Minghu00/fpga-voice-synth/docs/figures/fig10_photo.png

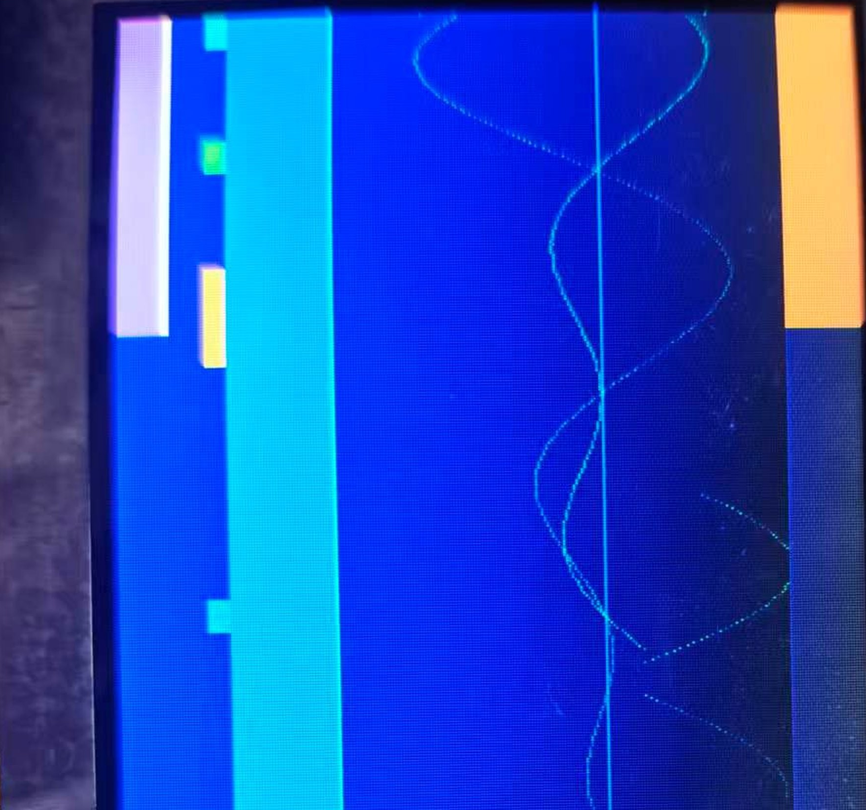
docs/figures/fig10_photo.png
