Minghu00/fpga-voice-synth/docs/figures/fig7_screen.png

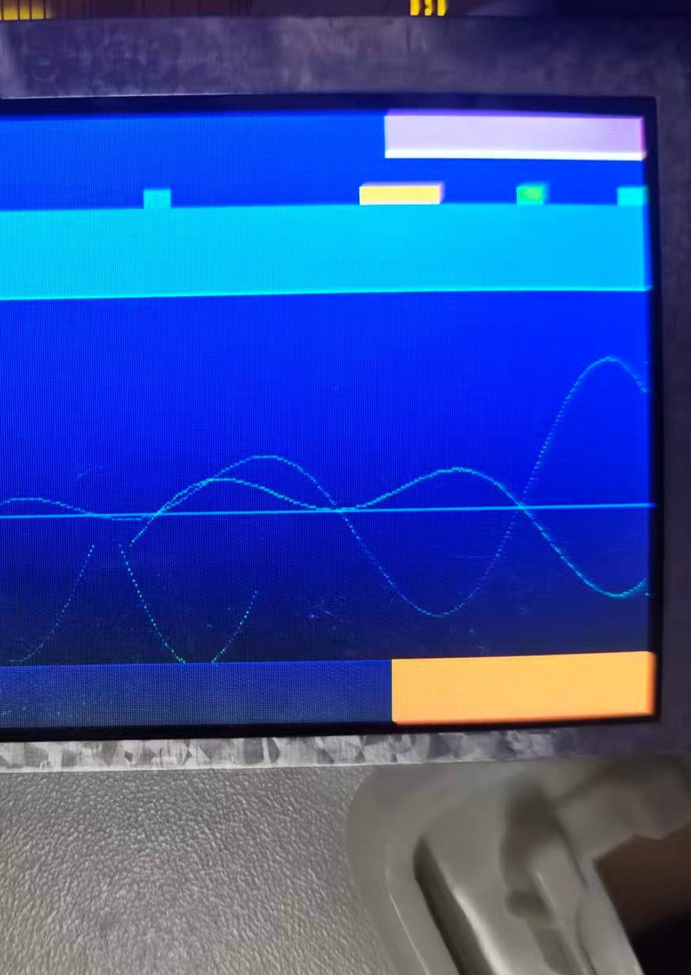
docs/figures/fig7_screen.png
