Minghu00/fpga-voice-synth/docs/datasheet_ttp229/TTP229_SPEC_V1.1(Simplified_Chinese).txt

Preliminary TTP229 
TonTouchTM               

0 9 ’ / 1 2 / 2 1                                    P a g e  1  o f  1 9                                   V e r  :  1 . 1  
16 键/8键触摸检测 IC 
                                             
概述 
 
TTP229 TonTouchTM IC是一款使用电容感应式原理设计的触摸芯片。此芯片内建稳压电路供
触摸传感器使用， 稳定的触摸效果可以应用在各种不同应用上,人体触摸面板可以通过非导电性绝
缘材料连接，主要应用是以取代机械开关或按钮,此芯片可以独立支持8个触摸键或16个触摸键. 
 
特点 
 
 工作电压：2.4V~5.5V（启用内建稳压电路） 
2.0V~5.5V（禁用内建稳压电路） 
 可外部选择启用/禁用内建稳压电路功能 
  待机电流 
3V电压，低速采样率8Hz的睡眠模式下： 
启用内部稳压器，待机电流 
=> 16键模式下典型值2.5uA 
=> 8键模式下典型值2.0uA 
禁用内部稳压器，待机电流 
=> 16键模式下典型值2.5uA 
=> 8键模式下典型值2.0uA 
 提供Option选择8键或16键模式. 
 提供8个直接输出独立端口,仅限于8键直接输出模式下 
 具有两种串行输出方式，可以应用在8个和16个键模式 
   包括2-线串行模式和I2C通讯模式,由option所选择. 
 8个直接输出端口可以选择不同输出类型（CMOS/OD/OC具有高/低电平有效） 
 2-线串行模式可option选择高电平有效或低电平有效 
 提供option选择多键或单键有效功能 
  提供两种采样率，睡眠模式下采样率 8Hz，快速采样率 64Hz 
 具有Option选择有效键最大输出时间大约为80秒. 
 灵敏度可由外部电容（1~50pF）调节 
 上电后需要0.5秒稳定时间 
在此期间内请勿触摸按键面板，所有的功能触摸也无效. 
 自动校准 
当所有按键在一段时间内没有被触摸到时,芯片系统重新校准时间约为4.0秒 

应用 
 
 广泛的消费电子产品 
 按钮取代 
 
Preliminary TTP229 
TonTouchTM               

0 9 ’ / 1 2 / 2 1                                    P a g e  2  o f  1 9                                   V e r  :  1 . 1  
方块图 
 
封装配置 
REGEN
VSS
ENSLP
VREG
VDD
TP4
TP5
SENADJ1
TP6
TP7
SLSERT
A0
A1
A2
TEST
TP8
TP9
SENADJ2
TP10TP11
SLPSENB
SCL
SDO
SDA
TP12
TP13
SENADJ3
TP14
TP15
TP0
TP1
SENADJ0
TP2
TP3
SLPSENA
(SSOP-48)
TTP229
48
47
46
45
44
43
42
41
40
39
38
37
36
35
34
33
32
31
30
29
28
27
26
2524
23
22
21
20
19
18
17
16
15
14
13
12
11
10
9
8
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
 
I2C总线接口 
控制电路 SDA
SDO
SCL
A2 
A1 
A0 
TEST 
SLSERT 
ENSLP 
REGE
唤醒检测
控制电路
SLPSENB 
SLPSENA 
SENADJ3
SENADJ2
TP15
TP14
TP13
TP12
TP11
TP10
TP9
TP8
串行输出缓冲 
和 
控制电路 
系统上电电路
输出缓冲 
和 
感应输入电路 
系统晶振电路
计时计数 
按键扫描 
和 
功能控制电路
稳压器电路 VREG 
功能选项
控制电路
感应端口
和 
检测电路
TP7 
TP6 
TP5 
TP4 
SENADJ1 
TP3 
TP2 
TP1 
TP0 
SENADJ0 
Preliminary TTP229 
TonTouchTM               

0 9 ’ / 1 2 / 2 1                                    P a g e  3  o f  1 9                                   V e r  :  1 . 1  
管脚定义 
管脚号 管脚名 共用端口 I/O 类型 管脚描述 
1 TP15 TPQ7 I/O/OD 16 键模式下触摸输入端口(KEY-15) 
8 键模式下直接输出端口(TPQ7) 
2 TP14 TPQ6 I/O/OD 16 键模式触摸输入端口(KEY-14) 
8 键模式直接输出端口(TPQ6) 
3 SENADJ3  I/O 触摸键 TP12~15灵敏度调节共用端口 
4 TP13 TPQ5 I/O/OD 16 键模式触摸输入端口(KEY-13) 
8 键模式直接输出端口(TPQ5) 
5 TP12 TPQ4 I/O/OD 16 键模式触摸输入端口(KEY-12) 
8 键模式直接输出端口(TPQ4) 
6 SDA  I/OD 在 I2C串行通讯方式下为数据端口 
7 SDO  O 在 2-线串行通讯方式下为数据输出端口，由 TP1 可选
高/低电平有效 
8 SCL  I 串行时钟输入端口 
2-线串行模式下可由 TP1选择低/高电平有效 
9 SLPSENB  I/O 睡眠模式 B组(TP8~15)灵敏度调节端口 
10 TP11 TPQ3 I/O/OD 16 键模式触摸输入端口(KEY-11) 
8 键模式直接输出端口(TPQ3) 
11 TP10 TPQ2 I/O/OD 16 键模式触摸输入端口(KEY-10)  
8 键模式直接输出端口(TPQ2) 
12 SENADJ2  I/O 触摸键 TP8~11灵敏度调节共用端口 
13 TP9 TPQ1 I/O/OD 16 键模式触摸输入端口(KEY-9) 
8 键模式直接输出端口(TPQ1) 
14 TP8 TPQ0 I/O/OD 触摸键输入端口(KEY-8) 
8 键模式直接输出端口(TPQ0) 
15 TEST  I-PL 仅供测试使用 
16 A2  I-PH A2~0 是选择 I2C总线设备地址的输入端口 
17 A1  I-PH A2~0 是选择 I2C总线设备地址的输入端口 
18 A0  I-PH A2~0 是选择 I2C总线设备地址的输入端口 
19 SLSERT  I-PH 串行输出类型的选择端口 
默认 2-线串行传输 
20 TP7 SKSRT I/O 触摸键输入端口(KEY-7) 
有效按键最长输出时间选择(无穷大/80 秒) 
默认为无穷大 
21 TP6 SLWPTM I/O 触摸键输入端口(KEY-6) 
睡眠模式采样时间功能选项(4.0/2.0毫秒) 
默认 4.0 毫秒 
22 SENADJ1  I/O 触摸键 TP4~7灵敏度调节共用端口 
 
Preliminary TTP229 
TonTouchTM               

0 9 ’ / 1 2 / 2 1                                    P a g e  4  o f  1 9                                   V e r  :  1 . 1  
 
管脚号 管脚名 共用端口 I/O 类型 管脚描述 
23 TP5 WPSCT I/O 触摸键输入端口(KEY-5) 
睡眠模式采样率功能选项(8Hz/64Hz) 
默认为 8Hz 
24 TP4 SKMS0 I/O 触摸键输入端口(KEY-4) 
按键有效功能选项 0(单键/多键) 
默认全部单键有效 
25 VDD  P 供电电源正极 
26 VREG  P 内部稳压电路输出端口 
27 ENSLP  I-PH 睡眠模式启用/禁用功能选项 
默认为启用 
28 VSS  P 供电电源负极，接地端 
29 REGEN  I-PH 内部稳压电路启用/禁用功能选项 
默认为启用 
30 SLPSENA  I/O 睡眠模式 A组(TP0~7)灵敏度调节端口 
31 TP3 SKMS1 I/O 触摸键输入端口(KEY-3) 
按键有效功能选项 1(单键/多键) 
默认为全部单键 
32 TP2 KYSEL I/O 触摸键输入端口(KEY-2) 
按键数目功能选项(8 键/16 键) 
默认为 8 键 
33 SENADJ0  I/O 触摸键 TP0~3灵敏度调节共用端口 
34 TP1 SAHL I/O 触摸键输入端口(KEY-1) 
输出类型功能选项(高/低电平有效) 
默认 TPQ0~7 高电平有效，2-线串行低电平有效(SCL
和 SDO) 
35 TP0 OPDEN I/O 触摸键输入端口(KEY-0) 
输出类型功能选项 (CMOS/OD/OC 在 8 键模式)  
默认为 CMOS 
 
  备注：端口类型 
I     ＝＞仅CMOS输入 
I-PH  ＝＞CMOS输入带上拉电阻 
I-PL  ＝＞CMOS输入带下拉电阻 
O    ＝＞CMOS输出 
I/O   ＝＞CMOS输入/输出 
P     ＝＞电源/地 
OD   ＝＞CMOS漏极开路(Open Drain)输出 
(OD输出下，TPQ0~TPQ7 端口具有二极管保护电路，SDA 端口无二极管保护电路) 
Preliminary TTP229 
TonTouchTM               

0 9 ’ / 1 2 / 2 1                                    P a g e  5  o f  1 9                                   V e r  :  1 . 1  
PAD 图 

芯片尺寸：1700um x 1820um 
衬底悬空(建议)或连接至VSS 
 
PAD 坐标 
Pad NO. Pad Name X Y Pad NO. Pad Name X Y 
1 TP15 -750.00 95.15 19 SLSERT   750.00  -335.35 
2 TP14 -750.00 -28.85 20 TP7   750.00  -218.35 
3 SENADJ3 -750.00 -369.50 21 TP6   750.00  -101.35 
4 TP13 -750.00 -493.50 22 SENADJ1   750.00    15.65 
5 TP12 -750.00 -617.50 23 TP5   750.00   438.60 
6 SDA -539.90 -810.00 24 TP4   750.00   555.60 
7 SDO -424.90 -810.00 25 VDD   675.85   810.00 
8 SCL -309.90 -810.00 26 VREG   558.85   810.00 
9 SLPSENB -194.90 -810.00 27 ENSLP   421.15   810.00 
10 TP11 -79.90 -810.00 28 VSS   304.15   810.00 
11 TP10 35.10 -810.00 29 REGEN   187.15   810.00 
12 SENADJ2 150.10 -810.00 30 SLPSENA  -460.85   810.00 
13 TP9 265.10 -810.00 31 TP3  -577.85   810.00 
14 TP8 380.10 -810.00 32 TP2  -750.00   591.15 
15 TEST 495.10 -810.00 33 SENADJ0  -750.00   467.15 
16 A2 750.00 -686.35 34 TP1  -750.00   343.15 
17 A1 750.00 -569.35 35 TP0  -750.00   219.15 
18 A0 750.00 -452.35     
Preliminary TTP229 
TonTouchTM               

0 9 ’ / 1 2 / 2 1                                    P a g e  6  o f  1 9                                   V e r  :  1 . 1  
电气特性 
‧最大绝对额定值 
 
‧AC/DC特性：(测试条件为室内温度=25℃) 
 
参数 符号 条件 数值 单位 
工作温度 TOP ─ -40 ~ +85 ℃ 
储存温度 TSTG ─ -50 ~ +125 ℃ 
电源电压 VDD Ta=25°C VSS-0.3 ~ VSS+6.0 V 
输入电压 VIN Ta=25°C VSS-0.3 to VDD+0.3 V 
抗静电能力HBM ESD ─ 6 KV 
备注：VSS表示系统接地 
参数 符号 测试条件 最小 典型 最大 单位
工作电压 VDD 内部稳压电路禁用 2.0 - 5.5 V 
工作电压 VDD 内部稳压电路启用 2.4 - 5.5 V 
内部稳压电路输出 VREG  2.2 2.3 2.4 V 
稳压电路启用  20  工作电流 
(无负载) 
IOP VDD 
=3.0V 稳压电路禁用  25  
uA 
稳压电路启用  2.0  8 键
稳压电路禁用  2.0  
稳压电路启用  2.5  
采样率
8Hz 
16键
稳压电路禁用  2.5  
稳压电路启用  5.5  8 键
稳压电路禁用  5.5  
稳压电路启用  9.0  
待机电流 
(VDD=3.0V) 
(采样时间 4.0 毫秒) 

ISD 采样率
64Hz 
16 键
稳压电路禁用  9.5  

uA 
 
输入端口 VIL 输入低电压范围 0 - 0.2 VDD
输入端口 VIH 输入高电压范围 0.8 - 1.0 VDD
输出端口灌电流（Sink Current） IOL VDD=3V , V OL=0.6V - 8 - mA
输出端口拉电流（Source Current） IOH VDD=3V , V OH=2.4V - -4 - mA
VDD=3V , 采样率 8Hz  125  mS 唤醒响应时间 
(睡眠模式下) 
TWU 
VDD=3V , 采样率 64Hz  15.6  mS 
VDD=3V , 设为 16 键模式  32  mS 输出响应时间 
(工作状态下) 
TR 
VDD=3V , 设为 8 键模式  16  mS 
有效键最大输出时间 TMOT  50 80 110 Sec 
输入端口上拉电阻 
(REGEN, SLSERT, ENSLP, 
A0~A2) 
RPH VDD=3V ,  30K  ohm
输入端口下拉电阻 
(TEST) 
RPL VDD=3V ,  30K  ohm
Preliminary TTP229 
TonTouchTM               

0 9 ’ / 1 2 / 2 1                                    P a g e  7  o f  1 9                                   V e r  :  1 . 1  
功能描述 
1. 灵敏度调节 
  P C B板上之感应焊盘尺寸大小及走线会直接影响灵敏度,因此灵敏度调节需要根据实际应用的
PCB应进行调节,TTP229提供一些外部调节灵敏度的方法。 
1-1 改变感应焊盘尺寸大小 
若其他条件固定不变,使用一个较大的感应焊盘将会增大其灵敏度,反之灵敏度将下降,但是
感应焊盘的尺寸大小也必须是在其有效范围值内.。 
1-2 改变面板厚度. 
若其他条件固定不变,使用一个较薄的面板也会将灵敏度提高,反之灵敏度则下降.但是面板
的厚度必须低于其最大值。 
1-3 通过调节外接电容(参见下图1-3-1) 
当其他条件固定时，在可用范围(1pF≦CJ0~CJ3≦50pF, 1pF≦CJWA~CJWB≦50pF)内增大
CJ0~CJ3，CJWA和CJWB的值将降低灵敏度。当不连接任何电容，即在电容连接处处于悬
空其灵敏度为最大。电容CJ0~CJ3用于调节工作模式下按键的灵敏度。电容CJWA和CJWB
用于调节睡眠模式下唤醒灵敏度。  
至于各电容与各键其关系如下表 
电容 可控制和调节的按键组合 
CJ0 K0~K3 组 
CJ1 K4~K7 组 
CJ2 K8~K11组 
CJ3 K12~K15组 
CJWA K0~K7组 
CJWB K8~K15组 
备注：当使用电容调节灵敏度时，建议先调节CJ0~CJ3的容值去调节K0~K15的灵敏度，然
后再调节CJWA和CJWB的容值去调节唤醒灵敏度。 
 
                                   图 1-3-1 
触摸焊盘 
SDO
A0
A1
A2
SCL
SDA
CJWB
SLPSENB
VREG
SLSERT
ENSLP
TEST
REGEN
CJWA 
K12 
K11 
K10 
K9 
K8 
K15 
K14 
K13 
CJ3
SLPSENA
K7 
K6 
K5 
K4 
CJ1 
VSS
TP9
TP8
SENADJ0
TP0
TP7
TP6
TP5
TP4
TP3
TP2
TP1
VDD
SENADJ1
TP15
TP14
TP13
TP12
SENADJ3
TP11
TP10
SENADJ2
CJ2CJ0
K3 
K2 
K1 
K0 
Preliminary TTP229 
TonTouchTM               

0 9 ’ / 1 2 / 2 1                                    P a g e  8  o f  1 9                                   V e r  :  1 . 1  
2. 输入按键数目选择 
     T T P 2 2 9 具有 8 键输入模式和 16 键输入模式。两者是通过 TP2(KYSEL)是否连接高阻值电阻到
VSS所决定。默认为 TP2(KYSEL)不连接电阻到 VSS选定为 8 键输入模式,16 键输入模式是连接
高阻值电阻到 VSS。 
 
3. 输出模式 
     T T P 2 2 9 具有 8 端口直接输出模式和两种串行输出模式。16 键输入模式下只能使用串行输出方
式。8 键输入模式下可使用两种输出方式，为 8 端口直接输出和串行输出方式。8 端口直接输
出方式只能应用在 8 键直接输出模式下。两种串行输出方式包括 I2C和 2-线串行通讯方式。此
两种方式共用 SCL作为时钟输入端口。这两种模式通过SLSERT选择，同一时间只能选择一种
通讯方式。SLSERT悬空(默认)或连接到 VDD将设置为 2-线串行通讯方式，当SLSERT链接到
VSS时，设置为 I2C 通讯方式。 
 
     3 - 1  在 8 端口直接输出模式下，TTP229具有两种输出类型，CMOS类型输出和 OD(漏极开路)
类型输出。这两者通过 TP0(OPDEN)选择。默认为 CMOS类型，即 TP0(OPDEN)不连接高阻值
电阻到 VSS。当 TP0(OPDEN) 连接高阻值电阻到 VSS 时，选择为 OD类型输出。 
 
     3-2 当选用 8 端口直接 COMS输出模式，输出有效电平可以通过 TP1(SAHL) 端口设置为高电
平有效或低电平有效。默认 TP1(SAHL) 端口不连接高阻值电阻到 VSS，输出设置为高电平有效。
当 TP1(SAHL) 端口连接高阻值电阻到 VSS 时，输出设置为低电平有效。 
 
     3-3 在 8 端口直接 OD输出模式下，可通过 TP1(SAHL) 端口选择为 OD(漏极开路)或 OC(集极
开路) 输出方式。若 TP1(SAHL) 端口连接高阻值电阻到 VSS，即选为 OC输出模式。若不连接
高阻值电阻则选用默认的 OD输出模式。OD 模式下其平常为悬浮状态, 输出为低电平有效，
OC模式下其平常为悬浮状态, 输出为高电平有效。OD 和 OC输出模式的结构如下图。 
P
N
Control
Control
TPQ0~7
OC ModeOD Mode
TPQ0~7
 
备注：芯片输出端口内部具有二极管保护电路,因此当选用 OD或 OC 输出模式时,为避免系统内
部漏电流, 请不要与不同电压的系统直接连接. 
 
     3-4 2-线串行输出通讯方式可由 SLSERT 端口是否悬空或连接到 VDD选定。在此模式下，SDO 
端口为数据输出端口，SCL是时钟输入端口，两者皆可由 TP1(SAHL) 端口选择为高电平有效还
是低电平有效。 默认为TP1(SAHL) 端口不连接高阻值电阻到 VSS设置为低电平有效。 若连接高
阻值电阻到 VSS，则设置为高电平有效。 
      
2-线串行输出方式它支持连续接受其它系统送给的数据，也可以让其他设备等待 TTP229 通过
SDO 端口送出的数据信号(DV)，然后再送出时钟信号到 TTP229 的 SCL 端口并从 SDO 端口
取得按键数据。 
 
     T T P 2 2 9 的 2-线串行通讯方式对 SCL 端口设有时间的限制。如果 SCL 端口超过 2ms信号没有
变化，系统将会自行回到待机模式。 

Preliminary TTP229 
TonTouchTM               

0 9 ’ / 1 2 / 2 1                                    P a g e  9  o f  1 9                                   V e r  :  1 . 1  
2-线串行通讯方式时序如下图所示： 
D0~D15对应于 TP0~TP15 上数据。 
  3-4-1. 当TP1=0，TP2=0：设置为16键模式，高电平有效 
Tw TwTout
T_resp
DVDV
SDO
SCL
F_SCL
D0 D1
C_1C_0
D0 D1
C_1C_0
D12D11D10D9D8D7D6D5D4D3D2 D13 D14 D15
C_15C_14C_13C_12C_11C_10C_9C_8C_7C_6C_5C_4C_3C_2
 
                     图3-4-1：16键输入，高电平有效时序 
 
  3-4-2. 当TP1=1，TP2=0：设置为16键模式，低电平有效 
TwToutTw
T_resp
DVDV
SDO
SCL
F_SCL
D0 D1
C_1C_0
D0 D1
C_1C_0
D12D11D10D9D8D7D6D5D4D3D2 D13 D14 D15
C_15C_14C_13C_12C_11C_10C_9C_8C_7C_6C_5C_4C_3C_2
 
                     图3-4-2：16键输入，低电平有效时序 
 
3-4-3. 当TP1=0，TP2=1：设置为8键模式，为高电平有效  
 
                     图3-4-3：8键输入，高电平有效时序 
 
  3-4-4. 当TP1=1，TP2=1：设置为8键模式，低电平有效
Tw TwTout
T_resp
DV
D0 D1
C_1C_0
DV
SDO
SCL
F_SCL
D0 D1
C_1C_0
D7D6D5D4D3D2
C_7C_6C_5C_4C_3C_2
 
                     图3-4-4：8输入键，低电平有效时序 
 
  图3-4-1~4中参数 
参数 最小值 典型值 最大值 单位 
DV - 93 - us 
Tw 10 - - us 
Tout - 2 - ms 
T_resp(16键) - 32 - ms 
T_resp(8键) - 16 - ms 
F_SCL 1K - 512K Hz 
Tw TwTout
T_resp
DV
D0 D1
C_1C_0
DV
SDO
SCL
F_SCL
D0 D1
C_1C_0
D7D6D5D4D3D2
C_7C_6C_5C_4C_3C_2
Preliminary TTP229 
TonTouchTM               

0 9 ’ / 1 2 / 2 1                                    P a g e  1 0  o f  1 9                                   V e r  :  1 . 1  
3-5 至于选择为 I2C通讯方式，需要将 SLSERT 端口连接到 VSS。 
此模式下 SDA 端口作为串行数据端口，SCL 作为串行时钟输入端口。SDA和 SCL 端口必须
通过外部电阻拉至高电平。 
 
TTP229的 4 位鉴别码是“1010”, 设备地址由 A0，A1 和 A2 端口的状态确定。这三个端口具
有内部上拉电阻，可由外部设定为 0。TTP229 的 8 位设备地址包含 4 位鉴别码，3 位地址选定
和 R/W位组成(参见表 3-5-1)。 
 
由于 TTP229 IC 使用 I2C通讯协议方式输出触摸键(TP0~TP15 端口)的数据，因此TTP229 只接
受读操作 R/W位是”1” 的数据”。如果为“0”，TTP229 将不响应写操作。除此之外，TTP229
的 I2C通讯协议符合标准的 I2C通讯协议。它支持最大 SCL时钟频率为 400KHz的快速模式。 
I2C通讯方式协议如下： 
 
总线空闲状态：当总线空闲时 SDA 和 SCL 保持在高电平。 
起始条件：开始条件是当 SCL=1 时，SDA 由 1 跳转到 0。(参见图 3-5-2) 
终止条件：停止条件是当 SCL=1 时，SDA 由 0 跳转到 1。(参见图 3-5-2) 
数据有效条件：开始条件成立后，SDA pin上的电平在 SCL为高电平期间内必须稳定。SDA pin
上的高低电平只有在 SCL线上时钟信号为低电平时可以改变。(参见图 3-5-2) 
 
回应(确认)：一个 ACK信号表示成功完成数据传输。传输方（主设备或从设备）在传输八个二
进制位后释放总线。 在主设备发出的第九个时钟周期接收方将SDA 线拉至低电平， 以确认成功
接收数据的八个二进制位。从设备没有成功接收到数据的八个二进制位时，将不会发送 ACK
信号。 
 
在数据读取操作，从设备在传输完 8 位数据后释放 SDA 线，然后在第九个时钟周期监察 ACK
信号。若检测到 ACK信号，从设备将继续传送下一个数据。若没有检测到 ACK信号，从设备
中止数据传送，并在回到待机模式前等待主设备发起停止条件。 

从设备地址： TTP229 的鉴别码是“(1010)”。设备地址可由 A2，A1和 A0 端口的状态设定。 
读/写：从设备地址的最后一位（第八位）定义将进行的操作类型。如果 R/W 位是“1”，将执
行读操作，如果是“0”，则执行写操作。但 TTP229只接受读操作。 
读数据操作的顺序参照图 3-5-1。 
  
表 3-5-1. 从设备寻址 
设备鉴别码 设备地址 R/W 位 设备 
B7 B6 B5 B4 B3 B2 B1 B0 
TTP229 1 0 1 0 A2 A1 A0 R 
 
Preliminary TTP229 
TonTouchTM               

0 9 ’ / 1 2 / 2 1                                    P a g e  1 1  o f  1 9                                   V e r  :  1 . 1  
 
   备注：Data_0：B7~B0对应TP0~TP7 闭合/断开状态，0为按键断开，1为按键闭合。 
        D a t a _ 1 ：B7~B0对应TP8~TP15 闭合/断开状态，0为按键断开，1为按键闭合。 
图3-5-1. 读操作顺序 

                         图3-5-2. 数据传输顺序 

                         图3-5-3. 一次完整的数据传送 
BUFt
SU;STO
rtrt
t
HD;STAt
SU;STAt
ftft SU;DATt
HIGHtHD;STAt HD;DATt
LOWt
SPSrS
SCL
SDA
 
               图3-5-4. I2C总线上F/S模式设备的时序定义 
 
起始 
条件 
终止
条件
ACK 数据ACK数据ACK R/W 地址 
S P
9 9 8 8 1 - 71 - 79 8 1 - 7 SCL 
SDA 
起始条件 
P
终止条件数据变化数据或 
合法 ACK
SCL 
S 
SDA 
8键输入模式
终止Data_0起始 从设备地址 
B0B1B2B3B4B5B6B7 R A0 A1A2 
16键输入模式
主设备 
发送的 
NOT ACK 
主设备
发送的
ACK
从设备 
发送的 
ACK 
起始 从设备地址 Data_0 Data_1 终止
B0 B1 B2 B3B4B5B6B7B0B1B2B3B4B5B6B7 R A0 A1A2 
从设备 
发送的 
ACK 
主设备 
发送的 
NOT ACK
Preliminary TTP229 
TonTouchTM               

0 9 ’ / 1 2 / 2 1                                    P a g e  1 2  o f  1 9                                   V e r  :  1 . 1  
 表3-5-2. I2C总线F/S模式设备的SDA和SCL总线连线特性 
标准模式 快速模式 参数 符号 
最小值 最大值 最小值 最大值 
单位
SCL时钟频率 f SCL  100  400 KHz 
SCL时钟的低电平时间 t LOW 4.7  1.3  us 
SCL时钟的高电平时间 t HIGH 4.0  0.6  us 
起始条件保持时间（重复） t HD;STA 4.0  0.6  us 
起始条件建立时间 t SU;STA 4.7  0.6  us 
数据保持时间 t HD;DAT 0  0  us 
数据建立时间 t SU;DAT 250  100  ns 
SDA和SCL信号的上升时间 t r  1000  300 ns 
SDA和SCL信号的下降时间 t f  300  300 ns 
终止条件建立时间 t SU;STO 4.0  0.6  us 
一次终止条件和起始条件之间总
线空闲时间 
tBUF 4.7  1.3  us 
单条总线连线上容性负载 C b  400  400 pF 
 
4. 按键工作模式 
     T T P 2 2 9 具备单键有效和多键有效功能。这些功能由TP3(SKMS1)和 TP4(SKMS0) 端口设定。全部
16 个按键可分为一组或两组进行设置。第一组包括 TP0，TP1，TP2，TP3，TP8，TP9，TP10，
TP11按键。组-2 包括 TP4，TP5，TP6，TP7，TP12，TP13，TP14，TP15 按键。设置方式参见
表 4-1： 
     表 4-1. TP3(SKMS1)和 TP4(SKMS0)选项功能如下: 
TP3 
(SKMS1) 
TP4 
(SKMS0) 
功能说明 
0 0 全部多键有效：设定为一组（16键） 
0 1 设置为2组：第一组=>单键；第二组=>多键 
1 0 设置为2组：第一组=>单键；第二组=>单键 
1 1 全部单键有效：一组（16键） 
     备注：1. 设定为一组: 
其包括：TP0~TP15。 
             设定为二组： 
第一组其包括=>TP0，TP1，TP2，TP3，TP8，TP9，TP10，TP11。 
             第二组其包括=>TP4，TP5，TP6，TP7，TP12，TP13，TP14，TP15。 
           2 .  当使用 8 模式时 TP0~TP7 为输入键。 
           3 .  T P 3 和 TP4的选择状态，“0”状态是指连接高阻值电阻到 VSS，“1”状态是不连接高
阻值电阻到 VSS。 
           4 .  在单键有效功能下， 键的检测承认优先权是依键的扫描顺序(从 TP0 到 TP15)， 当同时
多键被有效触摸。不是依照键被触摸的强度。 
Preliminary TTP229 
TonTouchTM               

0 9 ’ / 1 2 / 2 1                                    P a g e  1 3  o f  1 9                                   V e r  :  1 . 1  
5. 睡眠模式的唤醒采样率和采样长度 
TTP229在睡眠模式具有两种采样率， 分别是8Hz和 64Hz。 这两种功能由TP5(SLWPTM) 端口选
择。TP5(SLWPTM) 端口连接高阻值电阻到 VSS时，选择为 64Hz采样率。当不连接高阻值电阻
到 VSS时，将默认选为 8Hz采样率。 
 
     T T P 2 2 9 在睡眠模式下有两种采样长度，分别是 4ms和 2ms，由 TP6(WPSCT) 端口选定。默认情
形下 TP6(WPSCT) 端口不连接高阻值电阻到 VSS，将选择为 4ms。若 TP6连接高阻值电阻到 VSS
时将设定为 2ms。 
 
睡眠模式的唤醒采样率和采样长度： 

6. 有效键最长输出时间 
如果因其它非正常因素造成有物体触摸到键并且电容量改变足够以被承认为有效触摸,会使其
一直动作,为了防止此类现象的发生，所以 TTP229设计了有效键最长输出时间设定电路,此计
时即为有效按键最长输出时间，若 VDD为 3V时大约为 80 秒。当物体触摸时间超过所设定时
间时，系统将会返回到上电初始化状态并停止输出直到下一次被触摸时,此功能由 TP7(SKSRT) 
端口连接高阻值电阻到 VSS所设定。默认为 TP7(SKSRT) 端口不连接高阻值电阻到 VSS，将设
置为禁用最长输出时间设定，此时按键时间为无穷大。若连接高阻值电阻到VSS 时，则启用有
效键最长输出时间设定功能。 
 
若系统同时使用有效键最长输出时间设定和 2-线串行通讯方式功能时， 它只能使用接受其它
系统连续送数据的通讯方式。 
 
7. 外部选择启用/禁用内建稳压电路 
电容式触摸 IC 要求需要稳定的电源，因此TTP229在芯片内设置了稳压电路。此稳压电路可以
使内部电源稳定,维持芯片检测灵敏度一致。稳定的电源能避免其灵敏度异常导致错误的触发。 
内建稳压电路可通过 REGEN 端口设置为启用或禁用。当 REGEN 端口连接到 VDD或悬空时，
将启用内部稳压电路。当 REGEN 连接到 VSS 时，则禁用内部稳压电路。当内部稳压电路被禁
用时，必须将 VREG 端口连接到外部 VDD。 
   
8. 自动校准功能 
  TTP229具备自校准功能, 系统上电时将首先对起始环境做自动校准。在此期间，所有的功能都
被禁用，因此请不要对PAD做触摸或其他操作。此后系统进入到待机模式。若所有的按键在4
秒内没有检测到触摸，系统将会自动重新校准。此过程将持续重复进行。此自动重新校准的特
性实现了使系统随环境变化，系统可以正常工作的目的。 
 
或 
8Hz=>125ms 
4.0ms或 2.0ms64Hz=>15.6ms 
唤醒 
检测 
时钟 
Preliminary TTP229 
TonTouchTM               

0 9 ’ / 1 2 / 2 1                                    P a g e  1 4  o f  1 9                                   V e r  :  1 . 1  
9. 由睡眠模式转到工作模式的时序图  

 图9-1. 错误触发的时序 

 图9-2. 正确触发的时序 
 
有效触发 
当检测到按键释放且约 8 秒没有触发 
约 4 秒约 4 秒
睡眠模式
重校准 重校准
检测按键 
输出 
唤醒检测 
周期 
睡眠模式 
工作模式
手指触发 
按键扫描 
周期 
重校准 
唤醒检测 
周期 
睡眠模式
约 4 秒时间约 4 秒时间 
重校准
按键扫描 
错误触发 
睡眠模式 
检测按键 
输出 
手指触发 
按键扫描 
周期 
Preliminary TTP229 
TonTouchTM               

0 9 ’ / 1 2 / 2 1                                    P a g e  1 5  o f  1 9                                   V e r  :  1 . 1  
10. 选项表格 
选项表格： 
选项端口 选项状态 特性 注释 
TP0 
(OPDEN) 
TP1 
(SAHL)
1 1 

8 pin 直接输出模式=> CMOS高电平有效输出 
2-线串行输出 => CMOS 低电平有效输出 
 
默认 
1 0 8 pin 直接输出模式=> CMOS低电平有效输出 
2-线串行输出=> CMOS高电平有效输出 
 
0 1 8 pin 直接输出模式=> OD低电平有效输出 
2-线串行输出=> CMOS低电平有效输出 

TP0 
(OPDEN) 

TP1 
(SAHL) 
0 0 8 pin 直接输出模式=> OC高电平有效输出 
2-线串行输出=> CMOS高电平有效输出 
 
1 8 键输入模式 默认 TP2 
(KYSEL) 0 16 键输入模式  
TP3 
(SKMS1) 
TP4 
(SKMS0) 
1 1 
 
全部单键有效：设定为一组（16 键） 
 
默认 
1 0 设定为二组： 
第一组=>单键；第二组=>单键 
 
0 1 两组操作： 
组-1=>单键；组-2=>多键 

TP3 
(SKMS1) 

TP4 
(SKMS0) 
0 0 全部多键有效：设定为一组（16 键）  
1 睡眠模式下 8Hz唤醒采样率 默认 TP5 
(WPSCT) 0 睡眠模式下 64Hz唤醒采样率  
1 唤醒采样长度=>约 4.0ms 默认 TP6 
(SLWPTM) 0 唤醒采样长度=>约 2.0ms  
1 禁用有效按键最大输出时间设定=>无穷大 默认 TP7 
(SKSRT) 0 启用有效按键最大输出时间设定=>80 秒  
1 启用内部稳压电路 默认  
REGEN 0 禁用内部稳压电路  
1 串行输出通讯类型选择=>2-线串行通讯方式 默认  
SLSERT 0 串行输出通讯类型选择=>I2C通讯方式  
1 启用睡眠模式 默认  
ENSLP 0 禁用睡眠模式  
备注：1. 关于第一组和第二组的组成，请参照上面第4点。 
2. 选项中状态“1”表示内部上拉（默认） 
      3 .  选项中状态“0”表示TP0~TP7 端口连接高阻值电阻到VSS，另外REGEN，SLSERT和
ENSLP 端口是可以直接连接到VSS。 
Preliminary TTP229 
TonTouchTM               

0 9 ’ / 1 2 / 2 1                                    P a g e  1 6  o f  1 9                                   V e r  :  1 . 1  
应用电路 
                                1 6 键模式参考应用电路图 
 
SKSRT
SLWPTM
WPSCT
SKMS0
SKMS1
KYSEL
SAHL
K12
CJWB
CJWA
TCP229
ELECTRODE
SLSERT
SENADJ1
SLPSENA
SENADJ0
SENADJ3
SLPSENB
SENADJ2
K9
K8
K10
RP7
K7
RP6
K6
RP5
RP4
K5
K13
K14
CJ1
VDD
CJ2
CJ0
K0
RP1
K1
K2
RP2
RP3
104
C1
CJ3
K11
K4
K3
K15
35
34
33
32
31 30 29 28 27 26 25
24
23
22
21
20
19
18
17
16
1514131211109876
5
4
3
2
1
TEST
TP8
TP9
TP10
TP11
SDA
SCL
SDO
TP12
TP13
A2
A1
A0
TP7
TP6
TP5
TP4
VDD
VREG
ENSLP
VSS
REGEN
TP3
TP2
TP1
TP0
TP14
TP15

Preliminary TTP229 
TonTouchTM               

0 9 ’ / 1 2 / 2 1                                    P a g e  1 7  o f  1 9                                   V e r  :  1 . 1  
                            8 键模式参考应用电路图 
 
SKSRT
SLWPTM
WPSCT
SKMS0
SKMS1
SAHL
OPDEN
CJWA
TPQ7
TPQ6
TPQ5
TPQ4
TPQ0
TPQ1
TPQ2
TPQ3
TCP229
ELECTRODE
SLSERT
SENADJ1
SLPSENA
SENADJ0
SENADJ3
SLPSENB
SENADJ2
RP1
RP0
RP7
K7
RP6
K6
RP5
RP4
K5
CJ1
VDD
CJ0
K0
K1
K2
RP3
104
C1
K4
K3
35
34
33
32
31 30 29 28 27 26 25
24
23
22
21
20
19
18
17
16
1514131211109876
5
4
3
2
1
TEST
TP8
TP9
TP10
TP11
SDA
SCL
SDO
TP12
TP13
A2
A1
A0
TP7
TP6
TP5
TP4
VDD
VREG
ENSLP
VSS
REGEN
TP3
TP2
TP1
TP0
TP14
TP15

 附注：1. 在 PCB上，感应焊盘距离 IC 端口的连线长度越短越好。 
          并且每根感应线不能平行交叉。 
       2 .  电源必须稳定,如果电压不稳定,可能会造成灵敏度异常或错误的触发。 
       3 .  覆盖在 PCB上的面板不能是带有金属成份或其它导电的材料,包括最表面的涂料。 
       4 .  VDD及 VSS必需使用电容器 C1做滤波，同时在布线时 C1电容器必需是最近距离靠
近 IC(TTP229)的 VDD及 VSS管脚之间。 
       5 .  C J 0 ~ C J 3和 CJWA~CJWB的电容值可用于调节对应键的灵敏度。电容值越小，灵敏度
越高。灵敏度的调节必须是根据实际应用的 PCB来做决定。电容值的取值范围是
1pF CJ0~CJ3 50pF≦≦ ，1pF CJW≦ A~CJWB≦50pF。建议先通过调节 CJ0~CJ3 的容值
来调节 K0~K15的灵敏度，再调节 CJWA和 CJWB的容值来调节唤醒灵敏度。 
       6 .  灵敏度调节电容(CJ0~CJ3, CJWA~CJWB) 必须是使用温度变化其稳定性佳的电容,比
如 X7R，NPO。对于触摸应用，推荐使用 NPO 材质电容，以减少因温度变化对灵敏度造
成的影响。 
       7 .  推荐 RP0~RP7使用 1M ohm电阻。 
       8 .  当系统没有使用 TTP229 的串行输出方式，则 TTP229 的 SCL 端口必须被连接到 VDD 或
VSS。 
 
Preliminary TTP229 
TonTouchTM               

0 9 ’ / 1 2 / 2 1                                    P a g e  1 8  o f  1 9                                   V e r  :  1 . 1  
PACKAGE OUTLINE (48 PIN SSOP) 

Preliminary TTP229 
TonTouchTM               

0 9 ’ / 1 2 / 2 1                                    P a g e  1 9  o f  1 9                                   V e r  :  1 . 1  
订购信息 
TTP229 
a. 封装型号：TTP229-XXX 
b. 裸片型号：TCP229 
c. 晶圆：TDP229 
 
修订记录 
1. 2009/10/30 
 - 原始版本：V_1.0 
2. 2009/12/21 =>V_1.1 
 - 增加一些功能上的说明。 
 A. 增加待机电流的说明，在第6页。 
 B. 增加OD和OC输出方式的图示和说明，在第8页的第3-3点···。 
 C. 增加单键功能的说明，在第12页的第4点-备注4 ···。 
 D. 增加SCL端口使用的说明，在第17页附注8 ···。 
 E. 修改封装配置在第2页。 
 F. 修改和增加有效按键最大输出时间，在第1，3，6，13，15页。
