Minghu00/fpga-voice-synth/LCD接口映射.md

# LCD 纯显示位流 —— 硬件接口映射

> 本工程 **只做显示**：无音频、无触摸、无按键。除时钟/复位外，只有屏的 20 根信号线被约束。
> 位流：`impl_lcd_only/pnr/lcd_only.fs`（`GW2A-18C`）

---

## 1. 顶层端口（共 22 个）

```
input  clk27                  27 MHz 晶振
input  rst_n                  复位，低有效
output lcd_dclk               像素时钟 9 MHz
output lcd_hs                 行同步，低有效
output lcd_vs                 场同步，低有效
output lcd_de                 数据使能，高有效
output [4:0] lcd_r            红 5 位，[4]=MSB
output [5:0] lcd_g            绿 6 位，[5]=MSB
output [4:0] lcd_b            蓝 5 位，[4]=MSB
```

## 2. FPGA 球号 ↔ 网络名 ↔ 屏信号 ↔ J7 排线脚号

屏接 Dock 上的 **J7（40P 0.5mm FPC）**，下表左边是约束文件里的球号，右边是屏排线第几脚。

| FPGA 球号 | Bank | 电压 | 网络名（Dock 原理图） | 屏信号 | J7 脚号 |
|---|---|---|---|---|---|
| **H11** | 0 | 3.3 V | `clk27` | 27 MHz 输入 | — |
| **T3** | 4 | **1.5 V** | `Silicon Key_1` | 复位按键（低有效） | — |
| **R9** | 3 | 3.3 V | `RGB_LCD_CLK` | CLK（像素时钟） | 30 |
| **A15** | 7 | 3.3 V | `RGB_LCD_HSYNC` | HSYNC | 32 |
| **D14** | 1 | 3.3 V | `RGB_LCD_VSYNC` | VSYNC | 33 |
| **E15** | 1 | 3.3 V | `RGB_LCD_DE` | DEN / DE | 34 |
| **L9** | 3 | 3.3 V | `RGB_LCD_R0` | R3 | 8 |
| **N8** | 3 | 3.3 V | `RGB_LCD_R1` | R4 | 9 |
| **N9** | 3 | 3.3 V | `RGB_LCD_R2` | R5 | 10 |
| **N7** | 3 | 3.3 V | `RGB_LCD_R3` | R6 | 11 |
| **N6** | 3 | 3.3 V | `RGB_LCD_R4` | R7 | 12 |
| **D11** | 7 | 3.3 V | `RGB_LCD_G0` | G2 | 15 |
| **A11** | 7 | 3.3 V | `RGB_LCD_G1` | G3 | 16 |
| **B11** | 7 | 3.3 V | `RGB_LCD_G2` | G4 | 17 |
| **P7** | 3 | 3.3 V | `RGB_LCD_G3` | G5 | 18 |
| **R7** | 3 | 3.3 V | `RGB_LCD_G4` | G6 | 19 |
| **D10** | 7 | 3.3 V | `RGB_LCD_G5` | G7 | 20 |
| **B12** | 7 | 3.3 V | `RGB_LCD_B0` | B3 | 24 |
| **C12** | 7 | 3.3 V | `RGB_LCD_B1` | B4 | 25 |
| **B13** | 7 | 3.3 V | `RGB_LCD_B2` | B5 | 26 |
| **A14** | 7 | 3.3 V | `RGB_LCD_B3` | B6 | 27 |
| **B14** | 7 | 3.3 V | `RGB_LCD_B4` | B7 | 28 |

### 屏排线 J7 完整定义（Dock 侧）

| 脚 | 信号 | 说明 |
|---|---|---|
| 1 / 2 | LEDK / LEDA | 背光负极 / 正极，接板上 LP3320 升压 |
| 3 / 4 | GND / VCC | 板载供电 |
| 5 / 6 / 7 | R0 / R1 / R2 | **接地**（低 3 位不用） |
| 8–12 | R3–R7 | ← `lcd_r[0..4]` |
| 13 / 14 | G0 / G1 | **接地**（低 2 位不用） |
| 15–20 | G2–G7 | ← `lcd_g[0..5]` |
| 21 / 22 / 23 | B0 / B1 / B2 | **接地**（低 3 位不用） |
| 24–28 | B3–B7 | ← `lcd_b[0..4]` |
| 29 | GND | |
| 30 | CLK | ← `lcd_dclk`（串 100Ω） |
| 31 | DISP | **板上接 +3V3，常使能** |
| 32 | HSYNC | ← `lcd_hs` |
| 33 | VSYNC | ← `lcd_vs` |
| 34 | DEN | ← `lcd_de` |
| 35 / 36 | NC / GND | |
| 37–40 | XR / YD / XL / YU | 电阻触摸屏，**未使用** |

> 所以这块屏在这个板子上实际是 **RGB555 红 / RGB666 绿 / RGB555 蓝**，
> 并不是完整的 888；每通道低位在板上直接接地。这也是为什么 `lcd_r`/`lcd_b` 只有 5 位。

## 3. 需要特别注意的两个脚

| 球号 | 复用功能 | 处理方式 |
|---|---|---|
| **N9** | `SSPI_CS_N/D0` 配置脚 | `set_option -use_sspi_as_gpio 1` 放开 |
| **R9** | `FASTRD_N/D3` 配置脚 | 同上 |

Sipeed 官方这块屏的例程也是这么做的，**不影响 JTAG 烧录**。若不开这个选项，综合会直接报
`ERROR (PR2017) : 'lcd_r[2]' cannot be placed according to constraint`。

## 4. 时序参数

| 参数 | 值 |
|---|---|
| 像素时钟 | **9.000 MHz** = 108 MHz / 12 |
| 有效区 | 480 × 272 |
| H：有效 / 前沿 / 同步脉宽 / 后沿 | 480 / 2 / 41 / 2 → **H_TOTAL 525** |
| V：有效 / 前沿 / 同步脉宽 / 后沿 | 272 / 2 / 10 / 2 → **V_TOTAL 286** |
| HS / VS 极性 | **低有效** |
| DE 极性 | **高有效** |
| 帧率 | 9 000 000 / (525 × 286) = **59.94 Hz** |
| 行周期 | 525 / 9 MHz = **58.33 µs** |

## 5. 屏上应当看到的内容

整屏按 **16 列 × 30 px** 的网格布局，从上到下：

| 行 | 内容 | 判读方式 |
|---|---|---|
| 0–15 | 16 个顶部格子，**其中一个亮白**，每 16 帧右移一格 | 亮块在移动 = 帧在刷新 |
| 16–47 | 灰阶 32 级（每 15 px 一级） | 由黑平滑到白，**无断层、无偏色** |
| 48–95 | 红阶 32 级 | 最右应是很正的红，若偏暗/偏橙 = R 位序错 |
| 96–143 | 绿阶 32 级 | 绿通道 6 位，最右最亮 |
| 144–191 | 蓝阶 32 级 | 若红蓝互换，这里会出现红色 |
| 192–223 | 16 个参考色块 | 黑 红 绿 蓝 黄 品 青 白 / 暗红 暗绿 暗蓝 灰 钢 棕 琥珀 水色 |
| 224–271 | 16 根动态柱（三角波，各列相位差 1/8 周期） | 柱高在来回摆动 = 动画在跑 |

另外有一根**亮白色竖线，每帧右移一列**，480 帧走完一遍（约 8 秒）。
**这根线在动，就说明时钟、行场时序、DE、颜色全部正常。**

## 6. 构建结果（实测）

```
设备        GW2A-18C  (GW2A-LV18PG256C8/I7)
Logic       199 / 20736   ( <1%)     168 LUT + 31 ALU
Register    116 / 16173   ( <1%)
I/O Port     22 / 207     ( 11%)     22 个全部按约束落位成功
BSRAM         0 / 46
rPLL          1 / 4
综合/布线告警  0 条

Constraint   108.000 MHz
Actual Fmax  166.443 MHz   ← 余量 54%
Setup / Hold TNS = 0.000 / 0.000，0 个违例端点
```

自检 `sim/tb_lcd_only.v` **12 项全过**：

```
PASS  DCLK half period : 6 clk        → 9.000 MHz
PASS  HS 525 pixels / VS 286 lines
PASS  每行恰好 480 个有效像素
PASS  红/绿/蓝阶带上半区各 10800 像素   → 恰好 225 列 × 48 行
PASS  红色块 960 像素 / 绿色块 960 像素 → 恰好 30 × 32
PASS  顶部亮块 496 像素                → 30 × 16 加扫线 16
PASS  动态柱已绘制（约 14145 像素）
PASS  相邻两帧柱高不同（动画在跑）
```

## 7. 烧录

1. 打开 Gowin Programmer
2. Device 选 **GW2A-18C**，选 **SRAM Program**（掉电丢失，先验证）或 **External Flash**（固化）
3. 载入 `impl_lcd_only/pnr/lcd_only.fs`
4. Start
5. 若用 Flash 模式，文件选 `impl_lcd_only/pnr/lcd_only.fs`（或 `.bin`，地址 0x000000）

## 8. 排错

| 现象 | 原因 | 处理 |
|---|---|---|
| 全黑，扫线也没有 | 位流没跑 / 27 MHz 没起 | 量 H11 有 27 MHz；确认 DONE 灯亮 |
| 有扫线但整屏白或雪片 | HS/VS 极性反了 | 本屏是**低有效**；若换成高有效屏，去掉 `hsync_n` / `vsync_n` 里的 `~` |
| 图像整体左/右偏、上下偏 | 前后沿参数不符 | 本屏已按 480×272 官方参数配好；换屏只改 `top_lcd.v` 的 `H_FP/H_SYNC/H_BP/V_FP/V_SYNC/V_BP` |
| 红蓝互换 | RGB 位序 | 本工程 `[4]`=MSB 接面板高位；若屏是 `[0]`=MSB，把 cst 里该组顺序倒过来 |
| 灰度带出现条带/断层 | 位宽被截断 | 本屏每通道只有 5/6/5 位，32 级灰阶就是极限，正常 |
| 亮度暗 | 背光 | 板上 BL 由 LP3320 EN 控制，本版**未驱动**，默认最亮；要调光需再加一个 PWM 脚 |
| 画面只显示左半/上半 | H_TOTAL 或 V_TOTAL 不符 | 量 HS 周期应为 58.33 µs，VS 应为 16.683 ms |

## 9. 文件清单

| 文件 | 作用 |
|---|---|
| `rtl/pll_sys.v` | 27 MHz → 108 MHz（rPLL，`IDIV=0 FBDIV=3 ODIV=8`） |
| `rtl/lcd_timing.v` | 480×272 行场时序发生器，`DIV=12` 出 9 MHz |
| `rtl/top_lcd.v` | 纯显示顶层 + 测试图案 |
| `constraints/lcd_only.cst` | 22 个管脚约束 |
| `constraints/lcd_only.sdc` | 27 MHz 时钟约束 |
| `lcd_only.gprj` | 工程（顶层 `top_lcd`） |
| `tcl/build_lcd_only.tcl` | 构建脚本（含 `use_sspi_as_gpio`） |
| `scripts/build_lcd_only.ps1` | 一键构建 → `impl_lcd_only/` |
| `sim/tb_lcd_only.v` | 自检测试台 |
