Minghu00/fpga-voice-synth/交互方案_TTP229.md

# 交互方案 V2 —— TTP229 16 键触摸 + 16 声部合成引擎

> **V2 依据你提供的四份数据手册重写**，修正了 V1 的三处错误（位序、延迟、接口位置）。
> 配套：`赛题方案.md`（总体方案）、`项目清单.md`（现状体检）、`constraints/pinmap_v2.cst`（管脚表）。

---

## 0. 结论先行

| 项目 | 结论 |
|---|---|
| TTP229 占用 | **2 根 IO**：`tp_scl`(出) + `tp_sdo`(入) |
| 接哪个座子 | **J14（MIC Array Conn，2x6 2.54mm）**，不是 J4/J5/J6 |
| 位序 | **D0 先出（LSB-first）**，第一个 bit = TP0 |
| 有效电平 | **低电平有效**（TP0=1, TP1=1 默认组合） |
| 数据刷新周期 | **32 ms**（16 键模式），这是传感器侧延迟 |
| 目标 | 16 键钢琴布局 → 16 声部 × 4 分量 = **64 个独立振荡器** |

> ⚠️ **J4/J5/J6 不是 PMOD**。原理图 P006_LCD 页上它们是 `Conn_02x06_Odd_Even`
> LCD 信号转接排针（J4=R0/R2/R4/G1、J5=R1/R3/G0/G2、J6=B0/B2/B4/VSYNC），
> 引脚与 FPC J7 并联。你的屏走 J7，这三个座子上跑的全是屏幕信号，**不可复用**。

---

## 1. TTP229 协议（按数据手册 V1.1 第 9~10、15 页）

### 1.1 2 线串行时序

```
SDO ──┐                      ┌─ D0 ─ D1 ─ D2 ─ … ─ D14 ─ D15 ──┐
      └── DV脉冲(~93us) ──────┘                                └── 等下一轮
              │
              └─≥10us(Tw)─► 开始打 SCL

SCL  ___________________________┌┐ ┌┐ ┌┐        ┌┐ ┌┐__________
                               └┘ └┘ └┘  … 16 个 └┘ └┘
                                  ↑
                              SCL 低电平期间采样 SDO
```

| 参数 | 值 | 说明 |
|---|---|---|
| **DV** | 93 µs 典型 | SDO 上的同步脉冲，低电平有效时是一个 **低脉冲** |
| **Tw** | ≥10 µs | DV 结束后到第一个 SCL 上升沿的等待 |
| **Tout** | 2 ms 典型 | **SCL 超过 2ms 没变化，芯片自动回待机** → 读必须一气呵成 |
| **T_resp（16键）** | **32 ms** | 数据刷新周期（8 键模式是 16ms） |
| **F_SCL** | 1 kHz ~ **512 kHz** | 可以跑到 512k，不必用很慢的 100k |
| 上电稳定 | **0.5 秒** | 此期间所有触摸无效，必须忽略 |
| 自动校准 | 约 4.0 秒 | 长时间无触摸后重新校准 |

### 1.2 数据位序：**D0 先出**

数据手册图 3-4-1 ~ 3-4-4 全部标 `D0 D1 … D13 D14 D15`，
且注明「The D0~D15 correspond to data of the TP0~TP15」。

所以 **第一个读到的 bit 是 TP0(KEY-0)，最后一个是 TP15(KEY-15)**。移位寄存器写法：

```verilog
// LSB-first：先读到的放低位
key_shift <= {sdo_bit, key_shift[15:1]};   // 读满 16 次后，bit0 = TP0
```

> 这个结论和我 V1 里猜的 MSB-first 相反。仍然保留一个 `BIT_ORDER` 参数，
> 上板 5 分钟就能确认（点 TP0，如果亮的是第 16 个声部就翻转）。

### 1.3 有效电平：默认**低电平有效**

数据手册第 15 页选项表：

| TP0(OPDEN) | TP1(SAHL) | 2-线串行输出类型 |
|---|---|---|
| **1** | **1** | **CMOS 低电平有效** ← **默认** |
| 1 | 0 | CMOS 高电平有效 |
| 0 | 1 | CMOS 低电平有效 |
| 0 | 0 | CMOS 高电平有效 |

出厂的内部上拉默认是 `1`，所以**低电平有效**：

- SDO 空闲 = 高
- DV = 一个低脉冲
- 每个数据 bit：**触摸 = SDO 读低**，未触摸 = 高

RTL 里 `key_bit = ~sdo` 即可转成"1=按下"。

### 1.4 模块焊盘配置（**必须逐个核对**）

数据手册第 15 页明确：「状态 1 = 内部上拉（默认）；状态 0 = 该端口接高阻值电阻到 VSS」。
我们要 **16 键 + 多键 + 64Hz**，所以下面四个焊盘都**必须下拉 1MΩ 到 GND**：

| 焊盘 | 功能 | 默认 | 我们要 | 备注 |
|---|---|---|---|---|
| **TP2** (KYSEL) | 8 键 / 16 键 | 1 = 8键 | **0 = 16键** | ✅ 必须改 |
| **TP3** (SKMS1) | 单键/多键 | 1 = 全单键 | **0 = 多键** | ✅ 必须改 |
| **TP4** (SKMS0) | 单键/多键 | 1 = 全单键 | **0 = 多键** | ✅ 必须改 |
| **TP5** (WPSCT) | 睡眠唤醒采样率 | 1 = 8Hz | **0 = 64Hz** | ✅ 必须改 |
| TP0 (OPDEN) | 输出类型 | 1 | 1 | 保持 |
| TP1 (SAHL) | 高/低有效 | 1 | 1 | 保持（低有效） |
| TP6 (SLWPTM) | 唤醒采样长度 | 1 = 4.0ms | 1 | 保持 |
| TP7 (SKSRT) | 最长输出时间 | 1 = 无穷大 | 1 | 保持（否则 80 秒断音） |
| REGEN | 内部稳压 | 1 | 1 | 保持 |
| SLSERT | 串行类型 | 1 = 2线 | 1 | 保持（**0 会变 I2C**） |
| ENSLP | 睡眠 | 1 | 1 | 保持 |

> **实测方法**：万用表量 TP2/TP3/TP4/TP5 焊盘对 GND 电阻。≈1MΩ 就是已配好；
> 开路就是没有，需要自己焊 1MΩ 到 GND，**改完必须重新上电才生效**。
> 部分模块已在板上贴了电阻，先量再焊，别重复堆。

---

## 2. 接口位置：用 J14，不是 J4/J5/J6

### 2.1 Dock 上所有 `Conn_02x06` 排针的真实用途

| 座子 | 页面 | 实际功能 | 能不能给 TTP229 |
|---|---|---|---|
| J4 | P006_LCD | LCD 信号转接（R0/R2/R4/G1） | ❌ 与屏冲突 |
| J5 | P006_LCD | LCD 信号转接（R1/R3/G0/G2） | ❌ 与屏冲突 |
| J6 | P006_LCD | LCD 信号转接（B0/B2/B4/VSYNC） | ❌ 与屏冲突 |
| J12 | P008_Camera | DVP 图像传感器辅助信号 | 🟡 摄像头不用则空，但在相机页 |
| **J14** | **P009_Things** | **MIC Array Conn，带 +3V3 / GND** | ✅ **最佳选择** |

### 2.2 J14 引脚

J14 是 `Conn_02x06_Odd_Even` 2.54mm 排针，带 **+3V3** 和 **GND**，其余 8 根网络是：

| J14 网络 | FPGA Ball | Bank | 说明 |
|---|---|---|---|
| MIC_DAT0 | **P8** | 3 (3.3V) | → 用作 **tp_scl** |
| MIC_DAT1 | **T8** | 3 (3.3V) | → 用作 **tp_sdo** |
| MIC_DAT2 | R8 | 3 (3.3V) | 备用 |
| MIC_DAT3 | T7 | 3 (3.3V) | 备用 |
| MIC_WS | P6 | 3 (3.3V) | 备用 |
| MIC_BCK | T6 | 3 (3.3V) | 备用 |
| MIC_LED_CLK | P9 | 3 (3.3V) | 备用 |
| WS2812-DAT | T9 | 3 (3.3V) | 备用 |

**接线**：

```
TTP229 模块        J14
  VCC   ──────────  +3V3
  GND   ──────────  GND
  SCL   ──────────  MIC_DAT0  (FPGA P8)
  SDO   ──────────  MIC_DAT1  (FPGA T8)
```

> ⚠️ J15 是同一组信号的 0.5mm FPC 座，和 J14 并联。**别往 J15 插东西**，会短路。

### 2.3 电平安全（重申）

TTP229 模块 3.3V 供电，输出 3.3V。**必须接 Bank3（3.3V）**。
`T2/T3/T4/E8/E9/C7/T5` 是 Bank4 **1.5V**（原理图 `*_1V5` 后缀），
把 3.3V 接上去会灌进 1.5V Bank，**有打坏器件的风险**。
J14 的 MIC_* 全部是 Bank3，安全。

---

## 3. 时钟方案（108MHz 一统）

### 3.1 求解

I2S 的 BCLK = fs × 64（32bit × 2 声道）。要让 fs、BCLK、9MHz 像素时钟**同源整数分频**，
设 `sys = fs × 64 × M`（M 为整数），且 `sys / 9MHz` 也要整数：

| sys | M | fs | BCLK | sys/9MHz |
|---|---|---|---|---|
| 108 MHz | 36 | 46.875 kHz | 3.000 MHz | 12 ✅ |
| **108 MHz** | **35** | **48.2143 kHz** | **3.0857 MHz** | **12 ✅** |
| 108 MHz | 34 | 49.632 kHz | 3.176 MHz | 12 ✅ |

**选定 `sys_clk = 108 MHz`（27MHz × 4），M=35**：

| 派生 | 分频 | 实际值 |
|---|---|---|
| 音频帧使能 fs | ÷ **2240** | **48 214.29 Hz** |
| I2S BCLK | ÷ **35** | **3.0857 MHz** |
| LCD 像素时钟 | ÷ **12** | **9.000 MHz** |

### 3.2 PLL 参数：**用 IP Core Generator 生成，不要手改**

现有 `rtl/pll_audio.v` 是 `IDIV_SEL=1 / FBDIV_SEL=4 / ODIV_SEL=8`，实测输出 67.5MHz
——说明这个工具链里 `ODIV_SEL` 是**查表索引**，不是自由分频比，手算容易错。

**做法**：Gowin IP Core Generator 新建 `pll_sys`，输入 27MHz、输出目标 108MHz、
`DEVICE = GW2A-18C`，工具自动生成 defparam。
**生成后必查** `impl/pnr/*.timing_paths` 里 `sys_clk` 周期应为 **9.259 ns**。

> 退路分析：81MHz（27×3）→ `81/64` 不是整数，BCLK 无法整数分频 ❌；
> 90MHz → 27×10/3 需要分数分频 ❌。**108MHz（27×4）几乎是唯一解。**

---

## 4. `ttp229_rx` 模块设计

### 4.1 状态机

```
        ┌──────────────────────────────────────────────────────┐
        │                                                      │
   ┌────▼─────┐  SDO 下降沿    ┌───────────┐  SDO 回高   ┌──────┴─────┐
──►│ S_IDLE   │───────────────►│ S_DV_WAIT │────────────►│ S_CLK      │
   │ SDO=1    │                │ 等 93us   │             │ 16 拍读数   │
   │ 忽略前   │                │ 脉冲结束  │             │ 每拍 2+2us  │
   │ 0.5s     │                └───────────┘             └──────┬─────┘
   └────▲─────┘                                                │ 16 bit
        │                                                      ▼
        │       超时 2ms（SDO 一直不动）              ┌─────────────────┐
        └─────────────────────────────────────────────│ S_DONE          │
                                                      │ key_raw 更新    │
                                                      │ 等下一轮 DV     │
                                                      └─────────────────┘
```

### 4.2 108MHz 下的参数

| 参数 | 依据 | 周期数 | 取值 |
|---|---|---|---|
| SCL 低电平 | F_SCL 最高 512k → 半周期 0.98µs | 216 | **取 200 clk ≈1.85µs**（≈270kHz） |
| SCL 高电平 | 同上 | 216 | **取 200 clk** |
| 单 bit | —— | 432 | 400 clk |
| 16 bit | —— | ~6.9k | 6400 clk ≈ 59µs（远小于 2ms 超时） |
| Tw 等待 | ≥10µs | 1080 | 取 1200 clk ≈ 11µs |
| DV 超时 | 93µs 典型，容忍到 300µs | 32.4k | 取 **40000 clk** |
| 整帧超时 | Tout=2ms | 216k | 取 **250000 clk** |
| 上电屏蔽 | 手册 0.5s | 54M | 取 **0.6s** |

### 4.3 关键实现片段

```verilog
// 低电平有效 → 触摸=1
wire sdo_bit = ~tp_sdo;

// LSB-first：先到的是 TP0
if (bit_cnt == 5'd15) key_raw <= {sdo_bit, key_shift[15:1]};
else                  key_shift <= {sdo_bit, key_shift[15:1]};

// 上电 / 复位后 0.6s 内忽略一切（手册要求 0.5s 稳定期）
wire warmup_done = (warmup_cnt == 24'd65_000_000);
```

### 4.4 调试可观测性

`key_raw[15:0]` 直接映射到 6 个板载 LED + LCD 上的 16 个方框：
触摸哪个亮哪个。**这一步能同时验证位序、有效电平、多键模式三件事。**

---

## 5. 键位映射：钢琴布局

### 5.1 16 键 → 钢琴（4×4 模块布局）

16 键模块是 4×4 排列。钢琴布局按「上排黑键、下两排白键、底排功能」安排：

```
        列1      列2      列3      列4
      ┌────────┬────────┬────────┬────────┐
上排   │ C#4    │ D#4    │ F#4    │ G#4    │   TP0  TP1  TP2  TP3
      ├────────┼────────┼────────┼────────┤
第二排 │ C4     │ D4     │ E4     │ F4     │   TP4  TP5  TP6  TP7
      ├────────┼────────┼────────┼────────┤
第三排 │ G4     │ A4     │ B4     │ C5     │   TP8  TP9  TP10 TP11
      ├────────┼────────┼────────┼────────┤
底排   │ A#4    │ 八度-  │ 音色   │ 八度+  │   TP12 TP13 TP14 TP15
      └────────┴────────┴────────┴────────┘
```

- **白键 8 个**：C4 D4 E4 F4 G4 A4 B4 C5（完整一个八度）
- **黑键 5 个**：C#4 D#4 F#4 G#4 A#4（缺 D#5，属正常）
- **功能键 3 个**：八度−、音色切换、八度+

> 如果你的模块是 2×8 长条排列，把上两排当白键、下两排当黑键+功能即可，
> **映射表就是一维数组，改 16 个数字的事**。

### 5.2 相位增量表（fs = 48 214.29 Hz）

```verilog
// inc = f/fs * 2^32，C4..C5 十二平均律
case (note_idx)
  4'd0 : inc = 32'h01639E57;  // C4   261.626 Hz
  4'd1 : inc = 32'h0178C3C3;  // C#4  277.183 Hz
  4'd2 : inc = 32'h018F2B15;  // D4   293.665 Hz
  4'd3 : inc = 32'h01A6E772;  // D#4  311.127 Hz
  4'd4 : inc = 32'h01C00D20;  // E4   329.628 Hz
  4'd5 : inc = 32'h01DAB19B;  // F4   349.228 Hz
  4'd6 : inc = 32'h01F6EBA8;  // F#4  369.994 Hz
  4'd7 : inc = 32'h0214D364;  // G4   391.995 Hz
  4'd8 : inc = 32'h0234825C;  // G#4  415.305 Hz
  4'd9 : inc = 32'h025613A1;  // A4   440.000 Hz
  4'd10: inc = 32'h0279A3E2;  // A#4  466.164 Hz
  4'd11: inc = 32'h029F5181;  // B4   493.883 Hz
  4'd12: inc = 32'h02C73CAF;  // C5   523.251 Hz
  default: inc = 32'h01639E57;
endcase
```

- **八度切换**：`inc << 1`（升八度）/ `inc >> 1`（降八度）
- **4 分量倍频**：`inc×1 / ×2 / ×3 / ×4`（用 `inc`、`inc<<1`、`inc+(inc<<1)`、`inc<<2`，零乘法器）
- **溢出校验**：最大 `C5 inc = 0x02C73CAF`，×4 = `0x0B1CF2BC` < 2³² ✅ 安全

---

## 6. 声部结构

### 6.1 16 键 ↔ 16 声部固定绑定

不做动态分配。第 i 个触摸键永远驱动第 i 个声部：

- 无仲裁、无 steal，硬件最简单
- 复音数直接是 **16**，`16 × 4 = 64 个独立振荡器`
- 和弦识别 = `key_raw` 中 ≥3 个 bit 同时为 1

### 6.2 单声部 = 4 个独立振荡器

```
        ┌──────────┐   ┌──────────┐
 inc ──►│phase_acc0│──►│ sine_rom │──► w0 ──► ×a0 ─┐
 inc×2─►│phase_acc1│──►│ sine_rom │──► w1 ──► ×a1 ─┤
 inc×3─►│phase_acc2│──►│ sine_rom │──► w2 ──► ×a2 ─┼──► Σ ──► ×ADSR ──► ×vel ──► out
 inc×4─►│phase_acc3│──►│ sine_rom │──► w3 ──► ×a3 ─┘
        └──────────┘   └──────────┘
        4 个独立相位累加器     共享同一份 1024×16 ROM
```

**这是赛题「加法合成按运算分量计独立振荡器」的正面答法**：
4 个不同频率的相位累加器，不是同一个波表查 4 次。

| 音色 | a0 | a1 | a2 | a3 | 听感 |
|---|---|---|---|---|---|
| 管风琴 Organ | 1.00 | 0 | 0 | 0 | 纯净 |
| 方波 Square | 1.00 | 0.33 | 0.20 | 0.14 | 复古 |
| 锯齿 Saw | 1.00 | 0.50 | 0.33 | 0.25 | 明亮 |
| 三角 Tri | 1.00 | 0 | 0.11 | 0 | 圆润 |

> 4 个相位累加器**永远在跑**（不管 a1..a3 是否为 0），
> 这样测试模式下"64 个活跃振荡器"的口径稳定，可复现。

### 6.3 时分复用：16 声部能过的关键

现有 `i2s_tx` 的 `sample_en` 只有 1 个 clk 宽。扩到 16 声部后
要在 1 拍内更新 64 个相位累加器 + 16 个 ADSR → **时序必炸**。

改成**把一帧 2240 clk 摊开**：

```verilog
// frame_cnt: 0..2239
// voice_idx = frame_cnt[10:6]        → 0..15（每声部独占 64 clk）
// 声部内 4 个分量各占 16 clk 完成相位累加 + 查表 + 累加
// 剩余时间给 ADSR 和 mixer
```

从「1 拍算 64 个振荡器」变成「64 拍算 4 个」，
**资源不变，时序预算放大 16 倍**。

---

## 7. 延迟：必须做双通道（这是本节最重要的结论）

### 7.1 TTP229 的 32ms 是个问题

数据手册第 6/10 页：

- `T_resp（16键）= 32 ms` —— 数据刷新周期
- `TWU（64Hz 唤醒）= 15.6 ms`
- 16 键模式哪怕唤醒是 64Hz，完整扫描一轮仍要 32ms

也就是说：**手指放上 → 数据更新，最坏 32ms，平均 16ms。**

如果评委把「手指触摸」当控制信号起点，**32ms 直接超出 10ms 要求**。
V1 方案里我说 15.6ms 不算，那是错的——真实数字是 **32ms**。

### 7.2 解法：双通道并行，各证各的

| 通道 | 输入 | 端到端延迟 | 用途 |
|---|---|---|---|
| **演奏通道** | TTP229 16 键 | ≈32 ms | 演示 64 振荡器、和弦、音色 |
| **延迟测试通道** | 板载机械键（T3/T2/D7） | **<1.5 ms** | **基础② 与 拓展③ 的延迟指标实测** |

两条通道共用同一套合成器，只是 `gate` 的来源不同，**切换只要 1 个寄存器**。

### 7.3 延迟明细（FPGA 侧）

| 环节 | 延迟 |
|---|---|
| 按键 2 级同步 | 2 clk @108MHz = 18.5 ns |
| 消抖 | 2 ms（可降到 1 ms） |
| 键扫描 → 声部分配 | ≤1 帧 = 20.7 µs |
| 振荡器 + ADSR + mixer | 0（流水线满速） |
| I2S 一帧（32bit） | 0.66 ms |
| **FPGA 侧合计** | **≈2.7 ms**（消抖 2ms）/ **≈0.9 ms**（消抖降到 1ms） |

- 对 **基础② ≤10ms**：余量 3~11 倍 ✅
- 对 **拓展③ ≤5ms**：消抖取 2ms 时 2.7ms ✅；若把消抖压到 1ms 则 0.9~1.7ms，余量充足
- **确定性**：全同步、固定周期计数，逐帧恒定无抖动 ✅

### 7.4 现场话术

> 「合成引擎本身从控制信号进 FPGA 到音频输出是 **0.9~2.7ms**，屏幕上同时显示
> 按键上升沿计数和 I2S 帧计数，差值恒定，可以实时看到不抖动。
> 触摸板这条链路多出来的 32ms 是 TTP229 芯片内部扫描周期，在控制信号进入 FPGA 之前。」

---

## 8. 管脚汇总

见 `constraints/pinmap_v2.cst`。TTP229 只需两行：

```verilog
IO_LOC  "tp_scl" P8;   // J14 MIC_DAT0
IO_LOC  "tp_sdo" T8;   // J14 MIC_DAT1
```

**顺带修正 V1 管脚表的错误**：Dock 的 5 个硅胶按键里

| 键 | Ball | 真实用途 | 可用？ |
|---|---|---|---|
| Key_0 | T10 | `T10_IOR35B_FPGA_RST` = **FPGA 复位键** | ❌ |
| Key_1 | T3 | 普通键（Bank4 1.5V） | ✅ |
| Key_2 | T2 | 普通键（Bank4 1.5V） | ✅ |
| Key_3 | D7 | 普通键（Bank4 1.5V） | ✅ |
| Key_4 | B10 | `B10_IOR31B_RECFG` = **RECONFIG 配置键** | ❌ |

只有 3 个能当普通键用。另外 5 位拨码 SW3 = C7/E9/E8/T4/T5（全 1.5V Bank），
可用于音色/八度/测试模式切换。

---

## 9. 落地顺序

| 步 | 内容 | 验证 | 预估 |
|---|---|---|---|
| **S0** | 修基线：`top.v` 加 `rst_n`、修 `sine_1024.mem` 符号位、修 i2s 位序、删 B10 | 板子响干净正弦 | 0.5 天 |
| **S1** | 换 108MHz PLL + fs=48.214kHz + BCLK=3.086MHz | 示波器量 BCLK / WS | 0.5 天 |
| **S2** | 写 `ttp229_rx`，`key_raw[15:0]` → LED | **触摸哪个亮哪个**（同时验位序/电平/多键） | 1 天 |
| **S3** | 单声部：任一键 → 对应音高 | 摸不同键听音高 | 0.5 天 |
| **S4** | 16 声部 + mixer + 限幅 | 多键和弦不破音 | 1 天 |
| **S5** | 4 分量加法合成 + 4 音色 | 换音色听差异 | 1.5 天 |
| **S6** | ADSR 参数化 + 力度 + 双通道延迟演示 | 屏上显示延迟计数 | 1 天 |
| **S7** | 测试模式：16 音同时输出 | 频谱仪数 16 个谱峰 | 0.5 天 |
| **S8** | LCD 频谱/李萨如（拓展③） | 屏上出图 | 3 天 |

**S2 是分水岭**：通信通了，后面全是合成器内部工作。

---

## 10. 风险清单

| 风险 | 影响 | 对策 |
|---|---|---|
| TP2/TP3/TP4/TP5 没下拉 | 只有 8 键 / 单键 / 8Hz | **先量焊盘对地电阻**，缺了焊 1MΩ，改完重新上电 |
| 位序/电平猜错 | 按 A 响 B | `BIT_ORDER`/`ACTIVE_LOW` 参数，S2 步 5 分钟验完 |
| 误接 1.5V Bank | 可能损坏器件 | 只走 J14 的 MIC_*（Bank3 3.3V） |
| 往 J15 插东西 | 与 J14 并联短路 | J15 空着 |
| 上电 0.5s 内触摸 | 无效，可能误校准 | RTL 屏蔽 0.6s |
| SCL 停 >2ms | 芯片回待机，读失败 | 16 bit 一气读完（59µs），远小于 2ms |
| T_resp 32ms | 触摸延迟超标 | **双通道**：机械键走延迟测试 |
| 16 声部资源超预算 | 综合不过 | 先跑 8 声部（32 振荡器），再扩 16 |

---

## 11. 待确认

1. **模块焊盘**：量一下 TP2/TP3/TP4/TP5 对地电阻，是否已贴 1MΩ？
2. **模块物理排列**：4×4 还是 2×8？（决定钢琴布局怎么摆）
3. **八度范围**：默认 C4~C5 够不够？需要跨 2 个八度的话功能键要多占几个。

---
*本方案依据 `TTP229_SPEC_V1.1(Simplified%20Chinese).pdf`、`触摸IC_TTP229.pdf`（英文版）、
`TTP229.pdf`、`TTP229B.pdf` 四份数据手册，以及 Dock 3714 原理图逐脚核对。*
