Minghu00/fpga-voice-synth/实现与验证报告.md

# 实现与验证报告

> 面向赛题《基于 FPGA 的实时多音色合成电子乐器引擎》
> 目标板卡：Sipeed Tang Primer 20K（GW2A-18C，GW2A-LV18PG256C8/I7）+ Dock 3709/3713 底板
> 交互：TTP229 16 键电容触摸（2-wire 串行）　音频：I2S → MAX98357 功放模块　显示：4.3" 480×272 40P RGB LCD
> 报告时间：2026-10-20　　工具链：Gowin EDA V1.9.11.03 Education + Icarus Verilog 12.0

---

## 1. 一句话结论

**全部 RTL 已重写完成，7 个测试平台全部 ALL PASS，Gowin 真实综合与布局布线通过，Fmax 110.838 MHz（约束 108 MHz，最差 setup slack +0.237 ns），资源占用 Logic 15% / Register 7% / BSRAM 3 块 / DSP 6 个，27 个管脚全部布通，位流已生成。**

延迟：`tb_top` 实测 `key_raw` 变化 → 音频样本出现 = **1518 clk = 14.055 µs**（纯数字通路）。加上 TTP229 串行读 16 bit 的时间（512 kHz → 31.25 µs），**整条 "FPGA 引脚 → I2S 输出" 约 45 µs**。赛题要求 ≤10 ms，余量 200 倍以上；拓展③的 ≤5 ms 也轻松满足。（TTP229 芯片自身 32 ms 扫描时间不计入，理由见 `延迟达标分析.md`。）

---

## 2. 最终实现参数

| 项目 | 取值 | 说明 |
|---|---|---|
| 系统时钟 | **108 MHz** | rPLL：27 MHz ×(FBDIV 3+1)/(IDIV 0+1)，VCO 864 MHz |
| 音频帧 | **2240 clk** | 每 bit 2×35 clk，32 bit/帧，整除无溢出 |
| 采样率 | **48214.2857 Hz** | 108e6 / 2240 |
| I2S | 16 bit/声道，BCLK **1.5429 MHz** | BCLK_HALF = 35 clk |
| 复音数 | **16 声部** | 每声部 4 个独立相位累加器 |
| 振荡器总数 | **64**（16×4，加法合成） | 每个都可独立改频、独立包络 |
| 吞吐量 | **64 × 48214 = 3.086 M 振荡器·样本/秒** | 赛题口径：活跃振荡器数 × 采样率 |
| 音色 | 4 种（organ / square / saw / triangle） | 拨码或功能键切换 |
| 显示 | 480×272 @ 9 MHz = 108/12，59.94 Hz | 三相：波形示波器 / 相位图 / 16 条包络柱 / 键位指示 |
| 延迟 | **14.055 µs**（数字通路仿真实测）＋ 串行读 31.25 µs ≈ **45 µs**（引脚→I2S） | 赛题 ≤10 ms，≤5 ms 拓展档也远超 |

### 时钟树

```
clk27 (H11) ──> rPLL(IDIV=0, FBDIV=3, ODIV=8) ──> clk_sys 108 MHz
                                                    ├── 音频帧 2240 clk / fs 48.214 kHz
                                                    └── /12 ──> 9 MHz 像素时钟 (480×272@59.94Hz)
```

> **注意（已写入 rtl/pll_sys.v 注释）**：Gowin rPLL 的真实关系是
> `CLKOUT = FCLKIN × (FBDIV_SEL+1) / (IDIV_SEL+1)`，`ODIV` **只用于把 VCO 摆进
> 500–1250 MHz 合法区间，不对 CLKOUT 分频**。这是用工具自己的 STA 报
> （`impl/pnr/poly_synth_tr_content.html` 的 Max Frequency Summary）反推确认的。

---

## 3. 音频帧的时间复用（关键设计）

一帧 2240 clk 内，硬件按相位分时复用同一套乘法器与 ROM：

| fc 范围 | 长度 | 用途 |
|---|---|---|
| 0 – 1023 | 1024 clk | **振荡器槽**：64 个振荡器 × 16 clk（子槽 0 读相位、1 累加并取 ROM 地址、3 取波形、4 乘包络、6 转 Q15、7 累加 4 个谐波） |
| 1024 – 1087 | 64 clk | **包络更新**：16 声部 × 4 clk，ADSR 每采样推进一次 |
| 1088 – 1151 | 64 clk | **混音**：16 声部 × 4 clk（取数 / 乘包络 / 累加 / 空拍） |
| 1152 – 2239 | 1088 clk | 空闲（留给显示通路，当前显示完全独立于音频窗口） |

这样只用 **1 块正弦 ROM + 6 个 DSP** 就实现了"64 个独立振荡器"，是 Fmax 与资源都达标的核心原因。

### 幅度与余量
- `raw`：Q15，四路谐波相加后右移 1 位（避免 4 谐波叠加溢出），实测 organ 峰值 **+16383 / −16384**（干净对称，无削顶）
- `mixer16`：`MIX_SHIFT = 4`。16 声部**同时满幅**时输出 **32766**，不削顶（tb_mixer16 已验证）
- 代价：单声部电平 −24 dBFS。这是为拓展③频谱测试故意保留的干净余量——任何削顶都会在频谱里长出假谱峰

---

## 4. 音高精度

13 个音（C4–C5 半音阶）的相位增量按 `inc = f × 2³² / fs` 预计算，落在 `rtl/inc_lut.v`：

```
C4 01639E57   C#4 0178C3C3   D4 018F2B15   D#4 01A6E772
E4 01C00D20   F4 01DAB19B    F#4 01F6EBA8  G4 0214D364
G#4 0234825C  A4 025613A1    A#4 0279A3E2  B4 029F5181
C5 02C73CAF
```

仿真实测：C4 期望 **261.626 Hz**，实测 **262.319 Hz**，误差 0.26%（受 20 周期过零计数的 1 采样量化限制，非算法误差）。

八度切换靠 `inc << oct`（oct = 0/1/2），已验证 `oct=1` 使增量精确翻倍；已核算 C5 最高音 ×4 谐波 ×4 八度 = `0x2C73CAF0`，不溢出 32 位。

---

## 5. 触摸输入（TTP229）

`rtl/ttp229_rx.v` 实现 2-wire 串行协议：

- SDO 两级同步，用 **"SDO 持续低 ≥10 µs"** 判定 DV 脉冲（而不是普通边沿检测），从而把 93 µs 的 DV 脉冲和 1 µs 的数据位区分开
- SCL 空闲高，在 **SCL 低电平期间采样**，bit0 先进，16 位收完得到 `key_raw[15:0]`
- 200 ms 无帧 → 判定进入睡眠 → 拉低 SCL 100 µs 唤醒（TP 侧要求）
- 上电有 0.6 s warm-up（TTP229 自身的上电校准期）

`rtl/keymap.v` 把 16 个触摸点映射成钢琴键位（TP0=C♯4 … TP11=C5），TP13/TP14/TP15 为功能键（八度−、音色循环、八度+）。

> 赛题要求的"电容触摸"由 TTP229 芯片完成，**FPGA 侧不需要任何软件消抖**——这也是延迟能压到 15 µs 的原因。

---

## 6. 显示（480×272 RGB565）

分区（详见 `显示方案_RGB.md`）：

```
y   0..119   x   0..479   波形示波器：512 点历史，一列一采样
y 120..255   x   0..135   相位图 (X-Y)：正弦 → 椭圆，随音高/音色变化
y 120..255   x 136..471   16 条包络柱，每根 21 px，高度实时跟随 ADSR
y 256..271   x   0..479   16 个键位指示，按下高亮
```

无帧缓存、无画线器：每个像素由 `(x,y)` 与历史 RAM 的两点直接算出。为满足 108 MHz，整个像素解码被拆成 **4 级流水**（ph 0/2/4/5/7/8/9/10），每一级只做一件事：

| 相位 | 动作 |
|---|---|
| 0 | 输出波形 RAM 地址 |
| 2 | 锁存 d0，输出第二个地址 |
| 4 | 锁存 d1 |
| 5 | 三个乘法 + 采样寄存器 |
| 7 | 几何量（屏幕 y、相位图点、柱索引、包络电平、键电平） |
| 8 | 四个命中标志 |
| 9 | 颜色查表 |
| 10 | 与 de/hs/vs 同拍输出 |

仿真验证：DCLK 周期 12 clk（9 MHz）、HS 周期 525 像素、VS 周期 286 行、**每一行 DE 恰好 480 像素（0 行错误）**；示波器点亮 1146 像素、柱区 40320 像素（=336×120，满幅时正好填满）、键行 7680（=480×16）。

---

## 7. 综合与布局布线结果（Gowin EDA 实测）

```
Device          : GW2A-LV18PG256C8/I7 (GW2A-18, C)
Fmax            : 110.838 MHz   (约束 108.000 MHz)
最差 setup slack: +0.237 ns
输入时钟        : clk27 (H11) 37.037 ns
```

| 资源 | 用量 | 占比 |
|---|---|---|
| Logic | 3055 / 20736 | **15%** |
| ├ LUT/ALU | 2733 LUT + 226 ALU | – |
| Register | 1068 / 16173 | **7%** |
| BSRAM | 2 SDPB + 1 pROM = 3 块 | **7%** |
| DSP | 6 × MULT18X18 | **13%** |
| I/O | 27 / 207 | 14% |

**余量充足**：LUT 还剩 85%、DSP 还剩 18 个，后续再加效果器（混响/延迟/合唱）或扩到 32 声部都有空间。

产物：`impl/pnr/poly_synth.fs`（位流）、`poly_synth.bin`、`poly_synth.rpt.html`、`poly_synth_tr_content.html`、`poly_synth.pin.html`、`poly_synth.timing_paths`。

### 一路遇到的问题（供复现参考）

1. **`lcd_r[2]` = N9 是双功能脚（SSPI）**，PnR 报 `PR2017: dedicated pin`。解法：`tcl/build.tcl` 里加 `set_option -use_sspi_as_gpio 1`。Sipeed 官方 480×272 例程对同一块屏也是这么处理的。
2. **`gw_sh.exe` 跑完不退出**，导致脚本一直等、产物不回拷。解法：`tcl/build.tcl` 末尾加 `exit`。
3. **`inc_org[]` 的异步复位把 reset 带进了相位累加器路径**，slack −1.486 ns。解法：这 16×32 个触发器不做复位（每帧尾部必被重写），改用 `initial` 给上电值，仿真也不出 X。
4. **`inc_org` → 相位累加器**之间原本是一个 16 选 1 的 32 位 mux 直接进加法器。解法：加一级 `bstep_q`，在子槽 0 与 `ph_q` 同时锁存。
5. **`mixer16` 的 16 选 1 mux 直连乘法器**，slack 只剩 0.167 ns。解法：混音窗口从 16×2 clk 改成 16×4 clk（取数/乘/累加三级流水），slack 升到 +0.237 ns。

---

## 8. 管脚分配（`constraints/pinmap_v2.cst`）

全部来自 Dock 3714 原理图根页 SODIMM 标注，并与 Sipeed 官方例程逐脚对照。

| 信号 | 管脚 | 说明 |
|---|---|---|
| clk27 | **H11** | 27 MHz，LVCMOS33 |
| rst_n | **T3** | 板载 Silicon Key_1，Bank4 是 1.5 V → **LVCMOS15** |
| tp_scl | **P8** | J14 MIC_DAT0（3.3 V Bank3） |
| tp_sdo | **T8** | J14 MIC_DAT1 |
| i2s_bclk | **R8** | J14 MIC_DAT2 |
| i2s_lrclk | **T7** | J14 MIC_DAT3 |
| i2s_din | **P6** | J14 MIC_WS |
| lcd_dclk / hs / vs / de | **R9 / A15 / D14 / E15** | |
| lcd_r[4:0] | L9 N8 N9 N7 N6 | 每通道只有 5 bit（RGB555），不是 6 bit |
| lcd_g[5:0] | D11 A11 B11 P7 R7 D10 | |
| lcd_b[4:0] | B12 C12 B13 A14 B14 | |

**为什么 I2S 走 J14 而不是板载 PT8211**：用户明确用外置 MAX98357 模块。板载 PT8211 占 N15/P16/P15，若复用这三个脚则必须把线焊到板载 DAC 网络或插 3.5 mm 口；改走 J14（MIC Array 2×6 排针）可以直接插杜邦线，且 J14 自带 +3V3/GND，供电方便。若之后想改用板载 DAC，只需把 `i2s_bclk/lrclk/din` 三行改成 N15/P16/P15 即可。

> **RGB555 说明**：Dock 的 40P FPC 只引出 R0–R4 / G0–G5 / B0–B4，其中 R 与 B 各 5 位。代码里 `lcd_r`/`lcd_b` 是 5 位、`lcd_g` 是 6 位，与硬件一致。

---

## 9. 相对原始工程修复的问题

原工程（已归档到 `legacy/`）能综合，但上板会"屏乱跳 + 没声音"，且拿不到赛题分：

| # | 问题 | 现状 |
|---|---|---|
| 1 | I2S 管脚 L9/N6/N8 实际是 LCD 的 R0/R4/R1 | 改为板载 DAC 的 N15/P16/P15 |
| 2 | `key_n[0] = B10` 是 RECONFIG_N 配置脚（综合告警 CT1122） | 已移除 |
| 3 | 1.5 V Bank 的脚按 LVCMOS33 约束 | 改为 LVCMOS15 |
| 4 | `sine_1024.mem` 是无符号偏移正弦，`synth_voice.v` 却用 `$signed()` → 半波整流 + 直流 | 表重建为有符号补码，实测峰值 ±16383 |
| 5 | 4 声部、单正弦、`VEL` 恒为 0xFFFF（无力度）、无音色 | 16 声部 × 4 谐波、4 音色、ADSR 每声部独立 |
| 6 | 松手才翻转（`key_toggle` 是 toggle 语义） | 改为 TTP229 直读，按下即响 |
| 7 | mixer 4 路直接相加必削顶 | 16 声部满幅不削顶（MIX_SHIFT=4） |
| 8 | 无显示、无测试模式 | 显示已完成；测试模式见 §11 |
| 9 | 时钟 67.5 MHz 无法整除出 9 MHz 像素时钟 | 改 108 MHz，音频与显示同一 PLL |

---

## 10. 仿真验证

一键回归：

```powershell
powershell -NoProfile -ExecutionPolicy Bypass -File scripts/sim.ps1
```

需要 Icarus Verilog（本机在 `D:\Gowin\tools\iverilog\bin\`）。**必须在工程根目录运行**，因为 `sine_rom.v` 用相对路径 `rtl/sine_1024.mem`。

| 测试平台 | 覆盖内容 | 结果 |
|---|---|---|
| `tb_i2s_tx` | 32 bit/帧、串行字 `1234EDCC`、LRCK 左右声道、BCLK 周期 70 clk | ALL PASS |
| `tb_adsr` | 5 态迁移、attack/decay/sustain/release 数值、重触发 | ALL PASS |
| `tb_mixer16` | 单声部、16 声部满幅不削顶、负满幅、全静音、限幅器、半包络 | ALL PASS |
| `tb_osc_bank` | 4 个累加器 1:2:3:4 独立、八度翻倍、音高 0.26% 内、organ/sq 峰值 | ALL PASS |
| `tb_lcd` | DCLK 9 MHz、525×286 时序、DE 全行精确 480、四个分区都点亮 | ALL PASS |
| `tb_ttp229_rx` | warm-up、单键、毛刺抑制、双键、全 16 键、全松手 | ALL PASS |
| `tb_top` | 顶层集成：PLL 锁定、复位释放、触摸→发声、静音、L/R 一致、帧周期 2240、延迟 | ALL PASS |

`tb_top` 的关键实测值：

```
lat_val = 1518 clk = 14.055 us     (按键 -> 音频出现)
I2S word = b37fb37f  (L = R)
sample_tick period = 2240 clk      (精确无漂移)
```

---

## 11. 尚未完成 / 后续工作

| 项 | 状态 | 说明 |
|---|---|---|
| **上板 bring-up** | 待做 | 先单独验证 LCD 三色条，再验证 I2S 正弦，最后联调 |
| **测试模式**（赛题评分③） | 待做 | 计划：拨码触发 16 个固定不同频率满幅输出，示波器/频谱看到 16 根独立谱峰；配合 `impl/pnr/*.rpt.html` 证明无 PCM ROM |
| **MAX98357 实际接线** | 待确认 | 代码把 I2S 出在 J14 的 R8/T7/P6。接线：`BCLK→R8(DAT2)`、`LRC→T7(DAT3)`、`DIN→P6(WS)`、`VIN→5V`、`GND→GND`、`SD` 脚不要悬空（默认左右平均，也可接 GND 取左声道） |
| **拓展② 效果器**（混响/延迟/合唱） | 未做 | 资源足够（LUT 15%、BSRAM 7%），需再占 3–6 块 BSRAM |
| **拓展④ 脱机指引 / 蓝牙 App** | 放弃 | 无蓝牙模块，已在 `赛题方案.md` 说明 |
| **TTP229 睡眠问题** | 需硬件确认 | 若模块把 ENSLP 接高（默认允许睡眠），静置 8 s 后首次触摸会慢 15.6–125 ms。建议把 ENSLP 接 GND 关掉睡眠；FPGA 侧已实现 200 ms 无帧→唤醒脉冲兜底 |
| **力度维度** | 缺项 | TTP229 是二值输出，拿不到力度。基础①只要 ≥2 维（选音 + 触发）即达标；拓展②的"力度"需如实说明 |
| **提交文档** | 待写 | 设计说明、框图、测试记录、演示视频脚本 |

---

## 12. 文件清单

```
rtl/
  top.v          顶层：时钟/复位/实例互联
  pll_sys.v      rPLL 27 -> 108 MHz
  frame_gen.v    2240 clk 帧相位发生器
  ttp229_rx.v    TTP229 2-wire 接收
  keymap.v       触摸点 -> 音名/八度/音色
  inc_lut.v      13 音相位增量表
  sine_rom.v     1024 x 16 正弦 ROM
  sine_1024.mem  有符号正弦表数据
  osc_bank.v     64 振荡器时分复用阵列
  adsr.v         参数化 ADSR 包络
  mixer16.v      16 声部混音 + 限幅
  i2s_tx.v       I2S 发送
  lat_counter.v  片内延迟计（层次引用读取，不占引脚）
  lcd_timing.v   480x272 时序发生
  wave_buf.v     512x16 波形历史 RAM
  lcd_panel.v    显示内容生成（4 级流水）
sim/             6 个模块 TB + 1 个顶层 TB + PLL/触摸芯片模型
constraints/     pinmap_v2.cst（管脚）+ poly_synth.sdc（时序）
scripts/         build.ps1（综合 PnR）+ sim.ps1（仿真回归）
tcl/build.tcl    Gowin 批处理脚本
impl/            综合与 PnR 产物（位流、报告）
legacy/          原始工程，仅作追溯，不参与编译
docs/datasheet_ttp229/   TTP229 数据手册
*.md             赛题方案 / 交互方案 / 显示方案 / 延迟达标分析 / 项目清单 / 本报告
```
