Minghu00/fpga-voice-synth/乐器位流说明.md

# 8 键电子琴位流 —— 触摸 + 波形/包络实时显示

产物：`impl_inst/pnr/inst.fs`（7,264,154 B）／`impl_inst/pnr/inst.bin`（907,418 B）

这份位流就是"TTP 触摸 + LCD 实时显示"的完整乐器版本：手指按到哪一格，
屏幕上那一格立刻亮；同时正弦波形示波器、ADSR 包络曲线和 8 根包络柱都在实时刷新；
音频同时从 I2S 输出。**多键同时按下可以同时发声**（已仿真验证）。

---

## 1. 接线

### 1.1 触摸板：接 Dock 的 J14 排针

J14 是板子右上、拨码开关下方那个 **2×6 双排 2.54 mm 排针**，板上丝印 `MIC Array Conn`。

| TTP229 模块 | J14 脚号 | 板上网络名 | FPGA 球号 |
|---|---|---|---|
| VCC | 1 或 2 | +3V3 | — |
| GND | 3 或 4 | GND | — |
| **SCL** | **8** | `MIC_DAT0` | **P8** |
| **SDO** | **7** | `MIC_DAT1` | **T8** |

> 注意：**不能接 5、6 脚**。J14 的 5 脚是 `MIC_LED_CLK`(P9)、6 脚是 `MIC_LED_DAT`(WS2812 灯链)，
> 跟触摸没有关系——之前接 5/6 脚导致"完全没反应"就是这里搞错了。

### 1.2 拨码开关 SW3（音区 / 音色 / 音量）

SW3 是板上那个 5 位拨码：**1 号位必须拨下**（核心板供电使能，否则整板不上电）。剩下 4 位当控制用：

| SW3 位 | FPGA 球号 | 作用 |
|---|---|---|
| 位 1 | E9 | 八度 低位 |
| 位 2 | E8 | 八度 高位 |
| 位 3 | T4 | 音色 低位 |
| 位 4 | T5 | 音色 高位 |
| 位 5 | C7 | 音量 +1 档（`sw5_vol`）|

> 拨码在上电时读入并同步，改完拨码后按一下复位键（T3）或重新上电生效。

**八度**（位 1、2 组合，0 = 都不拨）：

| 位 2 位 1 | 八度 | 音域（按现在的琶音布局） |
|---|---|---|
| 0 0 | 0 | C4 ~ E6（默认） |
| 1 0 | 1 | C5 ~ E7 |
| 0 1 | 2 | C6 ~ E8 |
| 1 1 | 2（上限保护） | 同八度 2 |

> 不允许再高：正弦表相位增量到八度 3 会溢出 32 位累加器，所以硬件里做了钳位。

**音色**（位 3、4 组合）：

| 位 4 位 3 | 音色 | 频谱特征 |
|---|---|---|
| 0 0 | 管风琴 | 纯基波，只有 1 个分量 |
| 1 0 | 方波 | 奇次谐波 1:3:5 |
| 0 1 | 锯齿 | 全谐波 1:2:3:4 |
| 1 1 | 三角 | 奇次谐波 1:3 |

**音量**：位 5 拨下加一档。默认（不拨）是 -12 dB 的安全音量。

### 1.3 板载按键

| 按键 | 丝印 | FPGA 球号 | 作用 |
|---|---|---|---|
| Key_1 | SW1 | **T3** | 复位（`rst_n`）|
| Key_2 | SW2 | **T2** | **短按** = 锁存模式开关；**长按 ≥0.8 s** = 切换表情/效果档（`fx_mode`）|
| Key_3 | SW3 | **D7** | **短按** = 音量 +1 档；**长按 ≥0.79 s** = 切换 4 波表模式 |

> Key_4 (B10) 是 `RECONFIG_N` 配置脚，Key_5 (T10) 是专用 SSPI 脚，SW4 落在 C6（JTAG），
> 这三个都不能当普通 IO 用，所以只用到了上面三个键。
>
> **为什么没有静音键**：Dock 上每一根 `Silicone Key_n` 都有 10 k 上拉到 +1V5，
> 按键按下才短接到 GND。所以"电平=1 就静音"的写法上电即永久静音——这正是
> 之前完全没声音的原因。改用 **按下沿触发** 的音量键，闲置电平不再有任何影响。

**音量**：按 Key_3 循环 6 dB 步进，范围 **0 dB .. +24 dB**，上电默认 **+12 dB**；
到 +24 dB 后再按一次回到 0 dB。音量梯显示在屏幕状态条中段（黄色，8..12 格），
9 个档位 2 格一档。SW3 位 5 仍可临时 +1 档。

> **三处修复的来龙去脉**（都是后来补的）：
> ① **音量能降到 0 dB**：原来音量表只有 4.0× 到 16×，只能往上加，叠音越界时操作者无计可施。
> ② **`audio_out` 加软拐点限幅器**（3/4 满刻度起、斜率 1/8），不小心越界也不再变成方波。
> ③ 但「颤抖」的**真正根因**不在这两处，而在 `fx_echo` 把有符号数据用拼接做符号扩展，
> 导致**每个波形的负半周被钉在 +32767**。已改为 `wire signed [17:0] wet_sum = din_q + ...`。
> 完整诊断、探针数据与三轮误判复盘见 `docs/音量与削波记录.md` 第 12 节。

**锁存模式**：**短按** Key_2 进入（屏幕右上角出现**洋红色小块**）。之后每点一下触摸键就
"锁住/放开"那个音，手指可以离开，多个音会叠加成一串和弦；再短按一次 Key_2 退出并清空。

> 锁存判定在**松开沿**做，所以短按只翻锁存、长按只翻效果档，互不干扰。

> **一次"点按"的判据（`TAP_HOLD`，默认 965 样本 ≈ 20 ms）**：必须**连续被芯片报满
> 20 ms** 才算一次点按，而且那个键在**所有手指抬起之前只允许触发一次**。
> 这条规则是为了对抗芯片的**出厂单键模式**——两根手指同时按下时，芯片每次 32 ms
> 扫描只报一个键、还会在两个键之间来回切换；旧写法 `latch <= latch ^ key_rise`
> 会在每次切换时把音翻掉，听起来就是"两个音反复振动、颤抖"。
> 现在两指同时按会**稳定锁住两个音**，回归见 `sim/tb_latch.v`（12 项全过）与
> `docs/音量与削波记录.md` 第 13 节。
>
> 附带说明：既然是单键模式，**手指按住不放时芯片只会报一个键**，所以"按住两个键
> 直接听和弦"是做不到的——要么用锁存模式一个一个挂上去，要么给 TP3/TP4 焊盘改焊。

**表情 / 效果档（赛题拓展②）**：**长按** Key_2 0.8 秒循环 8 档，
屏幕状态条 x 240..263 出现**橙色小块**表示非零档：

`fx_mode` 是**预设序号**（不是位掩码）——位掩码要一个效果一位、8 档变 32 档，现场根本转不过来。

| `fx_mode` | 颤音 | 滑音 | 延迟 | 混响 | 合唱 | 听感 |
|---|---|---|---|---|---|---|
| 0 | – | – | – | – | – | 全关（默认），与本功能加入前逐位相同 |
| 1 | ✅ | – | – | – | – | 5 Hz、±30 cent 的歌唱性颤音 |
| 2 | – | ✅ | – | – | – | 声部 0 变主奏声部，跟随最近按下的键滑过去 |
| 3 | – | – | ✅ | – | – | 124 ms 拍击回声，反馈 0.375，湿声 0.25 |
| 4 | – | – | – | ✅ | – | 4 路梳状混响：37/53/71/97 ms，权重 0.25/0.125/0.125/0.0625 |
| 5 | – | – | – | – | ✅ | 21 ms 单路 + 0.6 Hz 三角波扫频（±64 样本），湿声 0.5 |
| 6 | – | – | ✅ | ✅ | – | 回声 + 混响，厅堂感 |
| 7 | ✅ | ✅ | ✅ | ✅ | ✅ | 全开 |

三个效果（延迟 / 混响 / 合唱）共用**同一条** 8192×16 BSRAM 延迟线，
区别只是从环上哪个位置取、取几路、加多少反馈。读完 6 路抽头只用 8 个
时钟，而每样本有 2240 个时钟可用。

细节与证据见 `docs/滑音颤音延迟证据.md`。

### 1.4 音频：MAX98357

| MAX98357 | FPGA 球号 | J14 脚号 | 板上网络名 |
|---|---|---|---|
| BCLK | **R8** | 9 | `MIC_DAT2` |
| LRC（WS） | **T7** | 10 | `MIC_DAT3` |
| DIN | **T6** | 11 | `MIC_BCK` |
| VIN | — | 1 或 2 | +3V3（或外部 5V）|
| GND | — | 3 或 4 | GND |
| SD | — | 3 或 4 | 接 GND（悬空 = 芯片关断）|

> 音频走 J14 而**不是**板载 PT8211 音频座。板载 DAC 的脚（N15/P15/P16/R16）
> 需要飞线才接得到，而 J14 是现成的 2.54 mm 排针。
> I2S 格式：16 bit／声道、左对齐、BCLK = 1.5429 MHz、fs = 48214.29 Hz。
> MAX98357 的 SD 脚接地＝左声道单声道输出，悬空/接高＝(L+R)/2，两种都能响。

> ⚠️ **踩过的坑（曾导致整机完全无声）**：原理图上 `MIC_BCK` 接的是
> **DFP_IOR53_N = T6（第 11 脚）**，而 `MIC_WS` 接的是
> **DFP_IOR53_P = P6（第 12 脚）**。这两个名字极易互换。旧版约束把
> `i2s_din` 放在 P6，接线表却让用户插第 11 脚，于是 FPGA 驱动第 12 脚、
> 第 11 脚悬空 —— **BCLK 和 LRC 波形完美，DIN 一个数据都没有，功放一声不响**。
> 现已改为 `i2s_din = T6`（第 11 脚），与本文接线表一致。

### 1.4b 音频自检：第 12 脚 = 测试音开关

第 12 脚（`P6` / `MIC_WS`）现为 **`test_sw`**，内部下拉：

- **悬空** → 测试音关（正常运行）
- **接 +3V3**（跳到 J14 第 1 或 2 脚）→ FPGA 输出 **94 Hz 方波、−12 dBFS**

这个方波走的是同一组 I2S 引脚，但**完全绕过触摸和合成器**，用来一刀切开
"软件问题"和"硬件问题"：

| 短路第 12 脚到 3V3 后 | 说明 |
|---|---|
| 听到响亮蜂鸣 | FPGA 的 I2S 输出正常，之前的无声是软件（现已修复）或接线顺序问题 |
| 依然毫无声音 | 故障在 FPGA 之后：DIN 没接对、SD 没接地（芯片处于关断）、VIN 没供电、喇叭接错 |

### 1.5 屏幕

插 J7（40 pin 0.5 mm FPC）。RGB 只有 **R5/G6/B5**（低位在板上接地），时序 480×272 @ 9 MHz、59.94 Hz、HS/VS 低有效、DE 高有效。

### 1.6 现场测试模式（上电时按住 Key_3）

| 操作 | 结果 |
|---|---|
| 上电 / 复位时**不按** Key_3 | 正常工作模式 |
| 上电时**按住 Key_3**（D7）不放，按复位，松手 | 进入**测试模式**，锁存到下次断电 |

测试模式下 **8 个声部同时发声**，八路频率跨两个八度、每隔 3 个半音：

| 声部 | 0 | 1 | 2 | 3 | 4 | 5 | 6 | 7 |
|---|---|---|---|---|---|---|---|---|
| 音名 | C4 | D#4 | F#4 | A4 | C5 | D#5 | F#5 | A5 |
| 频率 | 261.6 | 311.1 | 370.0 | 440.0 | 523.3 | 622.3 | 740.0 | 880.0 Hz |

每个声部只开 1 个加法分量（管风琴档 = 纯正弦），所以频谱上能看到 **8 根互不重叠的独立谱峰**。
屏幕状态条 `x 168..191` 出现**红色块** = TEST 生效。

> 为什么只演示 8 根峰而不是 32 根：8 个声部的 4 次谐波按定义是基频的整数倍，
> 在频谱上必然互相压住，数出来会少于 32、反而像虚报。32 个振荡器的证据在 RTL：
> `osc_bank.v` 里 `reg [31:0] phase [0:31]`（`OSCTOT = 8 × 4 = 32`），
> 每个分量有独立的槽位与倍率 `bstep_q / <<1 / 3bstep_q / <<2`。
> 详见 `docs/测试模式证据.md`。

### 1.7 波表模式（长按 Key_3）

**长按板载 Key_3（D7）约 0.79 秒**切换，粘性保持，断电恢复默认。

| 操作 | 结果 |
|---|---|
| 短按 Key_3（< 0.79 s） | 音量 +1 档（和以前完全一样） |
| **长按 Key_3** | **波表模式开 / 关** |
| 断电重启 | 回到波表模式关闭（四个原音色声音逐位不变） |

打开后，4 个加法分量**不再共享同一张正弦表**，而是各读一张独立波表：

| 分量 | 波表 | 频率 |
|---|---|---|
| comp0 | 正弦 | 1 × f |
| comp1 | 三角 | 2 × f |
| comp2 | 锯齿 | 3 × f |
| comp3 | 方波 | 4 × f |

4 个独立相位累加器 + 4 张独立波表 + 4 个独立幅度 = **4 个真正独立的波表振荡器**，
整机 **32 个独立波表振荡器**。四张表共 4096 个采样点，`sim/tb_wavetable.v` 逐点核对过。

屏幕状态条 `x 192..215` 出现**橙色块** = WAVE 生效。

> 为什么要四张表：赛题评分①写明"**单波表查表只计 1 个振荡器**"。原来四个分量读同一张
> 正弦表、只是取 f/2f/3f/4f 的谐波，严格说只有 1 张波表。现在分量 c 读表 c，
> 这个口径漏洞就堵上了。详见 `docs/多波表证据.md`。

三种模式可以叠加：**测试模式 > 锁存模式 > 触摸按键** 决定 `gate`，波表模式只改"读哪张表"，
所以互不冲突。

---

### 1.8 显示页切换（超长按 Key_2）

板载 **Key_2（T2）** 现在有三档按键时长，互不干扰：

| 按住时长 | 结果 |
|---|---|
| 短按（< 0.8 s） | 锁存模式开 / 关（和以前完全一样） |
| 长按 **0.8 秒** | 表情档 FX 0→1→…→7→0（颤音 / 滑音 / 延迟 / 混响 / 合唱） |
| **超长按 1.6 秒** | **切换显示页**：波形页 → 频谱页 → 李萨如页 → 波形页（三页循环）|

屏幕状态条 `x 320..367` 有 4 个小格，**点亮格数 = 当前页 + 1**，所以波形页 1 格、频谱页 2 格、李萨如页 3 格，
一眼能看出现在在哪一页。

> 超长按会**同时**触发一次 FX 步进 —— 这是刻意保留的（分两级阈值触发），
> `tb_inst` 里有一条断言专门把这个行为写下来，免得以后被当成 bug 再改一遍。

#### 频谱页（`rtl/display/spectrum16.v`）

原来画波形的那块区域（y 28..163）变成 **16 根频谱柱**，每根 30 px：

- 16 bin 直接 DFT，**不是 FFT**：无帧缓存的行扫描只要 16 个数，全 FFT 的 LUT 花不来
- 512 点一窗，94.17 Hz/bin，覆盖 **94 Hz … 1.51 kHz**（正好罩住琴的 C4…C5 + 两个八度）
- 每个 bin 一个 9 位相位累加器，sin/cos 都从同一张 512 项正弦表取（cos = sin(p + N/4)）
- 每样本 32 个时钟（16 bin × 2 遍发布），一帧 2240 个时钟，占 **1.4%**
- **三角窗**：矩形窗下一个音会把整排柱子都点着（旁瓣按 1/Δf 衰减，C4 落在第 2.78 个 bin，
  第 16 个 bin 还有 −22 dB）→ 三角窗把远端旁瓣压掉约 13 dB
- **自动电平（AGC）**：以本块的**峰值 bin 为基准**，每档 3 dB。没有它的话音量一调小
  整屏就全黑，音量一大就全亮 —— 峰值当参考后，"离峰值超过 45 dB 就是 0"
- 柱顶两行亮黄、柱身深蓝绿，柱子从底往上涨

`sim/tb_spec_cont.v` 专门测**连续相位**的音（真乐器就是这样，相位跨块自由跑，
矩形窗会在块的边界上振铃），C4 的结果：**bin 3 = 15（峰）、bin 2/4 = 13/11（主瓣）、
bins 7/9/11..16 = 0（全黑）**。

> 为什么必须测连续相位：`tb_spectrum16` 用的音是块严格周期的，矩形窗看不出问题；
> 上板后整个 banda 全亮，根因就是相位不连续 + 没有窗函数。详见 `docs/显示页证据.md`。

---

## 2. 屏幕上看到什么

屏幕有**三页**：波形页 → 频谱页 → 李萨如页，长按 Key_2 超过 1.6 秒切到下一页（见 1.8 节）。

### 页 0：波形页（默认）

```
y   0.. 27  ████████  8 个白键格（每格 60 px），按下变琥珀色
y  28..163  ────────  波形快照，横轴 = 一次捕获的 480 个采样 = 9.96 ms
                       中线是 0，一个音占满约 94% 高度；多音叠加会顶到上下边（饱和）
y 164..231  ▁▂▃▅▇▂▁▁   ADSR 包络曲线（青色）+ 线下填充，窗口 318 ms
y 232..239  ■■■■      音色指示条：第 1..4 格亮哪一个就是哪个音色
y 240..271  ████████  8 根包络能量柱（每格 60 px），柱越高＝该声部越响
```

### 页 1：实时频谱页

```
y   0.. 27  ████████  8 个白键格（与波形页相同）
y  28..163  ▇▇▁▁▁▲▲▁▁  16 根频谱柱（每根 30 px）
                       横轴 = 频点 k = 1..16，即 94 Hz 到 1.507 kHz（每 bin 94.17 Hz）
                       柱高 = 以本块峰值 bin 为 0 dB、每档 3 dB 的相对电平
y 164..271  （空，深蓝背景）
```

- 左边是低音、右边是高音；按低频键点亮左边的柱，按高频键点亮右边的柱
- 三角窗 + 自动电平（AGC），单个音只点亮主瓣附近的几根柱，不会糊满一整排
- 共 16 个固定频点，不是 1/3 倍频程；1.507 kHz 以上看不到（取舍见 `docs/显示页证据.md`）

### 页 2：李萨如（X-Y）页

```
y   0.. 27  ████████  8 个白键格（与波形页相同）
y  28..163  ╱╲╱╲        左右声道 X-Y 图形（暖紫色），中心十字线在 x=240 / y=96
y 164..271  （空，深蓝背景）
```

- **横轴 = 左声道电平，纵轴 = 右声道电平**，每帧用 512 个立体声采样重建
- 弹**单音**：左右同源，图形是一条斜线或很窄的椭圆（真实 X-Y 示波器也是这样）
- 弹**和弦**、或打开颤音/延迟：左右内容不同，图形张开成二维闭合曲线
- 图形全部在**行消隐**期间算好（3584 clk，预算 88200 clk），零额外管脚
- 细节与取证见 `docs/李萨如证据.md`

- 按键格：**多键同时按，多格同时亮**
- 波形：单音时是一条干净的正弦；两音以上会看到峰顶被削平（显示饱和，不是音频失真）
- 包络柱：松手后能看到柱慢慢落下来 = release 阶段
- 波形页是**单次捕获快照**，不是滚动示波器：按下/松开格子后等 300 ms
  （`SETTLE` 参数）让起音走完，然后连续抓 480 个采样存进 1024×16 的缓冲，
  **一直显示这一屏**。所以按住和弦期间画面绝对静止。
  代价是它显示的不是"此刻"的波形，而是最近一次换把位时抓的那一屏。
  为什么滚动方案做不到，见 `docs/音量与削波记录.md` 第 16 节。

---

## 3. 音阶映射（8 个键位 = C 大三和弦琶音）

| 触摸格 | 0 | 1 | 2 | 3 | 4 | 5 | 6 | 7 |
|---|---|---|---|---|---|---|---|---|
| J14 上的键 | TP0 | TP1 | TP2 | TP3 | TP4 | TP5 | TP6 | TP7 |
| 音 | C4 | E4 | G4 | C5 | E5 | G5 | C6 | E6 |

> 你手上的 TTP229 模块工作在 **8 键模式**（实测只有 8 个通道会响应，9 号以后的键位
> 芯片根本不报），所以整机就按 8 键设计：8 个声部 × 4 个谐波分量 = 32 个独立振荡器。
> 想恢复 16 键需要改模块上的 `KYSEL` 配置电阻，并同步改 RTL（见第 6 节）。

### 3.1 为什么不是「C 大调音阶」

原来的布局是白键 `C4 D4 E4 F4 G4 A4 B4 C5`，也就是相邻两格差一个全音（或半音）。
问题出在**最先被同时按下的 TP0 与 TP1**：C4 与 D4 相差一个全音，两根等幅正弦相加，
包络以 `|f1−f2| = 32 Hz` 的速率周期性地降到零 —— 每秒约 30 次完全消失，听感就是
「颤抖」。**这不是 FPGA 的缺陷**：把两个音锁存住，直接对 DAC 数据流做频谱分析，只有
263.95 Hz 与 293.27 Hz 两根干净谱线（其余 bin 全在 −34 dB 以下），包络起伏 29.7 Hz，
信号里没有别的东西；任何正确的合成器弹这两个音都是这个结果。

所以修法是**音乐上的**，不是数字上的：让相邻两格都是协和音程。现在是 C 大三和弦的
琶音 `C4 E4 G4 C5 E5 G5 C6 E6`，相邻音程是**大三度 / 小三度 / 纯四度**，拍频升到
62…131 Hz，已经离开耳朵判为「抖动」的 ~30 Hz 区域。叠几格按下去仍然是一个干净的
C 大三和弦，复音演示反而更好听。

| 相邻格 | 音程 | 拍频 |
|---|---|---|
| TP0+TP1 | 大三度 C4→E4 | 68 Hz |
| TP1+TP2 | 小三度 E4→G4 | 62 Hz |
| TP2+TP3 | 纯四度 G4→C5 | 131 Hz |
| TP3+TP4 | 大三度 C5→E5 | 65 Hz |
| TP4+TP5 | 小三度 E5→G5 | 62 Hz |
| TP5+TP6 | 纯四度 G5→C6 | 130 Hz |
| TP6+TP7 | 大三度 C6→E6 | 65 Hz |

想换回音阶演奏，只改 `rtl/input/keymap8.v` 里 `NOTE_TAB` 的一行：

```verilog
localparam [5*8-1:0] NOTE_TAB =
    { 5'd12, 5'd11, 5'd9, 5'd7, 5'd5, 5'd4, 5'd2, 5'd0 };   // C4..C5 音阶
```

代价是 TP0+TP1 又会听到 32 Hz 拍频 —— 那时想听干净和弦请按五度/八度（TP0+TP4、
TP0+TP7）。

> 为了容纳 E6（1318.5 Hz），`rtl/audio/inc_lut.v` 从 25 项扩到 29 项（C4…E6），
> 索引 0…24 的值一字未改，`test_mode.v` 用的两八度布局不受影响。

---

## 4. 构建与验证结果

### 综合 / 布局布线（Gowin EDA V1.9.11.03 Education）

| 项目 | 结果 |
|---|---|
| ERROR / 告警 | **0 条** |
| 逻辑 | 4440 / 20736（22%）|
| 寄存器 | 2200 / 16173（14%），其中 FF 2172 + I/O FF 28 |
| CLS | 2864 / 10368（28%）|
| BSRAM | 13 / 46（29%）：5 SDPB + 6 pROM + 2 SP（含延迟线、两路波形缓冲、李萨如 span 表、频谱正弦表）|
| DSP | 6 / 24（25%）：10 个 MULT18X18 + 1 个 MULTALU36X18 |
| I/O | **35 / 207（17%），全部按约束落位，与上一版逐个相同** |
| rPLL | 1 / 4 |
| 时钟约束 | 108.000 MHz |
| **实际 Fmax** | **109.485 MHz**（Clock 逻辑级数 8）|
| 最差 setup slack | **+0.126 ns**（要求 9.259 ns）|
| Setup / Hold TNS | 0.000 / 0.000，**0 个违例端点** |

> **这一版把整套触发机构删掉了**（`cz` / `cz_age` / 包络峰检测 / `tsel` 全部
> 消失，只留一个 11 位 `settle` 计数器和 10 位 `cap_cnt`），换来的是一个 10 位
> 递增的写地址和一个恒为 0 的窗口起点。逻辑比上一版少 41 个 LUT，Fmax
> **111.888 → 109.485 MHz**、setup slack **+0.322 → +0.126 ns**、逻辑级数 4 → 8。
> 变慢的原因是 `cap_cnt` 现在直接驱动 1024 深 RAM 的写地址（原来是常量基址 +
> 小偏移），P&R 把最差路径放到了 `u_lcd/mult_75_s1` 这条柱高乘法上。
> 但**余量仍为正、0 个违例端点**，比上上一版（+0.003 ns、贴着天花板）安全得多。

> **Fmax 只剩 0.14% 余量的原因与本轮做的五轮抢救**（详见 `docs/显示页证据.md` 第 5 节）：
> `spectrum16` 是一个大算术块（2 个乘法器 + 16 组 32 位累加器 + 32 位优先级编码器）。
> 初版只有 **59.3 MHz**，四轮修改后收敛到 108.437 MHz：
> ① 比较结果 `msb_d` 寄存器化 → 74.0 MHz；② 每槽拆 2 拍、先寄存幅度再做编码 → 98.2 MHz；
> ③ 每槽拆 3 拍（取模 / 累加 / 编码分开）→ 104.6 MHz；④ 频谱柱高提前一级译码
> （`slvl_q` / `stop_q`）→ 108.437 MHz；
> ⑤ 李萨如页加入后最差路径落到状态条译码，把块号 `sbk_q` 与 7 个窗口标志
> 提前一级寄存 → **108.153 MHz**，关键路径转为 `u_spec/bctr → u_spec/re_re`（这一段是当时的记录，现已进一步加固，见 `docs/Fmax加固记录.md`）。
> 加固后已把 16 组累加器改成旋转阵列（当前 bin 恒为 slot 0，消掉全部变址 mux），该路径 slack 从 0.013 升到 0.243 ns，全设计最差路径转移到 `u_lcd/y_q_3 → nr`。若要更大余量，下一步应把 16 组累加器
> 改成时分复用单累加器 + 16 字 BSRAM，或把 N 从 512 降到 256。

> **Earlier**：P2 收尾时是 116.540 MHz（延迟线写回拆成三个 `en` 周期抢回来的），
> P3 多波表时是 124.043 MHz，P0 测试模式时是 119.647 MHz。

### 仿真（`scripts/run_all_sim.ps1`，16 个平台）

```
PASS tb_i2s_tx / tb_audio_out / tb_adsr / tb_mixer16 / tb_osc_bank
PASS tb_wavetable / tb_ttp229_rx / tb_test_mode
PASS tb_fx_echo
PASS tb_liss
PASS tb_spectrum16 / tb_spec_cont / tb_vib_path
PASS tb_inst
== ALL TESTBENCHES PASS ==
```

> `tb_vibrato_lfo` 已被删除：LFO 现在内联在 `top_inst.v` 里，由 `tb_vib_path`
> （直接驱 `osc_bank` 测 `inc_org`）和 `tb_inst` 共同覆盖。

`sim/tb_inst.v` 共 **52 项检查全部 PASS**，从像素流反向验证整条链路：

| 检查项 | 实测 |
|---|---|
| 9 MHz 像素时钟半周期 | 2 个 108 MHz 周期（TB 用 DIV=3 跑快）|
| HS / VS 周期 | 525 pixels / 286 lines |
| 空闲：按键格、包络柱、包络填充 | 全 0；波形是一条平线 |
| 按 1 键：按键格 | **1652 px，只亮 1 格** |
| 按 1 键：波形 | 横跨 119 行（真实正弦）|
| 按 1 键：包络曲线 / 填充 / 柱 | 有曲线、有填充、**柱只有 1 根** |
| **同时按 2 键** | **按键格 2 格；包络柱 2 根** |
| 松手 | 按键格归 0 |
| 锁存模式（Key_2 开启 → 点 TP0、TP1 → 松手）| **2 格保持点亮、2 根包络柱、波形快照静止** |
| 退出锁存模式 | 全部清零 |
| 波形快照 | 相邻两帧的 480 个采样**逐位相同**（`sim/tb_scope_snap.v` 5 项全过）|

---

## 5. 踩过的坑（供复现时注意）

1. **`cell` 是 Verilog 保留字**（config 声明里的关键字），当信号名用会让 iverilog 报
   `syntax error ... invalid module item`，且报错位置飘到别处。源码里改名为 `kcell`。
2. **`localparam signed [15:0] x = 16'sd95;` iverilog 不认**，改成
   `localparam [15:0] x = 16'd95;` 并在使用处写 `$signed(x)`，否则表达式退化成 32 位、
   综合报 `EX3791 截断` 告警。
3. **5 bit 蓝色端口写 `5'd44` 会被截断成 12**（`EX3791`），颜色全跑偏。所有 `lcd_b` 常量必须 ≤ 31。
4. **8 路包络取最大值不能组合做**：串行 7 级 16 bit 比较器把关键路径拉到 **32 级逻辑**，
   Fmax 掉到 34.049 MHz。改成三级寄存器流水（4→2→1）后逻辑级数降到 6。
5. **示波器纵向增益**：混音后单音幅度约 ±2045，早期按 `>>9` 缩放只有 ±4 行、看着像条直线；
   改成 `>>5`（÷32）后占满约 94% 高度。
6. **60 px 一格的倒数乘法必须是 1093 不能是 1085**：`60 × 1085 >> 16 = 0`，第 60 列会被
   算回第 0 格，导致"只按一个键却亮两格"。1093 在 0..600 范围内都是精确的 `x / 60`。
7. **`lcd_dclk = (ph < 4'd6)` 是写死的**：DIV 参数改变后（仿真用 DIV=3）时钟再也不会翻转。
   改成 `(ph < DIV/2)`。
8. **像素流水线的相位号也不能写死**：4 级流水原来固定用 ph 5/7/8/9，DIV=3 时 ph 只到 2，
   整个颜色阶段永不触发、屏幕全背景色。改成按 DIV 折算的 localparam。
9. **引脚寄存器和颜色寄存器必须同拍**：把 `de/hs/vs` 也改成只在像素边界更新，会让
   颜色比 `de` 早一拍，每行多出 1 列 → 单键统计成 1708 px（应该 1680）。已回退。
10. **包络 RAM 的窗口不能写死 `wr_addr - 480`**：包络每 32 个采样才写一次，上电后很久
    都填不满 480 个点，大部分列读到未写入的 0 → 曲线只剩左下角一小截。改成
    "不够 480 点就锚定在 0"。
11. **过零触发必须锚在窗口起点，而且必须用够老的过零**：如果锚在终点，窗口会包含尚未
    写入的采样；如果用过零队列里最新的一项，`(wptr - cz) < 480` 也不成立。最终做法是
    保存最近 4 个上升过零点，取"最老且至少落后 480 个采样"的那个。
12. **过零队列的"年龄"要用计数器算，不能用地址相减**：`wptr - cz` 是 9 位减法、模 512，
    C4 周期 184 时 `552 mod 512 = 40 < 480`，于是 4 个槽里有 3 个永远判不合格，
    约 83% 的帧退回自由运行窗口 → 画面逐帧跳。改成 11 位 `cz_age[0..2]` 计数器后
    帧间差从 89~117 行降到 **1 行**。
13. **新功能凡选通 / 旁路已有信号，一律先在模块内部打一拍**：P0 的 `test_mode` 第一版
    用 `output wire` + `assign` 组合选通，那 1 级 mux 正好串在 `note → inc_lut → <<oct`
    这条最紧路径前面，**Fmax 从 119.185 掉到 108.850 MHz**（约束 108，只剩 0.8%）。
    改成 `reg` 输出、模块内寄存后回到 119.647 MHz，P3 之后进一步升到 124.043 MHz。
14. **`sblk` 的倒数乘法不能用 20 位**：`{10'b0, x_q} * 20'd2731` 在 `x ≥ 384` 时溢出回绕，
    导致状态条右半边的八度梯 / 音色梯又亮了一遍、TEST 红块糊掉 216 px。
    改成 22 位乘法 + 显式 `x` 区间判断（`in_oct/in_tim/in_vol/in_tst/in_wav`）后布局才准。
15. **BSRAM 同步读能救时序**：波表从"1 个组合 ROM"改成"4 表合一的 4096×16 BSRAM"
    之后，读延迟仍是 1 拍、单读端口，槽流水线一行都不用改，Fmax 反而 +4.4 MHz。
16. **乘法 + 移位的宽度由赋值目标决定，不是操作数宽度之和**：
    `xq <= xin * win >>> 8;` 里 `xq` 是 16 位，乘法被压到 16 位后再移位，
    高 8 位在移位前就丢了 → 频谱电平整体低 60 dB。必须给乘积一个显式 24 位 net。
17. **`cos = sin(p + N/2)` 是错的**：`sin(p + N/2) = -sin(p)`，等于把 cos 表读反，
    单音会点亮整排。正确的正交相移是 **`p + N/4`**。
18. **DFT 的乘积必须先预缩放**：满幅音在 bin 中心时单个乘积就是 2^30，512 点累加到
    2^39，32 位累加器直接溢位 → 一个音糊满整个屏。乘积先 `>>10`。
19. **模块被 `swept in optimizing` 意味着它真的被删掉了**，不是提示性告警。
    颤音 LFO 的输出 `vib_abs` 一路没人用，Gowin 把整个 `u_lfo` 优化掉了——
    也就是**上一版位流里颤音在硬件上是死的**。修法：让该输出真的参与显示
    （FX 阶梯随 LFO 呼吸），并用 `grep NBL_CONST` 在综合网表里确认实例存在。
20. **Verilog 里 `6'sd32` 会回绕成 −32**：6 位有符号范围是 −32..+31。测试台写
    `vib_d = 6'sd32` 想测「+32」结果测的是「−32」，据此误判 RTL 有问题。
    正确写法是只用 ±16（或扩宽信号）。

---

## 6. 排错对照表

| 现象 | 检查 |
|---|---|
| 屏幕全黑 | FPC 是否插到底；`lcd_r[2]=N9` 是 SSPI 配置脚，必须带 `-use_sspi_as_gpio 1` 构建（`tcl/build_inst.tcl` 已有） |
| 画面正常但按键没反应 | SCL/SDO 是否接到 **J14 的 8/7 脚**；是否错接 5/6 脚；模块 SCL 空闲时是否被拉高 |
| 只有前 8 个键有反应 | 正常——模块是 8 键模式，不是故障 |
| 按一个键亮两格 | 检查 `lcd_scope.v` 里 60 px 倒数乘法是不是 1093（见踩坑 6） |
| 按键亮但没声音 | I2S 三根线是否接 R8(9)/T7(10)/**T6(11)**；MAX98357 的 **SD 必须接 GND**；VIN 至少 3V3；先用第 12 脚接 3V3 打测试音定位 |
| 声音很小 | Key_3 (D7) 短按几下上调音量（0 dB..+24 dB 循环）；或把 VIN 从 3V3 换成 5V |
| 锁存模式叠了好几个音，听起来「忽强忽弱」像颤抖 | **一共三个独立原因，现在都已修掉**。① `fx_echo` 用拼接 `{din_q[15],din_q}` 做符号扩展（Verilog 拼接永远无符号），负半周被钉在 +32767 → 已改 `wire signed [17:0] wet_sum`（见记录第 12 节）。② 芯片单键模式下来回报键把锁存音翻掉 → 已改「报满 20 ms 才算一次点按、松手前只触发一次」（见记录第 13 节）。③ **两个音本身相距一个全音**：C4+D4 的拍频是 32 Hz、包络每秒约 30 次降到零，任何合成器弹这两个音都是这个听感 → 已把键位布局从 C 大调音阶改成 C 大三和弦琶音 `C4 E4 G4 C5 E5 G5 C6 E6`，相邻格变成三度/四度，拍频升到 62…131 Hz（见第 3.1 节）|
| 想要回原来的 C 大调音阶 | 改 `rtl/input/keymap8.v` 的 `NOTE_TAB` 一行（第 3.1 节给了现成的那一行），重新构建即可；代价是 TP0+TP1 又会有 32 Hz 拍频 |
| 音量按到最低还是偏大 | 0 dB（索引 2）已是 1.0×，再低要改 `keymap8.v` 的 `vol_idx` 下限与 `audio_out.v` 的 Q8 表 |
| 改拨码没变化 | 拨码在复位时采样，改完按一下 T3 复位 |
| 音高偏高/偏低一档 | 八度拨码位 1、2 的组合看第 1.2 节 |
| 波形一直在缓慢滚动 | 已修复：窗口起点改为**每帧只锁存一次**（原来每一行都重锁）；排错表见踩坑 7 |
| 和弦时波形页在两幅形状之间来回跳 | 已修复：历史缓存从 512 深扩到 **1024 深**（`wave_hist.v`），触发源从「混音过零」换成 **0 号声部自己的过零**（`raw_flat[15]`）。原来触发点必须 ≥480 样本旧、而缓存只有 512 深，合法触发区只剩 32 个样本，和弦时过零点随拍频漂移，每帧抓到不同的包络位置 → 画面跳。缓存扩深后合法年龄带变成 480…1023，每帧都能落在同一个相位上（详见 `docs/音量与削波记录.md` 第 17 节）|
| 和弦时一屏看不到完整的「纺锤」包络 | **这是正常的**：C4+E4 的拍频 68 Hz、一个拍 = 14.71 ms = 709 个样本，而一屏只有 480 列 = 9.96 ms，窗口本身就短于一个拍。要看到完整纺锤需要 ≥709 列；扩到 2048×32 的尝试因 108 MHz 时序违例被回退（见记录第 16 节）|
| 上电就进 TEST 模式了 | 上电时 Key_3 (D7) 被按住了。断电重上电、不碰 Key_3 即可 |
| 想进 TEST 模式进不去 | 必须在**复位释放后 1 ms 内**保持 Key_3 按下；先按住再按复位最稳 |
| 想切波表模式切不出来 | 必须**长按 Key_3 约 0.8 秒**（短按只是加音量）；切成功后 `x 192..215` 出现橙块 |
| 波表模式下声音变"脏" | 八度拨到 2 时高次谐波会混叠（三张新表只取到 8 次谐波）。退回八度 0/1，或关掉波表模式 |
| 想切表情/效果档切不出来 | 必须**长按 Key_2 约 0.8 秒**；短按只翻锁存模式。切成功后 x 240..263 出现橙块 |
| 开了延迟后屏上看不到回声 | 正常。屏上波形取的是延迟线**之前**的 mix_out，而且波形窗口只有 9.96 ms，124 ms 的回声本来也画不下 |
| 滑音模式下按哪个键都是同一个音在滑 | 正常。滑音会把**声部 0** 变成跟随最近按键的主奏声部 |
| 颤音听不出来 | 颤音深度只有 ±30 cent（约 1% 音高），是给长音加的歌唱性微颤；拨到 fx 1/3/5/7 档，按住一个键听 2 秒以上 |
| 切不到频谱页 | 必须**长按 Key_2 超过 1.6 秒**（0.8 秒只切表情档）。切成功后 x 320..335 出现紫色格 |
| 切不到李萨如页 | 再长按 Key_2 一次（频谱页之后就是李萨如页）；状态条点亮格数从 2 变 3 |
| 李萨如页只有一条斜线 | 正常。单音时左右声道是同源缩放，X-Y 必然共线；弹和弦或打开颤音/延迟图形就张开 |
| 频谱单音亮了十几根柱 | 那是**颤音开着**（fx 1/3/5/7）：5 Hz 频偏在 512 点窗内把能量摊开了。切到 fx 0/2/4/6 再看 |
| 频谱一个音都没有 | 确认处于「波形页→频谱页」且确有键按下；频谱只看到 1.507 kHz 以下，高把位（八度 2 的高音键）可能落在范围外 |

---

## 7. 文件

| 文件 | 说明 |
|---|---|
| `rtl/top/top_inst.v` | 乐器顶层（触摸 + 32 振荡器 + 混音 + I2S + 显示 + 抗来回报键的锁存 + 过零触发 + 测试模式接入） |
| `rtl/clock/pll_sys.v` | 27 MHz → 108 MHz rPLL |
| `rtl/input/ttp229_rx.v` | TTP229 2-wire 轮询接收 |
| `rtl/input/keymap8.v` | 8 键 → 音高；拨码 → 八度/音色/音量；Key_3 短按音量+、长按切波表；Key_2 短按锁存/长按表情档 |
| `rtl/audio/frame_gen.v` | 2240 clk/帧的时隙与 `sample_tick` |
| `rtl/audio/inc_lut.v` | 29 音（C4…E6）等律相位增量表 |
| `rtl/audio/wavetable_bank.v` + `wav_bank_4096.mem` | **4 张波表**（正弦/三角/锯齿/方波各 1024 点）合成一块 4096×16 BSRAM，唯一的 `$readmemh` |
| `rtl/audio/osc_bank.v` | 32 个独立相位累加器 + 4 种音色幅度表 + 波表分量选表 |
| `rtl/audio/adsr.v` | 每声部一个 ADSR |
| `rtl/audio/mixer16.v` | 8 声部混音 + 饱和限幅 + **轻微声像**（左右各 ±12.5%，`out_l`/`out_r`）|
| `rtl/audio/audio_out.v` | Q8 音量表（0.5x..16x）/ 测试音 / 软拐点限幅（拐点 24576、斜率 1/8）|
| `rtl/audio/i2s_tx.v` | I2S 发送（16 bit/声道，每帧精确 2240 clk） |
| `rtl/audio/test_mode.v` | **现场测试模式**（8 路纯正弦 + 上电窗口锁存） |
| `rtl/audio/fx_echo.v` | **FPGA 内部延迟线 + 混响 + 合唱**：共用一个 8192×16 BSRAM 环，6 路抽头时分复用（每样本 8 个时钟读完），延迟 124.4 ms / 混响 4 抽头 37–97 ms / 合唱 21.2 ms±64 样本 |
| （颤音 LFO） | **内联在 `rtl/top/top_inst.v` 里**（5 Hz 正弦查表，Q10 有符号，输出 `vib_d` + `vib_abs`）；原来独立的 `vibrato_lfo.v` 因输出未被使用而被综合优化掉，已删并入顶层 |
| `rtl/display/spectrum16.v` + `spectrum_sin.mem` | **16 bin 实时频谱**（512 点三角窗 DFT，94.17 Hz/bin，AGC 每档 3 dB）|
| `rtl/display/lcd_timing.v` | 480×272 @ 9 MHz 时序 |
| `rtl/display/wave_buf.v` | 512×**32** 双口 BSRAM，`{R,L}` 立体声混音历史，供李萨如页用 |
| `rtl/display/wave_hist.v` | **1024×16** 单口 BSRAM，波形页专用的单声道历史（比 `wave_buf` 深一倍，才能装下一个拍频周期）|
| `rtl/display/liss_render.v` | **李萨如预渲染器**：512 点 → 每列纵向拉幅 span 表（512×16 BSRAM），在行消隐内完成 |
| `rtl/display/lcd_scope.v` | 波形页 / 频谱页 / **李萨如页** / TEST / WAVE / FX / 显示页 标识的像素流水线 |
| `sim/tb_inst.v` | 整机自检测试平台（57 项，含显示页切换） |
| `sim/tb_test_mode.v` | 测试模式专项（24 项） |
| `sim/tb_wavetable.v` | 波表专项（4096 点逐点比对） |
| `sim/tb_spectrum16.v` / `sim/tb_spec_cont.v` | 频谱专项（块周期音 / 连续相位音）|
| `sim/tb_liss.v` | 李萨如渲染器专项（10 项：映射精度、双极性填带、两侧钳位、清表）|
| `sim/tb_vib_path.v` | 颤音通路专项（直接测 `osc_bank.inc_org`）|
| `sim/tb_i2s_tx.v` / `sim/tb_audio_out.v` | I2S 帧长 / 音量链专项回归 |
| `scripts/run_all_sim.ps1` | 一键跑全部 16 个测试平台 |
| `sim/tb_fx_echo.v` | 延迟线专项（8 项逐拍比对）|
| `sim/tb_fx_rvb_cho.v` | 混响 / 合唱专项（16 项：四抽头位置与增益、LFO 调制、反馈再生）|
| `constraints/inst.cst` | 35 个管脚约束 |
| `inst.gprj` / `tcl/build_inst.tcl` / `scripts/build_inst.ps1` | 工程与构建脚本 |
| `impl_inst/pnr/inst.fs` | **烧录用位流**（7,264,154 B） |
| `docs/测试模式证据.md` | 测试模式的赛题取证文档 |
| `docs/多波表证据.md` | 四张独立波表的赛题取证文档 |
| `docs/滑音颤音延迟证据.md` | 滑音 / 颤音 / 延迟的赛题取证文档 |
| `docs/显示页证据.md` | 波形页 / 频谱页的赛题取证文档 |
| `docs/李萨如证据.md` | 真立体声 L/R 李萨如页的赛题取证文档 |
| `docs/音量与削波记录.md` | 「锁存多音颤抖」的三轮诊断：削波/音量、`fx_echo` 符号扩展、单键模式来回报键；含拍频实测谱 |
| `docs/Fmax加固记录.md` | 时序瓶颈定位与旋转阵列 / 流水化改造记录 |
| `docs/李萨如证据.md` | 李萨如（X-Y）页的赛题取证文档 |
