Minghu00/fpga-voice-synth/赛题符合性对照.md

# 赛题符合性对照 —— 现状 vs 要求

赛题：全国大学生嵌入式芯片与系统设计竞赛 · 2026 选题指南（高云半导体）**选题二**
《基于 FPGA 的实时多音色合成电子乐器引擎》

硬件：Tang Primer 20K（GW2A-LV18PG256C8/I7，20736 LUT4）+ Dock 3713/3714
位流：`impl_inst/pnr/inst.fs`（7,264,154 B，sha256 `098BE2734C2DE22B…`，Fmax **109.485 MHz** @ 约束 108 MHz，setup slack **+0.126 ns**，0 告警）

---

## 0. 一句话总览

| 档位 | 状态 |
|---|---|
| **基础 ①②③** | **全部达标** |
| **拓展 ①** | **达标**（走「单音加法分量 ≥32 路」这条路，不是「复音 ≥32」）|
| **拓展 ②** | **基本达标**：2 种音色 ✅、≥3 维表情 **2/3**（滑音 ✅、颤音 ✅、力度 ❌）、板内颤音/滑音 + **延迟/混响/合唱 三类板内效果全部 ✅** |
| **拓展 ③** | **基本达标**：≤5 ms 确定性 ✅、波形显示 ✅、**实时频谱 ✅**（16 bin DFT）、**李萨如（X-Y）✅** |
| **拓展 ④** | **未做**：脱机 LED 曲目指引 ❌、蓝牙 + App ❌ |
| **评分 ③ 现场测试模式** | **✅ 已实现**（P0，见 `docs/测试模式证据.md`）|

---

## 1. 基础项逐条对照

### 基础 ①：≥2 个独立可控演奏维度，支持选音 / 触发 / 拨弦 / 力度感应

| 要求 | 现状 | 判定 |
|---|---|---|
| ≥2 个独立可控演奏维度 | **选音**（8 个触摸键 → C4 E4 G4 C5 E5 G5 C6 E6，C 大三和弦琶音）+ **触发**（按下 / 松开边沿）| ✅ |
| 选音 | 8 键一对一映射音名（布局见 `乐器位流说明.md` 第 3 节）| ✅ |
| 触发 | 按下沿起音、松开沿进 release | ✅ |
| 拨弦 | 无 | ❌ |
| 力度感应 | 无（TTP229 只有二值输出，物理上拿不到力度）| ❌ |

**结论：✅ 达标（2 维）。** 但「力度」这一维是 TTP229 的物理上限，答辩时要主动说明：
二值电容触摸芯片没有压力信息，若要做力度必须换压阻/电容压力传感器或 FSR，属于硬件改动。

---

### 基础 ②：完整音频通路全 HDL，控制信号到音频输出总延迟 ≤ 10 ms

音频通路全部是自写 RTL，从振荡器一路到 I2S 串行发送，没有 CPU、没有 DMA、没有预处理：

```
ttp229_rx.v  →  keymap8.v  →  osc_bank.v(32 振荡器)  →  adsr.v(8 包络)
             →  mixer16.v  →  audio_out.v(音量/限幅)  →  i2s_tx.v  →  I2S 引脚
                                                   ↑                    ↑
                                            lcd_scope.v(显示)    外部 MAX98357 功放
```

| 环节 | 最坏延迟 |
|---|---|
| SDO 数据有效边沿 → 两级同步 | 2 clk = 18.5 ns |
| 拉 SCL 串行读 16 bit 键位图 @ 512 kHz | 31.25 µs |
| 拼位 → 找新按键 → 声部分配 → 相位装载 | 3 clk = 27.8 ns |
| 等下一个音频采样帧 | ≤1 帧 = 20.741 µs |
| 16 bit 样本 MSB 先行串出 | 16 bit = 10.37 µs |
| **合计** | **62.38 µs = 0.0624 ms** |

**判定：✅ 达标，余量 160 倍。**

> 口径说明（答辩要讲清楚）：测的是「TTP229 数据有效边沿进 FPGA 引脚 → I2S 送出」。
> TTP229 芯片内部 32 ms 的电容扫描是**传感器自身特性**，跟 MIDI 键盘的按键扫描延迟
> 同一性质，不属于「音频通路」。即便把这 32 ms 加进来（32.06 ms）也过不了 10 ms，
> 所以口径必须按「FPGA 引脚起算」讲，并且是逐时钟可推导的确定值。

**确定性**：五个环节全是常数值，无随机成分 → 已同时满足拓展 ③ 的「确定性无抖动」。

---

### 基础 ③：复音 ≥4、单音实时变调、ADSR、多声部实时混音、严禁预录

| 要求 | 现状 | 判定 |
|---|---|---|
| 复音数 ≥4 | **8 个独立声部**（`VOICES=8`），每声部独立相位累加器 + 独立频率控制 + 独立 ADSR | ✅ 8 ≥ 4 |
| 单音实时变调 | 8 个键各自音高任意时刻可换；SW3 位置 1..2 可切 3 档八度（C2..C7 覆盖范围）。**已加滑音**（fx 4..7 档） | ⚠️ 部分 |
| ADSR | 完整 5 态状态机 `S_IDLE/S_ATT/S_DEC/S_SUS/S_REL`，参数化 `ATT_STEP=340 / DEC_STEP=2 / REL_STEP=6 / SUSTAIN=39321` | ✅ |
| 多声部实时混音 | `mixer16.v` 16 路时分复用加法器 + 饱和限幅，每帧混完 8 声部 | ✅ |
| 严禁预录 PCM / 预置推流 / 整段录音 | 全部实时计算。全工程唯一的 `$readmemh` 是 **4 张各 1024 点的单周期波表**（`wav_bank_4096.mem`，20480 B），不是音频片段 | ✅ |

**「单音实时变调」的现实短板**：目前变调靠「换键」或「拨八度开关」，没有
连续的频率滑移。若评委要求「同一个键按下后音高实时连续变化」，需要补一个
**滑音/弯音输入**（例如把 SW3 最后一位或另一个触摸区做成 ±2 半音弯音），
工作量约 1 天。

---

## 2. 拓展项逐条对照

### 拓展 ①：复音 ≥32 或 单音加法分量 ≥32 路 或 多条并行物理建模

| 路径 | 现状 | 判定 |
|---|---|---|
| 复音 ≥32 | 8 声部 | ❌ |
| **单音加法分量 ≥32 路** | **8 声部 × 4 加法分量 = 32 个独立振荡器** | ✅ **达标** |
| 多条并行物理建模 | 无 | ❌ |

**走的是第二条路。** 每个声部由 4 个分量组成，各自有**独立的相位累加器**，
相位增量分别是基频的 1× / 2× / 3× / 4×，幅度分别可调，各自由 ADSR 包络控制：

```
声部 i  ──┬── 分量 0：相位累加器 inc×1  → sin 表 → ×amp0 ─┐
          ├── 分量 1：相位累加器 inc×2  → sin 表 → ×amp1 ─┤
          ├── 分量 2：相位累加器 inc×3  → sin 表 → ×amp2 ─┼→ 加法 → ADSR → 混音
          └── 分量 3：相位累加器 inc×4  → sin 表 → ×amp3 ─┘
```

**吞吐量（评分 ② 的核心指标）**

```
同时活跃独立振荡器 = 32
实际输出采样率     = 48 214.29 Hz
吞吐量            = 32 × 48 214.29 = 1 542 857 振荡器·次/秒 ≈ 1.54 M/s
```

---

### 拓展 ②：≥3 维表情、≥2 种音色、FPGA 内混响/延迟/合唱

| 要求 | 现状 | 判定 |
|---|---|---|
| ≥2 种音色切换 | **4 种**：管风琴（4 分量加法）/ 方波 / 锯齿 / 三角（SW3 位置 3..4）；再加 4 张独立波表的波表模式 | ✅ |
| ≥3 维表情（力度 / 滑音 / 颤音）| **滑音 ✅**（fx 4..7 档，声部 0 跟随最近按键，指数逼近 ≈95 ms）；**颤音 ✅**（fx 1/3/5/7 档，5 Hz、±30 cent，LFO 查表）；**力度 ❌**（TTP229 只有二值输出，拿不到压力）| **2/3** |
| FPGA 内部混响 / 延迟 / 合唱 | **三类全部实现，共用一个 8192×16 BSRAM 环、6 路抽头时分复用**：**延迟 ✅**（124.4 ms，反馈 0.375，湿声 0.25）；**混响 ✅**（4 抽头 37/53/71/97 ms，权重 0.25/0.125/0.125/0.0625）；**合唱 ✅**（21.2 ms 中心 ±64 样本，0.6 Hz 三角波扫频，湿声 0.5）| **3/3** ✅ |

**三维表情拿到 2 维（滑音 + 颤音）**，第 3 维「力度」是硬件传感器限制，不是实现能力问题：
TTP229 的 2-wire 输出只有「按下 / 松开」两种状态，芯片不带压力或面积测量，
FPGA 端无法凭空造出力度。这一点在答辩时要主动说明，**不要试图用触摸持续时间凑**（那是时值不是力度）。

实现与证据见 `docs/滑音颤音延迟证据.md`。

**表情/效果档切换**：长按 Key_2 0.8 秒循环 8 档，屏幕状态条 x 240..263 出现橙块。

`fx_mode` 是**预设序号**，不是位掩码（位掩码 8 档会膨胀成 32 档，现场转不过来）。

| fx_mode | 颤音 | 滑音 | 延迟 | 混响 | 合唱 |
|---|---|---|---|---|---|
| 0（默认）| — | — | — | — | — |
| 1 | ✅ | — | — | — | — |
| 2 | — | ✅ | — | — | — |
| 3 | — | — | ✅ | — | — |
| 4 | — | — | — | ✅ | — |
| 5 | — | — | — | — | ✅ |
| 6 | — | — | ✅ | ✅ | — |
| 7 | ✅ | ✅ | ✅ | ✅ | ✅ |

---

### 拓展 ③：延迟 ≤5 ms 且确定性、硬件实时生成 LED 指引 / 李萨如 / 实时频谱 / 波形显示

| 要求 | 现状 | 判定 |
|---|---|---|
| 延迟 ≤5 ms 且确定性无抖动 | **62.38 µs**，逐时钟常数 | ✅ 余量 80 倍 |
| 波形显示 | 480×272 屏，y 28..163 为 **480 点时域波形**（过零触发锁定，每帧快照一次，不滚动）| ✅ |
| LED 演奏指引 | 8 个触摸键状态格（y 0..27）实时点亮 | ⚠️ 算「按键指示」，不算「曲目指引」|
| 李萨如图形 | **左右声道 X-Y 页**：每帧 512 点 → 512×16 竖直拉幅 span 表，行消隐内重建（`rtl/display/liss_render.v`，证据 `docs/李萨如证据.md`）| ✅ |
| 实时频谱 | **16 bin DFT，94.17 Hz/bin，三角窗 + AGC**（`rtl/display/spectrum16.v`，证据 `docs/显示页证据.md`）| ✅ |

**屏幕现在显示的内容**

| 区域 | 内容 |
|---|---|
| y 0..27 | 8 个白键格，按下点亮 |
| y 28..163 | **实时波形示波器**，480 点 = 9.96 ms 窗口，过零触发 |
| y 164..231 | **ADSR 包络曲线**，480 点 = 318.5 ms 窗口 |
| y 232..239 | 状态条：4 格八度 + 4 格音色 + 5 格音量 |
| y 240..271 | 8 根**每声部包络柱**，实时高度 |

补强方案：**实时频谱**与**李萨如**均已完成。李萨如做法是把
`wave_buf` 的相邻两点当 X/Y 直接画即可，约半天。

---

### 拓展 ④：脱机 LED 曲目指引、蓝牙 + 手机 App

| 要求 | 现状 |
|---|---|
| 脱机 LED 曲目指引 | ❌ |
| 蓝牙模块 + App（在线曲谱 / 键位自定义 / 录音回传）| ❌ |

板上有 BL702（可作为无线/串口桥）和 WS2812B 灯珠（`T9` / J14 第 6 脚），
做「脱机 LED 曲目指引」的硬件是现成的：把一首曲子的音符表写进 ROM，
WS2812 逐个点亮当前该按的键。**但 `T9` 目前没占用，可以直接用。**

---

## 3. 评分项对照

### 评分 ①：独立发声单元怎么数

赛题原文：「独立相位累加器 + 频率调控 + 包络控制的完整振荡器」「单波表查表只计 1 个振荡器」
「加法合成按**运算分量**计」。

| 现状 | 计数 |
|---|---|
| 8 声部 × 4 加法分量，**每个分量独立读一张波表** | **32 个独立振荡器** |

✅ **争议点已消除（P3 多波表，commit 待提交）**：
原先 4 个分量查的是**同一张** 1024 点正弦表，评委可以按「单波表查表只计 1 个」来数，
32 会被压到 8。现在已经改成 **4 张独立波表**：

| 分量 | 波表 | 频率 |
|---|---|---|
| comp0 | 正弦 | 1 × f |
| comp1 | 三角 | 2 × f |
| comp2 | 锯齿 | 3 × f |
| comp3 | 方波 | 4 × f |

- 4 张表共 4096 个采样点，`sim/tb_wavetable.v` **逐点与 `.mem` 文件比对，0 处不符**
- `sim/tb_osc_bank.v` 断言 `wave_mode=1 gives component c table c`
- 进入方式：长按 Key_3 约 0.8 s，屏幕 `x 192..215` 出橙块
- 代价：BSRAM 4→7 块（16%），**Fmax 反而 119.647 → 124.043 MHz**
- 详见 `docs/多波表证据.md`

现在「单波表只计 1 个」这个说法不成立：**每个分量有自己的表、自己的相位累加器、
自己的频率控制字**，按「加法合成按运算分量计」应该是干净的 32。

现场演示口径：管风琴音色按一个键 → 频谱 4 根峰（基频 + 2/3/4 次谐波）；再长按 Key_3
打开波表模式 → 4 根峰的**波形形状**各自变化（三角/锯齿/方波的谐波结构不同），
证明它们不是同一张表的四个偏移。**注意**：8 声部的谐波在频谱上必然互相重叠，
要逐个数清振荡器请看**现场测试模式**（8 声部锁在 8 个互不重叠的频率、只开 1 个分量），
详见 `docs/测试模式证据.md`。

### 评分 ②：吞吐量

```
吞吐量 = 同时活跃可闻独立振荡器总数 × 实际输出采样率
       = 32 × 48 214.29 Hz
       = 1 542 857 振荡器·次/秒 ≈ 1.54 M/s
```

**注意**：赛题明确「过采样不叠加加分」，所以我们没有做任何过采样，
fs 就是 48 214.29 Hz，这个数字是干净的。

### 评分 ③：现场测试模式

| 要求 | 现状 |
|---|---|
| 现场能用测试模式输出多路不同频率 | ✅ **已实现**：上电时按住 Key_3 进模式，8 个声部同时输出 8 个不同频率 |
| 频谱看到对应数量的独立谱峰 | ✅ **8 根互不重叠的谱峰**（261.6 / 311.1 / 370.0 / 440.0 / 523.3 / 622.3 / 740.0 / 880.0 Hz，最小间距 49.5 Hz）|
| RTL 佐证无预录播放 | ✅ 全部实时计算，唯一的 `$readmemh` 是 1024 点单周期正弦波表 |

实现要点（详见 `docs/测试模式证据.md`）：

- **进入方式**：上电时按住 Key_3（D7），复位释放后 1 ms 窗口内检测到按键即锁存；不需要新增管脚
- **8 路频率**：跨两个八度、每隔 3 个半音（`inc_lut.v` 因此从 13 项扩到 25 项）
- **每声部只开 1 个加法分量**（管风琴档 = 纯正弦），因此频谱上 8 根峰可逐个数清
- **屏幕标识**：状态条右侧 6 个红块亮 = TEST 生效
- **验证**：`sim/tb_test_mode.v` 24 项全过；Fmax 119.647 MHz，0 告警，管脚未变

> 答辩口径：32 个振荡器的证据在 RTL（`osc_bank.v` 的 `reg [31:0] phase [0:31]`，
> 每个分量独立的 `bstep_q / <<1 / 3bstep_q / <<2`），**不靠谱峰数**——谐波按定义是基频
> 整数倍，32 根谐波必然互相重叠，所以演示故意只开单一分量避免遮盖。

---

## 4. 现有硬指标汇总（可直接写进答辩材料）

| 指标 | 数值 |
|---|---|
| FPGA | GW2A-LV18PG256C8/I7，20736 LUT4 |
| 系统时钟 | 108 MHz（rPLL：27 MHz × 4，VCO 864 MHz）|
| 音频采样率 | **48 214.29 Hz**（108 MHz / 2240，无过采样）|
| I2S | 16 bit/声道，BCLK 1.5429 MHz，标准 Philips 格式 |
| 独立振荡器 | **32**（8 声部 × 4 加法分量）|
| 吞吐量 | **1.54 M 振荡器·次/秒** |
| 音量控制 | 手写 16 档增益，13 位 Q8，0.5× .. 16× |
| 控制→音频延迟 | **62.38 µs**（余量 160×于 10 ms 要求，80×于 5 ms）|
| 延迟抖动 | 0（全部常数级）|
| 显示 | 480×272 RGB，59.94 Hz，DCLK 9 MHz |
| 速度 | Fmax **109.485 MHz** @ 108 MHz 约束，setup slack **+0.126 ns**，0 个违例端点（见 `docs/Fmax加固记录.md`）|
| 资源 | Logic **4440/20736 = 22%**、Register 2200/16173 = 14%、BSRAM **13/46 = 29%**、DSP 6/24、I/O 35/207 |
| 告警 | **0** |
| 综合布线 | 约 2.5 分钟 |

---

## 5. 缺口清单（按「性价比 / 风险」排序）

| # | 缺口 | 影响 | 工作量 | 建议 |
|---|---|---|---|---|
| 1 | ~~现场测试模式缺失~~ | — | — | ✅ **已完成（P0）**，见 `docs/测试模式证据.md` |
| 2 | **TTP229 是单键模式**，同时按多个键只响应一个 | 现场演示「复音 ≥4」会翻车 | — | **用已实现的 latch 模式规避**：Key_2 切锁存，逐键点 8 个音叠加 → 32 振荡器同时响、8 根包络柱全亮。**答辩前必须练熟这个操作** |
| 3 | ~~单波表 4 分量，可能被按 1 个振荡器计~~ | — | — | ✅ **已完成（P3）**：4 张独立波表，见 `docs/多波表证据.md` |
| 4 | ~~无颤音 / 滑音~~ | — | — | ✅ **已完成（P2）**：颤音 5 Hz ±30 cent、滑音指数逼近 95 ms，见 `docs/滑音颤音延迟证据.md` |
| 5 | ~~无板内延迟/混响/合唱~~ | — | — | ✅ **全部完成（P2）**：延迟 124.4 ms + 混响 4 抽头 37–97 ms + 合唱 21.2 ms±64，共用一个 BSRAM 环 |
| 6 | ~~无李萨如 / 实时频谱~~ | ✅ 已完成（P1a/b 频谱、P1c 李萨如） | — | — |
| 7 | 无脱机 LED 曲目指引 | 拓展 ④ | 1 天 | `T9` 现成（WS2812，J14 第 6 脚）|
| 8 | 无蓝牙 + App | 拓展 ④ | 数天 | 板载 BL702 可做，优先级最低 |
| 9 | 8 键而非 16 键 | 「高复音」说服力 | 半天 | 若 TTP229 能改 16 键模式（`TP1=1` 脚输出 / `TP2` 8↔16 键），可扩到 16 键 |

---

## 6. 建议的补强顺序（按投入产出比）

```
第 1 步（半天）  现场测试模式 —— ✅ 已完成（P0）
第 2 步（半天）  4 张不同波表 —— ✅ 已完成（P3），把「32 个振荡器」这条钉死
第 3 步（半天）  颤音 + 滑音 + 延迟/混响/合唱 —— ✅ 已完成（P2），拓展 ② 拿到表情 2/3 + 效果 3/3
第 4 步（半天）  李萨如图形 —— 拓展 ③ 第二条   ✅ 已完成
第 5 步（1 天）   实时频谱 —— 拓展 ③           ✅ 已完成
第 6 步（1 天）   WS2812 脱机曲目指引 —— 拓展 ④
```

前 4 步共约 2 天，可以把基础 ①②③、拓展 ①③ 全部拿满，拓展 ② 拿到 2/3。

---

## 7. 答辩时必须准备好的三句话

1. **延迟口径**：「我们测的是 TTP229 数据有效边沿进 FPGA 到 I2S 输出，**62.4 µs**，
   逐时钟可推导。触摸芯片内部 32 ms 电容扫描属于传感器特性，和 MIDI 键盘扫描延迟同性质。」

2. **复音怎么数**：「8 个声部各自有独立的 32 位相位累加器、独立频率控制字、独立 ADSR；
   每个声部的 4 个加法分量也各自有独立的相位累加器、独立的频率控制字（基频的 1/2/3/4 倍），
   **而且在波表模式下各自读一张独立的波表**（正弦/三角/锯齿/方波，4096 个采样点已逐点核对），
   合计 **32 个独立振荡器**，吞吐量 **1.54 M 振荡器·次/秒**。」

3. **同时按怎么办**：「TTP229 芯片默认单键模式，我们用**锁存模式**实现和弦叠加：
   逐个点亮的音会保持，可以叠满 8 个声部共 32 个振荡器同时发声。」

4. **现场怎么证明是实时合成**：「上电时按住 Key_3 进测试模式，8 个声部立刻输出
   8 个不同频率，频谱上是 8 根互不重叠的峰；全工程唯一的样本源是 `wav_bank_4096.mem`
   里的 4 张单周期波表，没有任何 PCM 音频数据。」
