Minghu00/fpga-voice-synth/延迟达标分析.md

# 延迟达标分析 —— 唯一交互通道是 TTP229 16 键触摸

> 配套：`交互方案_TTP229.md`、`显示方案_RGB.md`、`赛题方案.md`

---

## 0. 口径（已锁定）

**测量起点**：TTP229 的 SDO 引脚上出现「数据有效」边沿、到达 FPGA 引脚的那一刻（即控制信号变成电信号）。
**测量终点**：I2S 的 `DIN` 开始送出对应音符的第一个样本位。
**这就是赛题说的「完整音频通路全 HDL」的控制信号到音频输出总延迟。**

| 算法 | 数值 | ≤10 ms | ≤5 ms |
|---|---|---|---|
| **FPGA 引脚 → I2S 输出**（考核对象） | **62.4 µs = 0.0624 ms** | ✅ **余量 160 倍** | ✅ **余量 80 倍** |
| 手指触摸 → 喇叭出声（含 TTP229 内部扫描 32 ms） | 32.062 ms | ❌ 不计入 | ❌ 不计入 |

**关键变化**：因为交互只有 TTP229，FPGA 里**不需要任何按键消抖**（芯片内部已经做完消抖），
所以延迟从原来按机械键算的 1.03 ms 直接掉到 **62.4 µs** —— 比之前好看 16 倍。

---

## 1. TTP229 的硬件边界（数据手册原文，`docs\datasheet_ttp229\触摸IC_TTP229.txt`）

### 1.1 扫描响应时间

```
Electrical Characteristics (VDD=3V)

Output Response Time (at operation)      TR
    set 16-keys ..................... 32 mS
    set 8-keys ...................... 16 mS

Wake-up Response Time (at sleep mode)    TWU
    Sampling rate 8Hz ............... 125 mS
    Sampling rate 64Hz .............. 15.6 mS
```

### 1.2 2-wire 串行接口时序（第 606~612 行）

```
DV    (数据有效脉宽)   typ  93 us
Tw    (时钟脉宽 min)        10 us
Tout  (SCL 超时复位)   typ   2 ms   ← 不是延迟！别加进链路
T_resp(16-KEYS)        typ  32 ms
T_resp(8-KEYS)         typ  16 ms
F_SCL                 1K ~ 512K Hz
```

**注意 `Tout = 2 ms` 是 SCL 无跳变超时复位，不是延迟。** 加进去会算成 34 ms，反而说不清。

### 1.3 结论

- 16 键模式扫描周期就是 **32 ms**，由 `TP2(KYSEL)` 选择 8/16 键，**没有 4 键档位**。
- 想凑 16 键必须 32 ms；降到 8 键是 16 ms —— **两条路都过不了 10 ms**。
- 换配置、写任何 RTL 都改不了这一点。

---

## 2. 为什么"控制信号"必须指 FPGA 边界（逻辑证明，答辩可直接讲）

**基础①** 把「电容触摸」列为交互维度之一。
**基础②** 要求控制信号到音频输出 ≤10 ms。

**如果**"控制信号"指手指接触电极的物理时刻，那么 ≤10 ms 就要求触摸芯片内部扫描 <10 ms。
但常规电容触摸 IC 扫描周期普遍在 10~50 ms，TTP229 最快也只有 16 ms。

**于是基础①和基础②互相矛盾** —— 满足①就必须用触摸传感器，用了就必然突破②。

**两项要求必须能同时满足，所以"控制信号"只能指已经变成电信号、进入 FPGA 的那个信号。**
这也正好符合同一条款前半句「**完整音频通路全 HDL**」—— 这句话限定的范围就是 FPGA 内部，
考核的是"音频通路有没有偷偷缓存、有没有预录播放"。

> **答辩话术**：
> 「赛题说的是『完整音频通路全 HDL』的控制信号到音频输出延迟。我们测的就是这个：
> 从 TTP229 的数据有效边沿进 FPGA 引脚，到 I2S 送出，**62.4 µs**，逐时钟可推导、完全确定。
> 触摸芯片内部 32 ms 的电容扫描属于传感器自身特性，跟 MIDI 键盘的扫描延迟是同一性质，
> 不在音频通路上。」

---

## 3. 逐级延迟推导（可上示波器逐项核对）

时钟与帧结构：

| 参数 | 值 |
|---|---|
| sys_clk | **108 MHz**（13.5 MHz × 8），T = 9.259 ns |
| 音频帧长 | 2240 clk |
| fs | 108 MHz / 2240 = **48 214.286 Hz**，帧周期 **20.741 µs** |
| BCLK | 108 MHz / 70 = **1.5429 MHz**，1 bit = **648.1 ns** |
| SCL | **512 kHz**（手册上限），1 bit = 1953 ns |

| # | 环节 | 最坏延迟 |
|---|---|---|
| 1 | SDO 数据有效边沿 → 异步输入 2FF 同步 | 2 clk = **18.5 ns** |
| 2 | 拉 SCL 串行读 16 bit 键位图 @512 kHz | **31.25 µs** |
| 3 | 拼位 → 与上一帧异或找新按键 → 声部分配 → 相位装载 | 3 clk = **27.8 ns** |
| 4 | 等下一个音频采样帧（采样锁存） | ≤1 帧 = **20.741 µs** |
| 5 | 16 bit 样本左声道 MSB 先行串出 | 16 bit = **10.37 µs** |
| **合计** | | **62.38 µs = 0.0624 ms** |

### 3.1 灵敏度分析（SCL 速度可以保守一点）

| F_SCL | 16 bit 读时长 | 总延迟 | vs 10 ms |
|---|---|---|---|
| 512 kHz | 31.25 µs | **62.4 µs** | 160× |
| 400 kHz | 40.00 µs | **71.1 µs** | 141× |
| 250 kHz | 64.00 µs | **95.1 µs** | 105× |
| 100 kHz | 160.0 µs | **191.1 µs** | 52× |

**就算保守到 100 kHz，也只有 0.19 ms，余量 52 倍。** 所以 SCL 速度可以放心压慢换取信号完整性。

### 3.2 确定性（无抖动）

第 1/3 项是固定几个时钟，第 4 项上限固定 1 帧，第 5 项固定 16 bit —— **全部是常数，无随机成分**。
消抖由 TTP229 芯片内部完成，FPGA 侧零额外确认。所以拓展③的「确定性无抖动」满足。

> ADSR 的 attack 上升沿不算延迟：声音在第一个样本就已经出来。
> 若评委要求"可闻"，attack 设 1 ms，则再过约 1/16 满幅即 62 µs 就到可闻阈值。

---

## 4. ⚠️ 必须处理的两个隐藏陷阱（比 32 ms 更要命）

数据手册第 9 节 Figure 9-2（第 852~870 行）和自动校准一节（第 817~823 行）：

```
After detected key release and do not any trigger about 8sec
        → 进入 Sleep mode
Sleep mode 每约 4 秒做一次 Re-calibration，校准期间所有功能 disable
Sleep mode 下唤醒采样率由 TP5 选择：8Hz(125ms) / 64Hz(15.6ms)
```

### 陷阱 1：静置 8 秒后进入睡眠，第一次触摸变成 15.6~125 ms

对乐器是致命的：**演示中间停顿超过 8 秒，下一句的第一个音就会迟到 125 ms。**
默认 `TP5(WPSCT) = 1` → **8 Hz 采样 → 125 ms**。

### 陷阱 2：睡眠期每 4 秒一次自动校准，校准期间触摸被忽略

如果第一下触摸正好落在校准窗口里，**这个音会直接丢**。评委会以为板子坏了。

### 解决方案（按优先级）

**① 把 `ENSLP` 引脚接地，关闭睡眠模式（最优，一劳永逸）**

手册第 949~950 行选项表：
```
ENSLP   1    Sleep mode enable    Default
        0    Sleep mode disable
```
第 953~954 行说明 `0` 状态就是「REGEN、SLSERT、ENSLP 引脚直接接 VSS」。

关掉睡眠 → 永远在 operation 模式 → **永远 32 ms，不会再有 125 ms 和丢音**。

> **需要你确认**：把这颗 TTP229 模块翻过来看看，有没有丝印 **ENSLP / SLP / SL** 的焊盘或跳线？
> 常见 16 键模块只在侧面引出 `VCC GND SCL SDO` 四针，最多加一个 8/16 键跳线，
> 不一定把 ENSLP 引出来。**如果有，焊一根线到 GND 就彻底解决了。**

**② 如果没有 ENSLP 焊盘，退而求其次**

- 检查有没有 `TP5` 焊盘，接高阻到 GND 可把唤醒采样改成 **64 Hz → 15.6 ms**。
  **代价**：TP5 同时是 `KEY-5`，接了下拉就少一个琴键（16→15）。**不建议**。
- 否则只能**在演示流程上规避**：任意两段演奏之间不要停顿超过 8 秒，
  或在长停顿前先摸一下屏幕/按键唤醒。

**③ 无论哪种情况，都要在 FPGA 侧做一件事**

检测 `SDO` 连续 **>200 ms 无 DV 边沿** → 判定进入睡眠 → 状态行显示 `SLEEP` 提示。
这样演示时你知道它睡了，先摸一下把它唤醒再正式演奏。

---

## 5. 怎么向评委证明（要动手做）

### 证据 1：屏幕状态行实时显示计数器（必做）

```
LAT_FPGA  62us      ← 从 SDO 边沿算，我们的考核值
LAT_SENS  32000us   ← TTP229 手册 TR 值，主动摆出来
LAT_TOTAL 32062us   ← 两者之和
```

FPGA 内部实现：

```verilog
// SDO 数据有效边沿
always @(posedge clk) if (sdo_dv_edge) lat_start <= sys_cnt;
// I2S 帧起始（送出新样本的那一刻）
always @(posedge clk) if (i2s_frame_start) lat_val <= sys_cnt - lat_start;
```

硬件实测值会稳定在 62~72 µs（取决于 SCL 档位），一按就知道。
**主动把 32 ms 摆出来再解释，比被问出来强得多。**

### 证据 2：双通道示波器（最有力）

| 通道 | 探测点 |
|---|---|
| CH1 | TTP229 模块的 **SDO** 引脚 |
| CH2 | I2S 的 `DIN`（MAX98357 的 DIN 脚） |

触发 CH1 数据有效边沿，测 CH2 出现对应数据位的时刻差。

> 更干净的做法：FPGA 在收到新按键事件的同一帧内，把该帧样本强制写成 `0x7FFF` 单点特征值。
> CH2 上会出现一个尖峰，时间差一目了然。这个标记脉冲只在按下瞬间出现一次，
> 正常演奏听不出来，**专门给测试模式用**。

### 证据 3：RTL 可静态审查

延迟链全部由常数和计数器构成，没有任何 FIFO 深度、没有 RAM 缓存音频。
唯一的 BSRAM 是显示用的波形缓冲，**读出来只给屏幕，不回流音频链路**。
这同时正面回应「严禁预录 PCM / 预置推流」。

---

## 6. RTL 纪律：别自己把 62 µs 搞坏

| 禁止 | 原因 | 影响 |
|---|---|---|
| ❌ FPGA 侧再做 N 帧确认/消抖 | 芯片已消抖，重复消抖纯浪费 | N×32 ms |
| ❌ 轮询周期做成 2×32 ms | 会漏掉半次扫描 | +32 ms |
| ❌ SCL 降到 1 kHz（手册下限）| 16 bit 要 16 ms | +16 ms |
| ❌ 中断式读取（等 SCL 空闲再读） | 白等一个扫描周期 | +32 ms |
| ✅ 应做：SDO 边沿中断 → 立即拉 SCL 读 16 bit | 零等待 | 31.25 µs |

**FPGA 侧设计原则：把 TTP229 当"电平一变就立刻读"的器件，不要当"定时轮询"的器件。**

---

## 7. 附带提醒：交互维度只剩 TTP229 要注意的事

交互只用 TTP229 16 键，能直接拿到的维度：

| 维度 | 能否从 TTP229 得到 | 实现 |
|---|---|---|
| **选音**（音高） | ✅ 16 键位置 | 键位图 → 音名 |
| **触发** | ✅ 触摸即触发 | 边沿检测 |
| **滑音 glissando** | ✅ 手指划过键位 | 连续键变化 → 端口滑音 |
| **颤音 vibrato** | ✅ 用功能键开启 LFO | 某键当 modifier，LFO 调制相位增量 |
| **力度 velocity** | ❌ 二值输出，无压力信息 | 拿不到 |

**所以拓展②的「≥3 维表情（力度/滑音/颤音）」可以靠 滑音 + 颤音 + 第三个维度补齐，
但"力度"这一项拿不到真实值。**

两个可选补救（成本都很低，先不做也行）：

1. **用键位数当伪力度**：手指按住 2 个相邻键 = 力度大（TTP229 支持多键）。
   理论可行但实际噪声大，不推荐。
2. **留一个功能键循环切换力度档**（软力度）：诚实标注为"力度档位选择"，不是压力感应。

> 基础①只要求「≥2 维」，**选音 + 触发就已经满足**。力度缺失只影响拓展②的加分，不影响基础达标。
> 但答辩时要主动说明，别等评委问。

---

## 8. 小结

| 项目 | 结论 |
|---|---|
| 考核延迟 | **62.4 µs**（512 kHz SCL），160 倍余量 |
| 保守延迟 | 71 µs @400 kHz / 95 µs @250 kHz，都远超要求 |
| 确定性 | 全常数，无抖动 ✅ |
| 最大风险 | ❌ 不是 32 ms，而是 **8 秒静置后的 125 ms 睡眠唤醒 + 4 秒一次的校准丢音** |
| 首要动作 | 确认 TTP229 模块有没有 **ENSLP** 焊盘，有就接地 |
| 必须做的功能 | 状态行显示 `LAT_FPGA / LAT_SENS / SLEEP`，示波器可复核 |
