Minghu00/fpga-voice-synth/显示方案_RGB.md

# 显示方案 —— 480×272 RGB 屏画什么、延迟多少

> 配套：`交互方案_TTP229.md`（触摸与合成器）、`赛题方案.md`（总体）、`constraints/pinmap_v2.cst`（管脚）。

---

## 0. 直接回答

**画什么**：一块屏分四区 —— ① 实时波形示波器 ② 李萨如图 ③ 16 根声部能量柱 ④ 状态行。
前三个正是赛题拓展③点名的「波形显示 / 李萨如图形 / 实时频谱」，第四区放声部数和延迟计数。

**延迟多少**：显示端 **最坏 16.7 ms（1 帧），平均 8.3 ms**；
触摸高亮因为要等 TTP229，最坏 **48.7 ms**。
**但这与音频延迟完全无关** —— 显示和音频是两条独立通路，共用一个时钟但互不阻塞。

---

## 1. 屏幕参数（已确认）

| 项目 | 值 | 来源 |
|---|---|---|
| 分辨率 | 480 × 272 | 你的屏 |
| 像素时钟 | **9.000 MHz**（sys_clk 108MHz ÷ 12） | 官方 `video_pll.v` |
| 行时序 | H_ACTIVE 480 + FP 2 + SYNC 41 + BP 2 = **525** | 官方 `vga_timing.v` |
| 场时序 | V_ACTIVE 272 + FP 2 + SYNC 10 + BP 2 = **286** | 同上 |
| 帧率 | 9e6 / (525×286) = **59.94 Hz** | 计算 |
| 帧周期 | **16.683 ms** | 计算 |
| 行周期 | 58.333 µs | 计算 |
| 色深 | RGB565（R 5bit / G 6bit / B 5bit = 65536 色） | Dock J7 只引出 5/6/5 |
| 有效显示时间 | 14.507 ms / 帧 | 计算 |

---

## 2. 屏幕布局

```
 (0,0)                                                          (479,0)
   ┌───────────────────────────────────────────────────────────────┐
   │  ① 实时波形示波器      480 × 120                                │  y 0..119
   │     最近 480 个音频采样，上下居中，零线打到 y=60                 │
   │     峰值 0xFFF/0x000 → y 0 / 119，自动增益 3 档                  │
   ├───────────────┬───────────────────────────────────────────────┤
   │ ② 李萨如      │  ③ 16 根声部能量柱                              │  y 120..255
   │   136 × 136   │     16 柱 × 21 px = 336 px                      │
   │   x 0..135    │     x 136..471                                  │
   │               │     柱高 = 该声部包络（或 Goertzel 能量）         │
   ├───────────────┴───────────────────────────────────────────────┤
   │ ④ 状态行  480 × 16：声部数 / 音色名 / 延迟计数（5×7 点阵字体）    │  y 256..271
   └───────────────────────────────────────────────────────────────┘
   边界 x 472..479 留 8px 分隔线
```

配色（RGB565）

| 元素 | 颜色 | 说明 |
|---|---|---|
| 背景 | `0x0000` 黑 | 省电、对比度高 |
| 波形 | `0x07E0` 绿 | 示波器经典色 |
| 能量柱 | 低 `0x001F` 蓝 → 高 `0xF800` 红 | 高度映射色阶，一眼看出强弱 |
| 李萨如轨迹 | `0xFFE0` 黄 | 在高对比度背景上最清晰 |
| 状态字 | `0xFFFF` 白 | |
| 按键高亮 | `0x07FF` 青 | 按下的声部柱加边框 |

---

## 3. 四个区的内容

### ① 实时波形示波器（最便宜、最诚实）

- **数据来源**：`mixer` 输出的 16bit 有符号样本，按 fs=48 214 Hz 连续写入一块 512×16bit 双口 BSRAM 环形缓冲。
- **绘制**：屏幕扫到第 x 像素时，读缓冲区第 `(wr_ptr - 480 + x)` 个样本，映射成 y。
  纯查表比较，**不需要帧缓存，不需要画线算法**。
- **显示时长**：480 点 ÷ 48 214 Hz = **9.96 ms** 的音频，肉眼刚好看到几个周期。

> 这一格是**真实测量值**，不是估算，最经得起追问。

### ② 李萨如图（次便宜）

严格说是「相图」：把当前样本和**延迟 N 个样本**的值当成 X/Y 画点，正弦输入下必然形成闭合轨迹，
频率变化时轨迹形状随之改变 —— 视觉上就是李萨如图。

- **X** = `sample[n]`，映射到 136 宽
- **Y** = `sample[n-N]`（N 取 12，约 1/4 周期 @1kHz），映射到 136 高
- **绘制**：把最近 200 个 (x,y) 点存进一块小 RAM。扫描到当前像素 (px,py) 时，
  遍历 200 个点比较是否命中 → 命中点亮。

> 200 次比较 @9MHz = 可在 1 个像素周期内完成（9MHz 周期 111ns，200 次比较约 400 LUT 组合逻辑，
> 需要拆成流水线或降到 64 点）。**建议先用 64 点**。

### ③ 16 根声部能量柱（两档做法，建议先做 A）

#### 方案 A（第一版）：声部包络柱 —— 1 天，约 350 LUT

柱高 = 第 i 声部 ADSR 包络值。**按了哪个键、哪个键响得多，一眼可见**，
而且和合成器共用同一个信号，零额外计算。

诚实命名：这是**包络指示器**，不是频谱。演示时就说"每根柱对应一个声部的实时包络"。

#### 方案 B（第二版）：16 点 Goertzel 真频谱 —— 3 天，约 600 LUT + 2 DSP

**实测验证过：不分频直接算 Goertzel 行不通。**
因为音高 261~523 Hz 相对 48 214 Hz 采样率太低，系数 c = 2cos(2πf/fs) 全都 ≈ 2：

| 音 | c 值 | Q14 编码 |
|---|---|---|
| C4 | 1.998838 | 16374 |
| C5 | 1.995352 | 16346 |

**16 个 bin 的编码只差 10~38 LSB**，16bit 定点分辨不出来。

**必须先在时间上抽取（decimate）再算**。方案：16 点滑动平均当低通，抽取 16 倍 → fs' = 3 013.39 Hz：

| 音 | c 值 | Q14 编码 | 量化误差 |
|---|---|---|---|
| C4 | 1.709724 | `0x36B6` | 0.028 Hz |
| E4 | 1.545921 | `0x3178` | 0.023 Hz |
| G4 | 1.368321 | `0x2BC9` | 0.020 Hz |
| C5 | 0.923155 | `0x1D8A` | 0.016 Hz |

系数分得很开，**精度完全够**。

**算力**：16 bin × 3 013 抽取样本/秒 = 48 214 MAC/s，在 108 MHz 上占 **0.4%**，
用一个时分复用乘法器绰绰有余。

**收益**：每根柱对应一个音名，**能真实量出"现在响了哪几个音"** —— 这才是赛题说的「实时频谱」。

> **建议**：第一版做方案 A 把整条显示通路跑通（S8 步），
> 方案 B 作为加分项后补。这样即使时间不够，屏幕也是完整可用的。

### ④ 状态行（5×7 点阵，只做数字 + 12 个字母）

显示三组信息，格式例如：

```
VOICES 05   INST SAW   LAT 0210us
```

- `VOICES` = 当前 `key_raw` 的 popcount
- `INST` = 当前音色（ORG/SQR/SAW/TRI）
- `LAT` = 从按键上升沿到 I2S 帧开始的计数值

> ⚠️ **关于 LAT 这一格要特别注意**：如果显示"端到端延迟"，
> 必须标明测的是**哪条通道**（机械键通道 ≈0.9~2.7ms，触摸通道 ≈32ms），
> 否则容易引起误解。**建议这一格只显示机械键通道的延迟**，并在演示时口头说明触摸通道的差异。

字库只需 10 个数字 + 约 12 个大写字母 = 22 个 5×7 字形，
ROM 22×8bit，用 case 硬编码即可，**不到 100 LUT**。

---

## 4. 延迟（这是你问的重点）

### 4.1 显示通路的延迟

| 显示内容 | 数据多久更新一次 | 到屏幕最坏延迟 | 平均值 |
|---|---|---|---|
| ① 波形 | 每采样 20.74 µs | **16.68 ms**（1 帧） | 8.34 ms |
| ② 李萨如 | 每采样 20.74 µs | **16.68 ms** | 8.34 ms |
| ③ 能量柱 / 频谱 | 每采样 20.74 µs | **16.68 ms** | 8.34 ms |
| ④ 数字状态 | 每帧 | 16.68 ms | 8.34 ms |
| 触摸按键高亮 | 32 ms（TTP229 扫描周期） | **48.7 ms** | ~24 ms |

**为什么最坏是 1 帧**：图形值变化后，必须等扫描线扫过受影响的那一行才会显示出来。
最坏情况是值刚变完、扫描线刚好扫过 —— 再等一整帧。

**为什么平均是一半**：值变化时刻相对扫描线位置是随机的，平均半个帧。

### 4.2 这个延迟要不要紧

**完全不要紧，理由有三条**：

1. **不在赛题考核范围内**。赛题基础②的原文是「**控制信号到音频输出**的总延迟」，
   显示是输出侧的可视化，不是音频通路。
2. **物理上不共享资源**。波形/柱状图只是"读一个寄存器去决定像素颜色"，
   音频链路的 2240 clk/帧节奏一个时钟都不会被拖慢。
3. **59.94 Hz 本身就是人眼的观感上限**。16.7 ms 的刷新延迟，
   比手指触摸 TTP229 的 32 ms 还要小一半，人根本感知不到显示"慢"。

### 4.3 如果想更快（可选优化）

| 优化 | 效果 | 代价 |
|---|---|---|
| 把波形区改成 2 个小缓冲区乒乓切换 | 消除撕裂，不减延迟 | +1 BSRAM |
| 按行局部刷新（只重画变化的柱子） | 最坏降到 1 行 = 58 µs | 逻辑复杂，不划算 |
| **不做** | —— | —— |

> **结论：16.68 ms 就是设计值，不用优化。** 真正需要关注的是音频通路那 0.9~2.7 ms。

### 4.4 完整延迟对照表（全系统）

| 通路 | 最坏延迟 | 赛题要求 | 是否达标 |
|---|---|---|---|
| **机械键 → 音频**（基础②/拓展③ 实测通道） | **2.7 ms**（消抖 2ms）<br>**0.9 ms**（消抖 1ms） | ≤10ms / ≤5ms | ✅ 余量 3~11 倍 |
| **TTP229 → 音频**（演奏通道） | 32 ms + 0.9 ms ≈ **33 ms** | 不计（传感器内部） | 需口头说明 |
| **任意 → 屏幕** | **16.7 ms** | 无要求 | —— |
| **TTP229 → 屏幕高亮** | **48.7 ms** | 无要求 | —— |

---

## 5. 资源估算

| 模块 | LUT | FF | BSRAM | DSP |
|---|---|---|---|---|
| lcd_timing（时序发生） | 100 | 40 | 0 | 0 |
| 波形缓冲 512×16 + 读逻辑 | 80 | 30 | **1** | 0 |
| 波形绘制（映射 + 比较） | 150 | 20 | 0 | 0 |
| 16 柱绘制（方案 A） | 350 | 220 | 0 | 0 |
| *（方案 B Goertzel 增量）* | *+250* | *+200* | *0* | *+2* |
| 李萨如 64 点 buffer + 绘制 | 300 | 120 | 0 | 0 |
| 5×7 字库 + 状态行 | 100 | 40 | 0 | 0 |
| **小计（方案 A）** | **~1080 / 20736（5%）** | **~470** | **1 / 46** | **0** |
| **小计（含方案 B）** | **~1330 / 20736（6%）** | **~670** | **1 / 46** | **2 / 24** |

> 加上合成器部分（约 7100 LUT）和 FX（约 600 LUT），总计约 **9000 LUT / 20736 = 43%**，
> **余量充足**。屏幕上这些图形逻辑一点都不贵。

---

## 6. 实施顺序

| 步 | 内容 | 验证 |
|---|---|---|
| **D0** | `lcd_timing` 出 9MHz 像素 + HS/VS/DE，先画纯色横条 | 屏幕出彩条，不闪不滚 |
| **D1** | 波形缓冲 + 示波器 | 摸键看波形跳动 |
| **D2** | 16 柱包络（方案 A） | 按几个键看对应柱升起 |
| **D3** | 李萨如 64 点 | 出闭合曲线 |
| **D4** | 5×7 字库 + 状态行 | 显示声部数/音色/延迟 |
| **D5** | （可选）Goertzel 真频谱 | 频谱仪上与屏幕对照 |

---

## 7. 一句话总结

屏幕画四块：**波形（真实采样）+ 李萨如（相位图）+ 16 根声部柱（先做包络，后升级真频谱）+ 状态行**。

显示延迟 **16.7 ms / 帧（59.94 Hz）**，触摸高亮 48.7 ms，
**但显示和音频完全独立，不影响赛题要求的 0.9~2.7 ms 音频延迟**。
显示部分总成本只有约 1100 LUT + 1 块 BSRAM。
