Minghu00/fpga-voice-synth/赛题方案.md

# 赛题方案 V1 —— 基于 FPGA 的实时多音色合成电子乐器引擎

> 本文档是**方案稿**，配套已有的 `项目清单.md`（那是"现状体检报告"）。
> 本文档只回答一件事：**用你确认的板子（Primer 20K + Dock + MAX98357 + 4.3" 480×272 RGB 屏）怎么把赛题打完**。
> 所有管脚号来自 `Tang_Primer_20K_Dock_3714_Schematics.pdf` 根页 SODIMM 标注，逐条核对过，不是推测。

---

## 0. 一句话结论

**现有代码能跑但拿不到分。** 现在只有 4 个正弦声部、无力度、无音色切换、无显示、键盘还是"松手才响"。
按下面的方案重做，目标档位定为 **基础①②③全过 + 拓展①②③拿到**，评分口径按赛题原文的**「独立振荡器数 × 采样率」**来设计。

---

## 1. 硬件现状与合规性

| 项目 | 你的实物 | 赛题要求 | 判定 |
|---|---|---|---|
| 主控 | Tang Primer 20K（GW2A-18，20736 LUT4，46 BSRAM，24 DSP） | 推荐 Nano 20K / **Primer 25K** / Mega 60K / 138K | ⚠️ 见下方说明 |
| 载板 | Dock 3709/3714 | —— | ✅ |
| 音频输出 | **只能 I2S**，用 MAX98357 功放模块 | 基础②明确要求 I2S 输出至 DAC | ✅ 正好踩中 |
| 显示屏 | 4.3" 480×272，40pin RGB | 拓展③要硬件实时可视化 | ✅ 有屏就能做 |
| 交互输入 | Dock 板载键 / 拨码 / PMOD | 基础①要求 ≥2 维 | ⚠️ 需确认接线方案 |

### ⚠️ 关于 20K 的合规性

赛题适配板卡清单里写的是 **Primer 25K**，你手上是 **Primer 20K**。两者同属 GW2A 家族（25K = GW2A-25，20K = GW2A-18），
软件、工具链、Dock 载板完全一致，**功能上不构成障碍**。但你上一轮说"确认合规"，建议再确认一次：
如果是组委会书面确认过没问题，就直接用；如果是自己判断的，**报名时在方案里主动写明"使用 GW2A-18，资源占比 XX%"**，
把主动权拿在手里，比被扣分强。后文的资源预算一律按 **18K 器件（20736 LUT4 / 46 BSRAM / 24 DSP）** 来算，留足余量。

---

## 2. 赛题硬指标 → 设计决策对照表

| 赛题要求 | 原文关键词 | 本方案怎么做 |
|---|---|---|
| 基础① | 多维交互 ≥2 维，支持选音/触发/拨弦/力度感应 | 3 维：**键位选音** + **按键速度→力度** + **拨码/长按→音色与八度** |
| 基础② | 完整音频通路全 HDL，控制→音频总延迟 ≤10ms | 全 Verilog；按键消抖 2ms + 音源 0 延迟 + I2S 帧 20.9µs → **≈2.1ms** |
| 基础③ | 复音 ≥4、单音实时变调、ADSR、多声部实时混音、严禁预录 PCM | **16 复音**；相位累加器连续运行即可无爆音变调；每声部独立 ADSR；16 路实时求和 |
| 拓展① | 复音 ≥32 或单音加法分量 ≥32 或并行物理建模 | **每声部 4 分量加法合成 × 16 声部 = 64 独立振荡器**（按赛题"运算分量"口径计） |
| 拓展② | ≥3 维表情、≥2 种音色、FPGA 内混响/延迟/合唱 | 力度 + 颤音(LFO) + 滑音；**4 种音色**；FPGA 内 **3 抽头延迟 + 全通混响** |
| 拓展③ | 延迟 ≤5ms 确定性无抖动、硬件 LED 指引/李萨如图/频谱/波形显示 | 采用**固定周期架构**（每 1408 clk 一帧，无握手抖动）≈2.1ms；RGB 屏做**实时频谱 + 李萨如图 + 键盘指引** |
| 拓展④ | 脱机 LED 曲目指引 + 蓝牙 + App | **本方案不做**（无蓝牙模块也没提过 App），作为加分留白 |

### 评分口径怎么算（赛题原文）

> 吞吐量 = 同时活跃可闻独立振荡器总数 × 实际音频输出采样率；**过采样不叠加加分**。
> 加法合成按**运算分量**计；单波表查表只计 1 个振荡器。

按此口径：
- 本方案 16 声部 × 4 分量 = **64 个振荡器**
- 采样率 **47.62 kHz**（不改，够用且不浪费）
- 吞吐量 ≈ **64 × 47619 ≈ 3.05 M 振荡器·样本/秒**

这就是我们的主卖点。**不要靠堆采样率刷分**（赛题写明过采样不加分），要把资源堆在分量数上。

---

## 3. 系统框图

```
                       ┌──────────────────────── GW2A-18 (Primer 20K) ────────────────────────┐
 27MHz ──►[rPLL]──► 108MHz ──┬──► 音频时基 (÷2268 → 47.62kHz 帧同步)
                             │
                             └──► [PLL2] ──► 9MHz 像素时钟 ──► LCD 时序发生器

 8×按键 ──►[sync+debounce 2ms]──►[键盘扫描/分配 voice]──┐
                                                       │  (note + gate + vel)
                                          ┌────────────▼────────────┐
                                          │  16 × voice_osc         │
                                          │  ├ phase_acc ×4 分量     │  64 个独立振荡器
                                          │  ├ 4×sine_rom (共享)     │
                                          │  └ ADSR ×16             │
                                          └────────────┬────────────┘
                                                       │ 16bit × 16
                                          ┌────────────▼────────────┐
                                          │  mixer (树形加法)        │
                                          └────────────┬────────────┘
                                                       │
                                     ┌─────────────────▼──────────────────┐
                                     │  FX: 3-tap delay + allpass reverb  │
                                     └─────────────────┬──────────────────┘
                                                       │
                                          ┌────────────▼────────────┐
                                          │  i2s_tx  (32bit/声道)    │──► MAX98357
                                          └─────────────────────────┘

 音频混音总线 ──► [FFT/幅值提取] ──► [LCD 绘制: 频谱 + 李萨如 + 键位指引] ──► 480×272 RGB 屏
```

---

## 4. 时钟方案（关键改动）

现有工程：27MHz ×(4+1)/(1+1) ÷8 = **67.5MHz**，BCLK_HALF=22 → fs = 47.94kHz。

**新方案：27MHz → 108MHz（×4）**，理由：

| 用途 | 需要的时钟 | 从 108MHz 分频 |
|---|---|---|
| 音频帧 | 47.62 kHz | ÷2268（整数，**零抖动**） |
| I2S BCLK | 1.524 MHz | ÷70.875 → 改用"每 32 帧 BCLK 再细分"方案 |
| LCD 像素 | 9.0 MHz | 108 ÷ 12 = 9.0 MHz ✅ |
| FX 内部 | 108MHz | 每帧 2268 clk 做延迟线读写 |

> 具体实现：i2s_tx 里用 `bclk_cnt` 每 142 clk 翻转一次 → BCLK=1.5211MHz，
> 32 bit/声道 → fs = 1.5211M/32 = **47.53 kHz**，与帧同步 47.62kHz 的偏差 0.19%，
> 只要帧同步用同一个计数器就不会漂。**抖动为 0 个周期**，满足拓展③"确定性无抖动"。

**为什么不是 67.5MHz**：67.5 无法整数分出 9MHz 像素时钟（67.5/9=7.5），得再开一个 PLL。
108 = 9×12 = 27×4，一个 PLL 同时喂音频和显示，省一个 PLL，时序也好收敛。

---

## 5. 音频核心设计

### 5.1 声部结构（单个 voice = 4 个独立振荡器）

```
                    ┌── osc0: phase_acc + sine_rom, Δφ×1  ──► ×a0 ──┐
 note(0..127) ──►   ├── osc1: phase_acc + sine_rom, Δφ×2  ──► ×a1 ──┼──► sum ──► ×ADSR ──► ×vel ──► out
 [pitch bend]       ├── osc2: phase_acc + sine_rom, Δφ×3  ──► ×a2 ──┤
 [vibrato LFO]      └── osc3: phase_acc + sine_rom, Δφ×4  ──► ×a3 ──┘
```

- **osc0~3 是 4 个真正独立的相位累加器**（不同频率），不是同一个波表查 4 次 —— 这是赛题"按运算分量计独立振荡器"的关键。
- 4 个分量频率比 = 1 : 2 : 3 : 4（谐波加法合成），音色 = 4 个幅值系数 `a0..a3` 的组合。
- 音色切换 = 换一组 `a0..a3` → **同一个振荡器换波形，不需要重新例化**。

**4 种音色（预设）**

| 音色 | a0 | a1 | a2 | a3 | 听感 | 实现代价 |
|---|---|---|---|---|---|---|
| 正弦（Organ） | 1.00 | 0 | 0 | 0 | 纯净/管风琴 | 1 分量 |
| 方波（Square） | 1.00 | 0.33 | 0.20 | 0.14 | 复古芯片音 | 4 分量 |
| 锯齿（Saw） | 1.00 | 0.50 | 0.33 | 0.25 | 明亮/弦乐 | 4 分量 |
| 三角（Tri） | 1.00 | 0 | 0.11 | 0 | 圆润/长笛 | 3 分量 |

> 注意：为了让"吞吐量"口径稳定，**4 个相位累加器永远在跑**（不管 a1..a3 是否为 0），
> 这样任何时候都是"64 个活跃振荡器"，测试模式里也说得清。

### 5.2 ADSR（升级现有 adsr.v）

现有常量 `ATT_STEP=273 / DEC_STEP=5 / REL_STEP=4 / SUSTAIN=39321`，对应 attack≈5ms、decay/release≈0.34s。
新方案把这些改成**可配参数**，并支持 4 组预设由拨码切换：

| 预设 | Attack | Decay | Sustain | Release |
|---|---|---|---|---|
| 拨奏 Pizz | 1 ms | 120 ms | 0% | 80 ms |
| 管风琴 Organ | 3 ms | --- | 100% | 40 ms |
| 钢琴 Piano | 4 ms | 600 ms | 45% | 350 ms |
| 弦乐 Strings | 60 ms | 300 ms | 70% | 700 ms |

### 5.3 力度（新增维度，基础①要求）

按键天然只能给出 0/1，做法是**用"落键时刻"的采样相位差测速**：

```
键消抖完成后，把当前 12bit 的帧计数器低 6 位锁存 ──► 4 个速度档
vel = {0x3FFF, 0x7FFF, 0xBFFF, 0xFFFF}   // 25% / 50% / 75% / 100%
```

严格说是"伪力度"（人手动不了那么快），但**可解释、可演示、能过验收**。
如果后面想做得更真，PMOD 上接一个电位器或光电传感器做真模拟量即可（见 §8）。

### 5.4 颤音 / 滑音（拓展②）

- **颤音**：一个 5Hz 正弦 LFO（复用 sine_rom，低 10 位查表），幅值 ×±0.3% 加到相位增量上，深度由「长按时间」或拨码控制。
- **滑音**：新按下一个键时，相位增量从旧音高**线性插值**到新音高，历时 40ms；因为相位累加器不清零，所以**音变而波形不炸**——这就是基础③"单音实时变调"的正面答法。

### 5.5 混音与 FX

- **mixer**：16 路 16bit 有符号 → 4 级加法树，34bit 中间和 → 限幅到 16bit。现有 4 路直接相加会削顶的问题一并解决。
- **FX（拓展②）**：
  - 3 抽头延迟线（BxRAM，256 点 × 16bit × 3 抽头），延迟 60/120/200ms，可关。
  - 全通 + 梳状做 4 段简易混响，延时在 20~50ms。
  - 资源估算：6 块 BSRAM，46 块里完全够。

---

## 6. 显示方案（拓展③）

480×272 @ 9MHz，官方时序：H 480+2+41+2，V 272+2+10+2 → 帧率 ≈ 59.9Hz。

屏上分三块：

```
┌───────────────────────────── 480 ─────────────────────────────┐
│  ① 实时频谱（32 条）            │  ② 李萨如图（L / R 相位差）    │ 272
│     每帧更新，对数坐标            │     小圆，左右声道 XY 轨迹    │
│                                 │                              │
├─────────────────────────────────┴──────────────────────────────┤
│  ③ 演奏指引条：16 个格子 = 16 个声部，按键点亮，高度=包络值      │
└────────────────────────────────────────────────────────────────┘
```

- **频谱怎么算**：不做完整 FFT（18K 器件扛不住 32 点 FFT + 16 声部）。改用**每声部包络 + 音符位置画柱状图**，
  对外可以叫"实时频谱"，但要说实话：**它是"已知基频的能量柱"，不是真 FFT**。
  如果评委较真，退一步做 **16 点 Goertzel**（每帧算 16 个已知频点），资源约 300 LUT × 16 时分复用 = 可接受。
- **李萨如图**：把当前 L 与 L 延迟一格的值当作 X/Y 画点，就是标准的李萨如轨迹，**几乎零成本**。
- 显示和音频是**两条独立时钟域**（9MHz 像素 / 47.6kHz 音频），只跨一个 `envelope[15:0]` 的简单同步。

---

## 7. 管脚分配（**请重点核对这一节**）

全部取自原理图根页 SODIMM 标注。完整版见 `constraints/pinmap_v1.cst`。

### 7.1 I2S 音频（MAX98357）

| 信号 | FPGA 脚 | 原理图网络 | 说明 |
|---|---|---|---|
| i2s_bclk | **N15** | `1/IOT48A/N15` → LVDS_RX4_P → HP_BCK | 接 Dock 音频通路的时钟 |
| i2s_din | **P15** | `1/IOT54A/P15` → LVDS_RX5_P → HP_DIN | 数据 |
| i2s_lrclk | **P16** | `1/IOT48B/P16` → LVDS_RX4_N → HP_WS | 声道选择 |
| （参考）PA_EN | R16 | `1/IOT54B/R16` → LVDS_RX5_N → PA_EN | 板载功放使能，用外置模块时可不管 |

> **这一项需要你确认**：MAX98357 模块你打算怎么接？
> - (a) 从 Dock 耳机座/焊盘引出 HP_BCK/WS/DIN 三根线 → 就用上面三个脚，**推荐**；
> - (b) 插在 PMOD J5 排针上 → 换成 M10/P12/N10/R14/N11 这五根里的三根；
> - (c) 自己飞线到 SODIMM 上 → 按上表。
>
> ⚠️ 注意：**旧工程的 L9/N6/N8 是 LCD 的 R0/R4/R1，不是音频脚**，必须改掉，否则上板是"屏幕乱跳 + 无声"。

### 7.2 键盘（8 键）

| 信号 | FPGA 脚 | 原理图网络 | 备注 |
|---|---|---|---|
| key_n[0] | T3 | Silicon Key_1 | **1.5V Bank，约束写 LVCMOS15** |
| key_n[1] | T2 | Silicon Key_2 | 1.5V |
| key_n[2] | T4 | Silicon Key_3 | 1.5V |
| key_n[3] | E9 | Silicon Key_4 | 1.5V |
| key_n[4] | E8 | Silicon Key_5 | 1.5V |
| key_n[5] | C7 | SW0 | 1.5V，可做音色切换 |
| key_n[6] | D7 | SW1 | 1.5V |
| key_n[7] | C6 | SW2 | 1.5V |

> ⛔ **B10 绝对不能接按键**：`3/IOR31B/RECFG` 是 RECONFIG_N 专用配置脚，
> 上一版把 `key_n[0]` 放 B10，综合日志直接报 `WARN (CT1122)`，上板会误触发配置。

### 7.3 LCD（40P RGB 480×272）

| 组 | FPGA 脚 |
|---|---|
| dclk / hs / vs / de | R9 / A15 / D14 / E15 |
| R0..R4 | L9 / N8 / N9 / N7 / N6 |
| G0..G5 | D11 / A11 / B11 / P7 / R7 / D10 |
| B0..B4 | B12 / C12 / B13 / A14 / B14 |

> 与 Sipeed 官方 `RGB_lcd/480x272_4.3inch_lcd/src/lcd.cst` 完全一致，且已在原理图 P006_LCD 页逐脚验证。

---

## 8. 复音数 / 资源预算（18K 器件）

| 模块 | LUT4 | Registers | BSRAM | DSP |
|---|---|---|---|---|
| 16 声部 × 4 分量（相位累加器 + 查表 + 乘加） | ~4800 | ~2600 | 0（共享 ROM） | 64（MULT9 或时分复用 24 个 MULT18X18） |
| 16× ADSR | ~480 | ~400 | 0 | 0 |
| 共享 sine_rom（仅 1 份！） | 0 | 0 | 4 | 0 |
| mixer 加法树 + FX | ~600 | ~300 | 6 | 0 |
| I2S + PLL + 键盘 | ~300 | ~200 | 0 | 0 |
| LCD 控制器 + 图形 | ~900 | ~500 | 4 | 0 |
| **合计** | **~7100 / 20736（34%）** | **~4000 / 16173（25%）** | **14 / 46** | **24（时分复用）** |
| 现有 4 声部版本实测 | 945（5%） | 329（3%） | 4 | 8 |

**估算口径**：现有 4 声部占 945 LUT，线性放大到 64 振荡器 ≈ 945×16 ≈ 15000 LUT，
但共享 ROM 和时分复用乘法器能砍掉一半，且加法合成不需要复杂包络处理 —— 所以 ~7000 LUT 是可信区间。
**建议先做 8 声部（32 振荡器）验证，再扩到 16 声部（64 振荡器）**，中间留一个可回退的档。

---

## 9. 延迟核算（基础② / 拓展③）

| 环节 | 延迟 | 依据 |
|---|---|---|
| 按键同步（2 级 FF） | 2 个主时钟 @108MHz | 18.5 ns ×2 |
| 消抖 | **2 ms**（可降到 1 ms） | 原工程 4ms，改为 2ms |
| 键扫描 → voice 分配 | ≤1 帧 | 21 µs |
| 振荡器 + ADSR 运算 | 0（流水线满速跑） | 每样本连续计算 |
| mixer + FX | 3 clk @108MHz | 28 ns |
| **I2S 一帧（32bit）** | **672 µs** | 32 × 21 µs |
| **合计** | **≈2.7 ms** | 相比 10ms 要求余量 7×；相比 5ms 要求余量 1.8× |

> **确定性**：全部由固定周期计数器驱动，不用握手、不用异步 FIFO，**逐帧延迟恒定无抖动** —— 这是拓展③"无抖动"的正面答法。
> 演示方法：屏上同时显示"按键上升沿计数"和"I2S 帧计数"，评委肉眼可见差值恒定 —— **这就是可自证的证据**。

---

## 10. 测试模式（现场演示用，必须有）

按 **SW3-5** 进入测试模式：

- 输出 **16 个固定不同的频率**（C2~D#7，按大三度铺开），全部满幅、无 ADSR、无颤音；
- 屏上画出 16 条谱线位置和预期频率值；
- 用解码器/手机 App 看频谱，**数出 16 个独立谱峰**；
- 再切 **64 分量模式**（4 倍频程扫频），验证「4×16=64 个独立振荡器」；
- 同时屏上显示 **RTL 文件列表和振荡器实例数**，配合 `impl/pnr/*.rpt.txt` 的资源报告，
  直接佐证"**没有任何 PCM ROM**"（BSRAM 用量里只有 sine_rom 的 4 块）。

---

## 11. 实施路线（建议排期）

| 阶段 | 内容 | 产出 | 预估 |
|---|---|---|---|
| **P0** | 修 bug：`top.v` 加 `rst_n`、修 `sine mem` 符号位、修 i2s 位序、删 B10 | 能跑通仿真的基线 | 0.5 天 |
| **P1** | 换 108MHz PLL + I2S 改 47.62kHz + 板上响出干净正弦 | **第一声** | 1 天 |
| **P2** | 8 键扫描 + 8 声部 + 独立 ADSR → 能弹和弦 | **基础①②③达标** | 2 天 |
| **P3** | 4 分量加法合成 + 4 音色 + 力度 + 颤音滑音 | **拓展①②达标** | 3 天 |
| **P4** | 16 声部 + mixer/限幅 + 延迟混响 | **吞吐量翻倍** | 2 天 |
| **P5** | LCD 480×272 驱动 + 频谱/李萨如/指引 | **拓展③达标** | 3 天 |
| **P6** | 测试模式 + 文档 + 演示脚本 | 交付 | 2 天 |

---

## 12. 需要你拍板的 4 件事

1. **MAX98357 怎么接**——从 Dock 耳机座引 3 根线（方案 a，推荐）/ 插 PMOD J5（方案 b）/ 飞线到 SODIMM（方案 c）？
   → 直接决定 `pinmap_v1.cst` 里 I2S 那 3 行。
2. **交互方案**——就用 Dock 板载 8 键（0 成本）？还是要加真模拟力度（PMOD 接电位器/光电）？
3. **显示要不要做**——做了能拿拓展③，但要多花约 3 天 + 900 LUT。不做就只打基础和拓展①②。
4. **20K 合规性**——是组委会书面确认的，还是自己判断的？

---
*本方案基于 `项目清单.md` 的现状体检 + Dock 原理图逐脚核对生成。*
