Minghu00/fpga-voice-synth/docs/多波表证据.md

# 多波表证据（P3）—— 4 张独立波表，每张一个加法分量

> 对应赛题：**评分① 独立发声单元**（"单波表查表只计 1 个振荡器"）
> 本次里程碑：`docs/纯代码任务清单.md` 的 **P3**
> 位流：`impl_inst/pnr/inst.fs`

## 1. 一句话结论

以前 4 个加法分量**共享一张正弦表**，按 f / 2f / 3f / 4f 取同一张表的谐波——评委完全可以
说"你只有 1 张波表，所以是 1 个振荡器"。

现在组件 c **读它自己那张表**：

| 分量 | 波表 | 频率 |
|---|---|---|
| comp0 | `tab 0` 正弦 | 1 × f |
| comp1 | `tab 1` 三角 | 2 × f |
| comp2 | `tab 2` 锯齿 | 3 × f |
| comp3 | `tab 3` 方波 | 4 × f |

4 个独立相位累加器 + 4 张独立波表 + 4 个独立幅度 → **4 个真正独立的波表振荡器**，
不再有"单波表"这个说法上的漏洞。8 声部 × 4 分量 = **32 个独立波表振荡器**。

## 2. 怎么进 / 怎么退

**长按板载 Key_3（`vup_sw`，D7）约 0.79 秒**（38 000 个音频样本）。

| 操作 | 结果 |
|---|---|
| 短按 Key_3（< 0.79 s） | 音量 +1 档（与以前完全一样） |
| **长按 Key_3** | **波表模式开 / 关切换**（粘性，松手保持） |
| 断电重启 | 回到波表模式关闭（默认音色不变） |

**屏幕提示**：状态条 `x 192..215` 出现**橙色块** = 波表模式生效。
（`x 0..47` 八度梯 / `48..95` 音色梯 / `96..155` 音量梯 / `168..191` 红色 TEST / `192..215` 橙色 WAVE）

> 短按加音量、长按切模式的判断逻辑在 `rtl/input/keymap8.v`：计数器跑在 `en`
> （音频采样率 48 214.29 Hz）上，所以 0.79 s 与系统时钟无关。长按在按下沿会先
> 加一档音量，这是设计上的取舍——音量索引永远落在 6..10 的可闻区间，不会变哑。

## 3. 波表内容

文件：`rtl/audio/wav_bank_4096.mem`，**4096 行 × 16 bit 二进制补码有符号**，四段各 1024 行：

| 行号 | 波表 | 谐波数 |
|---|---|---|
| 0 – 1023 | 正弦 | 1 |
| 1024 – 2047 | 三角 | 8（奇次 1,3,5,7）|
| 2048 – 3071 | 锯齿 | 8（1..8 全次）|
| 3072 – 4095 | 方波 | 8（奇次 1,3,5,7）|

生成公式（`w = 2πi/1024`，归一化到峰值 32767 后取整）：

```
sin   sin(w)
tri   (8/π²)  · Σ_{k 奇, k≤8} (-1)^((k-1)/2) / k² · sin(kw)
saw   (2/π)   · Σ_{k≤8}      (-1)^(k+1)      / k  · sin(kw)
sq    (4/π)   · Σ_{k 奇, k≤8}                 1/k  · sin(kw)
```

**第 0 段与旧的 `sine_1024.mem` 逐行完全一致**（重新生成后 0 处不同），所以波表模式
关闭时四个原音色的声音**逐位不变**。

校验点（`sim/tb_wavetable.v` 实测）：

| 地址 | 正弦 | 三角 | 锯齿 | 方波 |
|---|---|---|---|---|
| 0 | `0000` | `0000` | `0000` | `0000` |
| 256 | `7FFF` | `7FFF` | `3757` | `639C` |
| 512 | `0000` | `0000` | `0000` | `0000` |
| 768 | `8001` | `8001` | `C8A9` | `9C64` |

## 4. 硬件实现

`rtl/audio/wavetable_bank.v`：**4 张表放进同一块 BSRAM**，

```verilog
reg [15:0] rom [0:4095];
$readmemh("rtl/audio/wav_bank_4096.mem", rom);
wire [11:0] addr_full = {tab_sel, addr};
always @(posedge clk) data <= rom[addr_full];
```

为什么要合成一块而不是 4 个 ROM 实例：**读延迟保持 1 个时钟、只有一个读端口**，
这样 `osc_bank.v` 的槽流水线一个周期都不用改（`rom_a` 在 sub1 赋值、`rom_d` 在 sub3
消费）。代价是 BSRAM 从 1 块变成 4 块。

`rtl/audio/osc_bank.v` 的新增部分：

```verilog
input  wire wave_mode,                          // 1 = 4 different wavetables
wire [1:0] tab_nx = wave_mode ? cidx : 2'd0;    // 分量 c 读表 c，或全读表 0
// sub1: tab_q <= tab_nx;  （与 rom_a 同时打拍，两者一起构成 BSRAM 地址）
wavetable_bank u_wav (.clk(clk), .tab_sel(tab_q), .addr(rom_a), .data(rom_d));
```

幅度：`wave_mode=1` 时用 `{8192, 8192, 8192, 8192}`（各 0.25），四个分量等响度、
和为 1.0，配合混音器的 `MIX_SHIFT=3` 仍有充足余量。

## 5. 验证数据

### `sim/tb_wavetable.v`（新增，全部通过）

```
PASS  all 4096 (tab,addr) points match the .mem file : 0
PASS  sine   @256 : 32767        PASS  saw    @256 : 14167
PASS  square @256 : 25500        PASS  sine   @768 : 32769
PASS  saw    @768 : 51369        PASS  square @768 : 40036
PASS  four tables are different waveforms, not four sines
PASS  read latency is exactly one clock
== tb_wavetable : ALL PASS ==
```

**4096 个点逐个与 `.mem` 文件比对，0 处不符** —— 证明 `{tab_sel, addr}` 的地址映射
真的把四个 1024 点表独立分开了，不是同一张表换个偏移。

### `sim/tb_osc_bank.v`（新增 2 项断言）

```
PASS  wave_mode=0 reads table 0 for every component
PASS  wave_mode=1 gives component c table c
```

采样点选在 `sub==3`（ROM 数据被消费的那一拍），并且只在 `fc < 1024` 的振荡器窗口内
采样——`fc ≥ 1024` 是帧尾的增量预计算段，槽流水线空闲、`tab_q` 保持上一个槽的值是正常的。

### `sim/tb_inst.v`（新增 5 项断言）

```
PASS  wavetable mode is off after reset
PASS  short Key_3 press does not change wavetable mode
PASS  short Key_3 press still steps the volume
PASS  long Key_3 press switches wavetable mode on
PASS  wavetable mode still shows a live waveform
PASS  second long press switches wavetable mode off
```

（TB 里把 `WHOLD` 参数降到 4 个样本来跑，生产值是 38 000。）

### 九个平台全绿

`scripts/run_all_sim.ps1` → `tb_i2s_tx / tb_audio_out / tb_adsr / tb_mixer16 /
tb_osc_bank / tb_wavetable / tb_ttp229_rx / tb_test_mode / tb_inst` 全部 ALL PASS。

## 6. 综合与时序

| 项目 | P0 后 | **P3 后** | 变化 |
|---|---|---|---|
| Logic | 2784/20736 (14%) | **2875/20736 (14%)** | +91 |
| — LUT / ALU / ROM16 | 2295 / 417 / 0 | **2386 / 417 / 0** | +91 LUT |
| — SSRAM(RAM16) | 12 | **12** | — |
| Register | 1259/16173 (8%) | **1282/16173 (8%)** | +23 |
| CLS | 1817/10368 (18%) | **1888/10368 (19%)** | +71 |
| I/O Port | 35/207 | **35/207** | **不变** |
| BSRAM | 4/46 (9%) | **7/46 (16%)** | **+3**（波表 1 块 → 4 块）|
| DSP | 6 × MULT18X18 (13%) | **3/24 (13%)** | — |
| rPLL | 1/4 | **1/4** | — |
| **Fmax** | 119.647 MHz | **124.043 MHz** | **+4.4 MHz** |
| 最差 setup slack | +0.901 ns | **+1.198 ns** | +0.30 ns |
| TNS (setup / hold) | 0 / 0 | **0 / 0** | — |
| 告警 | 0 | **0** | — |
| 位流 | 7,264,154 B | **7,264,154 B** | 大小相同 |

Fmax 反而提高了 4.4 MHz，因为波表换成了 BSRAM 同步读、替代原来贴得更紧的组合路径；
最差路径现在落在 LCD 的 `u_lcd/mult_64_s1/DOUT[16] → u_lcd/btop_q_4_s0/D`。

**35 个端口一个都没动**（`impl_inst/pnr/inst.rpt.txt` 逐项核对）：
`i2s_din T6`、`test_sw P6`、`vup_sw D7`、`key_btn T2`、`i2s_bclk R8`、`i2s_lrclk T7`、
`tp_scl P8`、`tp_sdo T8`、`lcd_dclk R9` 等全部保持 P0 的位置与电平标准。

## 7. 已知限制（照实说）

1. **波表带宽有限**：三张新表只取到 8 次谐波。常用音域（C4–C5、八度 0/1）最顶上的
   分量（×4）最高约 4.2 kHz，8 次谐波 33 kHz 已经在奈奎斯特（24 kHz）之外，会有
   轻微混叠；八度 2 时更明显。这不是"没做"，是刻意的资源/音质折中——把谐波数提到
   32 就能彻底无混叠，代价是 BSRAM 与选表逻辑都要重做，而听感提升对这几个音色很小。
2. **波表模式没有独立音色档**：它是在现有 4 个音色之上叠加的一个开关，而不是第 5 个
   音色。原因是要新增一个音色档就得再占一个 DIP 位（`sw5_vol` 已经在做音量 +1），
   会改动现有开关的语义。
3. **波表模式与锁存模式、测试模式可以叠加**：波表只改"读哪张表"，不改 `gate`，
   所以三种模式互不干扰。测试模式下强制 `timbre=0` 会覆盖波表模式的幅度
   （`amp_tab` 的 `wave_mode` 分支优先），这是有意的——测试模式必须干干净净的
   单分量正弦，谱峰才能逐个数。

## 8. 答辩口径

一句话：

> 32 个振荡器 = 8 声部 × 4 个加法分量。每个分量有独立的 32 位相位累加器、独立的
> 频率增量（f、2f、3f、4f）、独立的包络，并且在波表模式下**各自读一张独立的波表**
> （正弦 / 三角 / 锯齿 / 方波）。四张表的 4096 个采样点全部在 `tb_wavetable` 里
> 逐点核对过，`tb_osc_bank` 也断言了分量 c 读的就是表 c。

如果评委追问"32 个振荡器为什么频谱上数不出 32 根峰"：

> 因为它们是**按整数倍谐波**合成的加法分量（f、2f、3f、4f），谐波按定义必然与相邻
> 声部的基频重合，所以谱峰数永远少于分量数。要数振荡器请看两处：一是 RTL 里
> 32 个独立的 `reg [31:0] phase[0:31]` 和 `tb_osc_bank` 对每个分量增量的断言；
> 二是**现场测试模式**（上电按住 Key_3），它把 8 个声部锁在 8 个互不重叠的频率上、
> 只开 1 个分量，频谱上可以逐个数出 8 根 —— 详见 `docs/测试模式证据.md`。
