Minghu00/fpga-voice-synth/项目清单.md

# 项目清单（待核对）— 基于 FPGA 的实时多音色合成电子乐器引擎

> 生成时间：2026-10-01 之后的核对轮次。工作目录：`D:\Gowin\voice`
> 用途：让你逐项核对「我读了什么 / 赛题到底要求什么 / 现有工程做到哪一步 / 硬件能给你什么 / 还差什么」。

---

## 0. 一句话现状

赛题要求做「FPGA 纯硬件实时多音色合成电子乐器引擎」；本仓库已有一版 **4 复音、正弦波表、ADSR、I2S 输出** 的 Verilog 原型，已跑通综合+布局布线+码流，但**几乎没有实现赛题的加分项**（多音色、多维交互、效果器、可视化、≥32 复音、≤5ms 确定性延迟），也没有任何赛题文档/方案书。

---

## 1. 文件清单总览

### 1.1 赛题与板卡资料（4 个 PDF + 1 个交互式位号图）

| 文件 | 大小 | 内容 | 与赛题关系 |
|---|---|---|---|
| `基于FPGA的实时多音色合成电子乐器引擎.pdf` | 755 KB / 2 页 | **赛题正文**：设计要求 / 3 条基础要求 / 4 条拓展要求 / 3 条核心评分规则 / 适配板卡 | ★核心 |
| `Tang Primer 20K 规格书 V1.0.pdf` | 915 KB / 6 页 | GW2A-18 资源：20736 LUT4、15552 FF、41472 bit S-SRAM、828 Kbit B-SRAM、48 个 18×18 乘法器、4 个 PLL；板载 1Gbit DDR3、32 Mbit Flash、TF 卡座、SPI 屏座；5V±10%/0.5A；67.6×20.0 mm | ★芯片资源上限 |
| `Tang_Primer_20K_Dock_3714_Schematics.pdf` | 2.4 MB | Dock 底板原理图（文本层已提取） | ★★决定 IO 与音频链路 |
| `Tang_Primer_20K_Dock_3709-Assembly.pdf` | 98 KB | 装配图（无文字层，纯图形） | 次要 |
| `Tang_Primer_20K_Dock_3709_ibom.html` | 569 KB | Interactive BOM，含 312 个元件的位号/型号/坐标 | ★查具体器件与可焊接位置 |

### 1.2 RTL 源码（`rtl/`，11 个 .v + 1 个 .mem，共约 620 行）

| 文件 | 行数 | 作用 | 关键常量/实现 |
|---|---|---|---|
| `rtl/top.v` | 121 | 顶层：PLL→复位→按键→4 声部→混音→I2S | `VEL=16'hFFFF`、`CLK_FREQ=67_500_000`、`DEBOUNCE_MS=4`、`BCLK_HALF=22` |
| `rtl/synth_voice.v` | 54 | 单个声部：NoteLUT+相位累加+正弦查表+ADSR+音量乘法 | `vol32 = env*vel; audio = (wave*vol)>>16` |
| `rtl/adsr.v` | 78 | 5 态 ADSR 包络 | `ATT_STEP=273`、`DEC_STEP=5`、`REL_STEP=4`、`SUSTAIN=39321`（60%）、`MAX_ENV=65535` |
| `rtl/phase_acc.v` | 18 | 32-bit 相位累加器 | `phase <= phase + inc`（每采样一次） |
| `rtl/note_lut.v` | 17 | 4 个固定音高的相位增量 | 0x0165A690 / 0x01C29C8F / 0x0217DED7 / 0x02CB4D1F |
| `rtl/sine_rom.v` | 19 | 1024 点单周期正弦表（distributed/`$readmemh`） | `rom[phase[31:22]]` |
| `rtl/sine_1024.mem` | 1024 行 | 正弦波表数据 | 16 bit |
| `rtl/mixer.v` | 24 | 4 路求和 + 饱和限幅 | `sum = v0+v1+v2+v3`，±32767 饱和 |
| `rtl/i2s_tx.v` | 59 | I2S 发送器，主模式 | `BCLK_HALF=22`，32 bit/声道，`sample_en` 每帧一个脉冲 |
| `rtl/key_toggle.v` | 42 | 单键消抖 + **翻转锁存** | `CNT_MAX=(CLK_FREQ/1000)*DEBOUNCE_MS`，下降沿→`trig = ~trig` |
| `rtl/key_ctrl.v` | 29 | 4 路 key_toggle 例化 | `KEY_NUM=4` |
| `rtl/pll_audio.v` | 63 | 高云 rPLL IP | `FCLKIN=27MHz, IDIV=1, FBDIV=4, ODIV=8` → **67.5 MHz** |

### 1.3 仿真（`sim/`，6 个 testbench，无仿真工程/Makefile/CI）

| 文件 | 覆盖点 | 与顶层一致性 |
|---|---|---|
| `sim/tb_adsr.v` | idle→attack→decay→sustain→release→retrigger | 一致（67.5MHz） |
| `sim/tb_i2s_tx.v` | 帧周期 832 clk、半 BCLK 13 clk、左右声道 MSB-first、`sample_en` 计数 | 一致 |
| `sim/tb_key_ctrl.v` | 消抖、翻转锁存、抖动抑制 | 一致 |
| `sim/tb_synth_voice.v` | 4 个音高相位步进、门控后有输出 | 一致 |
| `sim/tb_top.v` | 按键→trig→发声音、触发→音频 <100 µs、四声部并发、I2S 有数据 | **不一致**：多驱动 `rst_n`（`top.v:4-11` 无 `rst_n` 端口，tb 却接 `.rst_n`）→ 顶层 TB 实际无法编译通过 |
| `sim/pll_audio_sim.v` | PLL 行为替代模型（74.07 MHz） | 供仿真用 |

### 1.4 工程与构建

| 文件 | 内容 |
|---|---|
| `poly_synth.gprj` | 高云工程：器件 `GW2A-18C / GW2A-LV18PG256C8/I7`，11 个 verilog + cst + sdc + mem |
| `tcl/build.tcl` | 4 行：open_project → top_module → gowinsynthesis → `run all` |
| `scripts/build.ps1` | 拷到 `%TEMP%\poly_synth_build` 构建，再把 `impl/` 拷回；`$GowinBin` 默认 `D:\Gowin\Gowin_V1.9.11.03_Education_x64\IDE\bin` |
| `constraints/tang_primer_20k.cst` | 8 个引脚约束（见 §3.2） |
| `constraints/poly_synth.sdc` | `create_clock clk27 37.037ns`；4 个 key 端 `set_false_path` |
| `.gitignore` | 忽略 `impl/`、`*.fs`、`*.bin`、`*.binx`、`*.tmp`、`/work/`、`*.gprj.user` |

### 1.5 构建产物（`impl/`，被 .gitignore 忽略）

| 文件 | 说明 |
|---|---|
| `impl/gwsynthesis/poly_synth.vg` | 综合后网表（318 KB） |
| `impl/gwsynthesis/poly_synth_syn.rpt.html` 等 | 综合报告/资源报告 |
| `impl/pnr/poly_synth.fs` | **7.09 MB 位流**（已生成，可直接烧板） |
| `impl/pnr/poly_synth.rpt.txt` | 资源占用：Logic 945/20736 (5%)、Register 329/16173 (3%)、BSRAM 4/46（pROM）、DSP 4/24（8 个 MULT18X18）、I/O 8 |
| `impl/pnr/poly_synth.timing_paths` | 最差 setup **0.578 ns**（19.091−18.513）；最差 hold **0.424 ns**（时钟周期约束 18.871 ns ≈ 53 MHz） |
| `impl/pnr/poly_synth.pin.html` / `power.html` | 引脚报告 / 功耗报告 |
| `impl/pnr/poly_synth.log` | **WARN CT1122**：`key_n[0]` 被约束到 RECONFIG_N 引脚 |
| `impl/gwsynthesis/poly_synth.log` | **WARN NL0002 ×9**：`note_lut` / `sine_rom` 被「swept in optimizing」（疑被优化掉，需查） |

---

## 2. 赛题内容摘录（逐条，供核对）

### 2.1 设计要求
基于 FPGA 的实时多音色合成电子乐器引擎；用**电容触摸 / 光电感应 / 压力检测 / 无接触手势等任意自研交互方案**实现**≥2 个独立可控演奏维度**；精准识别**选音、和弦、触发、拨弦**；FPGA 为并行计算平台，硬件逻辑层搭建实时音频合成引擎，可用**波表采样 / 加法合成 / FM 调频 / 物理建模**；逐样本、逐声部实时运算；**I2S 输出到 DAC**；高复音、多音色切换、多维表情；低延迟、高实时性、高表现力。

### 2.2 基础要求（必须过）
1. **多维交互控制检测**：自研演奏交互形态 + 传感器，支持选音/触发/拨弦/力度感应，**≥2 个独立可控维度**，交互灵敏稳定。
2. **FPGA 纯硬件实时音频合成**：完整音频生成通路全部 HDL 实现，逐样本实时运算；**控制信号到音频输出总延迟 ≤ 10 ms**。
3. **合规实时发声与多复音**：基础复音数 **≥4**，四路及以上独立声部并发；严格**禁止**直接播放预录 PCM、预置推流、整段录音触发；支持**单音实时变调、ADSR 包络、多声部实时混音**。

### 2.3 拓展要求（加分）
1. **超高规模并行**：复音数 **≥32**，或单音加法合成**分量 ≥32 路**，或多条并行物理建模单元。
2. **多维表情与效果**：**≥3 维**表情调控（力度动态、滑音、颤音等）；**≥2 种音色**自由切换；FPGA 内部实现**混响 / 延迟 / 合唱**等效果器。
3. **极致低延迟 + 视听反馈**：演奏延迟 **≤5 ms** 且**确定性无抖动**；硬件逻辑实时生成 **LED 演奏指引 / 李萨如图形 / 实时频谱 / 波形显示**。
4. **智能联动与脱机拓展**：**脱机 LED 曲目指引**；可搭**蓝牙模块 + 手机 App**，支持在线曲谱下载、键位自定义、录音回传。

### 2.4 核心评分规则（现场验证）
1. **振荡器统计**：独立发声单元 = 独立相位累加器 + 频率调控 + 包络控制的完整振荡器；单波表查表**不**计多谐波，只计 1 个振荡器；加法合成按**运算分量**、FM 按**调制运算器**、物理建模按**并行弦/模态单元**统计。
2. **吞吐量指标** = 「同时活跃可闻独立振荡器总数 × 实际音频输出采样率」，**过采样不叠加加分**。
3. **现场验证**：测试模式输出多路不同频率，频谱可见对应数量独立谱峰；RTL 代码佐证纯硬件实时通路；验证无预录播放。

### 2.5 适配板卡（官方列举）
Tang Nano 20K / **Primer 25K** / Mega 60K / 138K
> ⚠️ 与核对点有关：仓库用的是 **Primer 20K（GW2A-18）**，官方适配表里列的是 Primer **25K**。

---

## 3. 现有硬件环境（从原理图 + iBOM 实际读出）

### 3.1 开发板组合
- 核心板 Tang Primer 20K（GW2A-18，SODIMM 金手指）+ **Dock 底板（3709/3714）**。
- 底板资源：USB-C ×2、Barrel Jack DC-036A ×1、SODIMM DDR3 槽、FPC 40P/24P/10P/6P、2×6 排针 ×4（J12/J14/J5/J6）、1×3 排针 J16、WS2812 RGB、橙色 LED ×10、**硅胶按键 ×6**、**拨码开关 SW3（5 位）**、PT8211 DAC、3.5mm 音频孔、喇叭功放。

### 3.2 当前引脚约束（`constraints/tang_primer_20k.cst`）与实物核对

| 端口 | 约束引脚 | 原理图/排针上的实际含义 | 备注 |
|---|---|---|---|
| `clk27` | H11 | 27 MHz 时钟、Bank 0、GCLKT_0 | ✅ |
| `key_n[0]` | **B10** | 原理图标注 `B10_IOR31B_~{RECFG}` → **RECONFIG_N 配置引脚** | ❌ **高危**，P&R 已报 WARN CT1122 |
| `key_n[1]` | T3 | 原理图标注 `T3_IOB52B_1V5` | ⚠️ 1.5 V Bank（可能来自 J12/J14 排针；需实测电平） |
| `key_n[2]` | T2 | 原理图标注 `T2_IOB48B_1V5` | ⚠️ 同上 |
| `key_n[3]` | D7 | 原理图标注 `D7_IOL53B_1V5` | ⚠️ 同上 |
| `i2s_bclk` | L9 | Bank 3 / IOR40[B] | 需确认是否走到底板 PT8211 |
| `i2s_lrclk` | N6 | 原理图标注 `N6_IOR51A`，Bank 3 | 需确认 |
| `i2s_din` | N8 | Bank 3 / IOR40[A] | 需确认 |

### 3.3 底板音频与交互链路（原理图实测）
- **音频**：`HP_BCK / HP_WS / HP_DIN` → **U10 PT8211-S**（I2S DAC，3.3V）→ 两路 **LMV321（U11/U12）低通+耳机缓冲** → 3.5 mm `J10`；另一路 20K/100K/110K 电阻网络 + **U13 LPA4809MSF** 功放推喇叭。
- **交互**：`Key_0..Key_4` 一排 **6 个白色硅胶按键**（`S1~S4, SW0`）走 J14；`SW3` 是 **5 位拨码**（接 +1V5）；`SW1` 是 BL702 的 BOOT、`SW2` 是 USB/口选 SPDT。
- **指示灯**：`U17 WS2812B`（RGB，可用 `LED_DAT`）+ 10 个单色橙 LED（`Orange_LED0~5` 直连 FPGA，`LED6~9` 经 510R 到 +1V5）。
- **给 FPGA 引出的可用 GPIO**：J12 / J14（各 2×6 = 12 pin）、J16（1×3）、FPC J4/J7/J11/J15 等。
- **⚠️ 关键风险（我的判断，请核对）**：原理图里硅胶按键 `Key_0..4`、拨码 `SW3` 两侧的信号名是 `MIC_BCK / MIC_WS / MIC_DAT0~3 / MIC_LED_CLK / MIC_LED_DAT / Orange_LEDx / SW_0x` —— 这些是**FPGA 输出驱动型**信号；而 J12/J14 的 2×6 排针才是「外接按键」的入口。**当前 cst 把 key_n 接到 T2/T3/D7 这三个 1.5 V Bank 引脚，很可能不是 Dock 上的按键引脚**，需要在实物上点灯/测量验证。

### 3.4 当前芯片资源上限 vs 工程占用

| 资源 | 芯片总量 | 当前占用 | 余量 |
|---|---|---|---|
| LUT4 | 20736 | 756 LUT + 189 ALU = 945 (5%) | 充足 |
| 寄存器 | 15552 | 329 (3%) | 充足 |
| B-SRAM | 828 Kbit（46 块） | 4 块 pROM（5%，被识别为 pROM 而非 BSRAM） | 充足 |
| S-SRAM | 41472 bit | 0 | — |
| DSP 18×18 | 48 | 8 个 MULT18X18（4/24 DSP，17%） | 充足 |
| PLL | 4 | 1（67.5 MHz） | 3 个可用 |

---

## 4. 现有设计的技术参数（逐项算出来，供核对）

| 项目 | 当前数值 | 依据 |
|---|---|---|
| 音频主时钟 | **67.5 MHz** | 27 MHz，rPLL `IDIV=1(÷2)`、`FBDIV=4(×5)`、`ODIV=8(÷8)` → 27/2×5 = 67.5 MHz（pll_audio.v:40-46） |
| I2S BCLK | 67.5 MHz / (22×2) = **1.534 MHz** | `BCLK_HALF=22` 表示半周期 22 个系统时钟 |
| 采样率 fs | **47.94 kHz** | BCLK=1.534 MHz ÷ 32 bit/声道 = 47.94 kHz，一帧含左右声道 |
| 每帧系统时钟数 | 22×2×32 = **1408 clk** | 67.5e6/1408 = 47.94 kHz ✅（TB 里换 BCLK_HALF=13 时为 832 clk，两者不可互推） |
| 声部数 | **4** | top.v 实例化 4 个 synth_voice |
| 音色数 | **1**（正弦） | 仅 sine_rom |
| 音高范围 | **4 个固定音**，音高由 `note_idx` 硬编码 | note_lut.v 的 32-bit 相位增量 |
| 波形分辨率 | 1024 点 / 16 bit（**无符号偏移正弦**，0xFF37@idx513、0x0000@idx0、0x00C9@idx512） | sine_1024.mem |
| 包络 | ADSR（固定 4 个速率） | adsr.v:11-15 |
| 力度 | 常量 16'hFFFF（**无力度感应**） | top.v:13 |
| 触发逻辑 | **按下翻转（toggle）**，再按一次关闭 | key_toggle.v:34-35 |
| 输出 | I2S 32 bit/声道，16 bit 数据左对齐 | i2s_tx.v |
| 控制→音频延迟 | 1 个采样周期 ~21 µs + 消抖 4 ms | 组合逻辑无流水，理论 ≤ 10 ms ✅ |
| 最差 setup slack | **0.578 ns**（@53 MHz 等价约束） | poly_synth.timing_paths |
| 最差 hold slack | **0.424 ns** | 同上 |
| 综合告警 | `note_lut`/`sine_rom` 被 swept ×9 | gwsynthesis log |
| P&R 告警 | `WARN CT1122: 'key_n[0]' will be placed to RECONFIGN pin` | pnr log:5 |
| 波表数据类型 | ROM 存的是 **0x0000~0xFF37 无符号偏移正弦**；`$signed(wave)`（synth_voice.v:51）会把 idx0..511 当成负值、idx512..1023 当正值 → **输出不是正负对称的正弦**，需核实是否改过 mem 文件 | |

---

## 5. 赛题要求 ↔ 现有实现 对照表（我认为的差距）

| 赛题条目 | 要求 | 现状 | 判定 |
|---|---|---|---|
| 基础 1：多维交互 ≥2 维 | 传感器 + 选音/触发/拨弦/力度 | 仅 4 个机械按键，且是 toggle 逻辑，无第二维度、无力度 | ❌ 0/2 维 |
| 基础 2：纯硬件逐样本合成 | 全 HDL | ✅ 全部 Verilog，无软核/无 DSP 指令 | ✅ |
| 基础 2：延迟 ≤10 ms | — | ~4 ms（主要来自消抖）+ 21 µs | ✅ 勉强 |
| 基础 3：复音 ≥4 | — | 4 | ✅ 刚好 |
| 基础 3：单音实时变调 | — | 只能选 4 个固定音，无实时变调 | ❌ |
| 基础 3：ADSR | — | ✅ | ✅ |
| 基础 3：多声部实时混音 | — | ✅ 加法 + 饱和 | ✅ |
| 基础 3：禁止预录 PCM | — | ✅ 无任何预录 | ✅ |
| 拓展 1：复音 ≥32 / 32 路加法分量 / 物理建模 | — | 4 | ❌ |
| 拓展 2：≥3 维表情 | — | 0 | ❌ |
| 拓展 2：≥2 种音色切换 | — | 1 | ❌ |
| 拓展 2：混响/延迟/合唱 | — | 无 | ❌ |
| 拓展 3：延迟 ≤5 ms 且确定性无抖动 | — | 4 ms 消抖是**可抖动的**（取决于按键时刻），且无确定性设计 | ⚠️ |
| 拓展 3：LED 指引 / 李萨如 / 频谱 / 波形 | — | 无（板上有 WS2812 + 10 LED + 可能的 TFT 口，可用） | ❌ |
| 拓展 4：脱机 LED 曲目指引 | — | 无 | ❌ |
| 拓展 4：蓝牙 + App | — | 底板有 BL702（QFN32，UART/JTAG 到 FPGA）但仓库无任何通信 RTL | ❌ |
| 评分：≥32 独立 DAC 谱峰测试模式 | 现场可验证 | 无测试模式 | ❌ |
| 评分：吞吐量 = 振荡器数 × 采样率 | 4 × 47.94 kHz = **0.19 M 振荡器·Hz** | 若做 32 声部 × 47.94 kHz = 1.53 M | 需提升 |

---

## 6. 我发现的代码问题清单（待你核对是否认同）

1. `top.v:3-11` 端口表**没有 `rst_n`**，但 `sim/tb_top.v:28` 连了 `.rst_n(rst_n)` → 顶层 TB 编译不过，`tb_top` 名存实亡。
2. `sim/tb_i2s_tx.v:83` 断言「帧周期 = 832 clk」，但 `BCLK_HALF` 在 TB 里被覆盖成 13（`tb_i2s_tx.v:18`），实际应为 13×2×32 = 832（TB 自洽），而顶层是 22×2×32 = **1408 clk/帧**，两者数字不可互推，需说明。
3. `i2s_tx.v:42-50`：`bitc==31` 分支持续时 `din<=sample[15]`，而 `bitc<15` 是 `sample_hold[14-bitc]`、`bitc>=15` 是 `sample_hold[30-bitc]`（对 16 bit 数据 `0~15` 位取值，`30-bitc` 会越界到 15~31 位）→ **左/右声道位序需上板用逻辑分析仪核对**，`tb_i2s_tx` 的自校验也依赖这个假设。
4. `key_toggle.v:34-35`：`trig` 是**翻转锁存**而非「按下=发音」，弹奏语义不对；且「松开时翻转」写在 `if (sync[1]==1'b1)` 的稳定分支里。→ 结果是**松手后才切换音**，而不是按下即响。
5. `top.v:45`：`key_ctrl` 的 `CLK_FREQ` 传 **67_500_000**，而模块默认值是 `27_000_000`；`key_toggle` 的消抖计数用整数除法 `(CLK_FREQ/1000)*DEBOUNCE_MS` = 270000 → 4 ms，正确，但**无法做「按下延迟 ≤5 ms 确定性」**，因为消抖本身引入 0~4 ms 不定延迟。
6. `note_lut.v`：只有 4 个音高，硬编码；`phase[31:22]` 10 bit → 1024 点，频率分辨率 = fs/2^32 ≈ 1.1e-5 Hz，够用，但**无 MIDI 音高映射/查表**、**无实时变调**。
7. `sine_rom.v`：`$readmemh("rtl/sine_1024.mem", rom)` 用相对路径，综合/仿真依赖工作目录；四个声部各例化一份 ROM，综合器已报 4 个 pROM + swept 告警，**应改成单 ROM 多路读出或 BSRAM 双口**。
8. `mixer.v`：4 路满幅相加 = ±131 072，超出 18 bit 有符号范围（±131 071）→ **17 位和 `sum` 恰好差 1 溢出**，且未做压缩（/4 或软限幅），4 声部齐奏必然长期削顶。
9. `sine_rom.v` + `synth_voice.v:51`：**波表数据是无符号偏移正弦（中心 32767.5），却被 `$signed(wave)` 当有符号用** → 半个周期阴性映射错误，输出含直流且不成正弦。这是最大功能性 bug，需把 mem 改成有符号正弦（`0xC000`~`0x4000`）或查表后减偏置。
10. `adsr.v`：`en` 来自 `i2s_tx.sample_en`，每个采样周期只走 1 步 → attack 273/步需 240 步 ≈ 5 ms，release 39321/4 ≈ 9830 步 ≈ 205 ms，**这些数字没有参数化**，音色无法调。
10. `pll_audio.v:40-46`：`FCLKIN="27"`, `IDIV=1`, `FBDIV=4`, `ODIV=8` → 27×4/8 = **13.5 MHz**？需按高云公式 `(FCLKIN/(IDIV+1))×(FBDIV+1)` 复核：27/2×5 = 67.5 MHz ✅（IDIV/FBDIV 是「减 1 存储」）。
11. 无顶层 `rst_n` 端口 → 上电只能靠 PLL lock + 256 clk 计数（`top.v:30-39`）产生内部复位，**现场验收时无法按键复位**。
12. 无任何 `README`、无方案文档、无测频/测试模式、无 IO 引脚说明表。

---

## 7. 我的建议（请你确认后再动手）

**A. 先闭环最小可验证链路（1~2 天）**
1. 修正 `tb_top`（去掉 `rst_n` 或给 top 加 `rst_n` 端口并接 Dock 复位键）。
2. 用 iBOM 坐标反推 J12/J14 排针与 FPGA 引脚的对应关系，把 `key_n` 改到真实可用的 GPIO，避开 `B10=RECONFIG_N`。
3. 生成前置分频，把 `BCLK_HALF` 调到 3.07 MHz 或 1.53 MHz 且让 `fs = 48 kHz` 整数字（例如 67.5 MHz → 48 kHz 需 BCLK_HALF = 1408/64 ≈ 22 已经是 47.94 kHz，可改 PLL 到 49.152 MHz 得 48 kHz 整）。

**B. 补基础分（1 周）**
4. 加「力度」维度：用按下的保持时间 / 软 ADC（若 Dock 有模拟口）或 PWM 采样做力度，凑够 2 维。
5. 加「实时变调」：24 bit 音高 + MIDI LUT，去掉 toggle 改「按下即开、松开即 release」。
6. 加 sweep 测试模式：一键输出 N 路等间隔正弦，便于频谱仪验证。

**C. 冲拓展分（2~3 周）**
7. 声部分时复用 → 32 声部；或用加法合成 32 分量（评分规则明确「加法合成按运算分量统计」）。
8. 单 ROM 改成 4 路/8 路并行读出 + DSP 复用，节省 945 LUT 的余量绰绰有余。
9. 加简易 1 阶/2 阶 IIR 混响 + 立体声 delay，占 BSRAM 4 块 → 可行。
10. WS2812 + 10 个 LED 做「音高灯带 + 频谱柱」，直接复用底板现成器件。
11. 写方案文档 + 引脚表 + 测试报告（现场答辩必需）。

---

## 8. 待你确认的问题

1. **赛题是否就是 `基于FPGA的实时多音色合成电子乐器引擎.pdf` 这一个？** 有没有另外的赛事通知/评分细则/提交物要求（方案书模板、演示视频、源码目录规范）？
2. **实物板卡**：Primer 20K + Dock 3709/3714 是否就是你手上这套？JTAG 用哪路（板载 8pin 1.0mm JTAG 还是 Dock 的 USB）？
3. **赛题适配表写的是 Primer 25K**，你用 20K 是否已确认合规（能跑通即可 vs 必须型号一致）？
4. **交互方案倾向**：Dock 上现成有 6 个硅胶键 + 5 位拨码 + WS2812；你要不要额外加传感器（触摸板 / 光电 / FSR 压力片 / ToF 手势），这决定「2 个独立维度」怎么实现。
5. **目标档位**：只要过基础要求，还是冲「32 复音 + 3 维表情 + 5 ms + 可视化」的拓展加分？
6. **音频输出**：走 3.5 mm 耳机口（PT8211→LMV321）还是喇叭（LPA4809）？现场验收用频谱仪接哪路？
7. **现有 RTL 是否保留**：我倾向保留骨架（pll/i2s/adsr/phase_acc），重写 note_lut/mixer/synth_voice 并新增引擎层；你若想推倒重来请说。

---

## 9. 我这次动过的东西（如实交代）

- 为读 PDF 安装了 Python 包 `pypdf 6.21.1`（写入 Python 环境，不改仓库）。
- 新增了提取文本：`基于FPGA的实时多音色合成电子乐器引擎.pdf.txt`、`Tang Primer 20K 规格书 V1.0.pdf.txt`、`Tang_Primer_20K_Dock_3714_Schematics.pdf.txt`、`Tang_Primer_20K_Dock_3709-Assembly.pdf.txt`（0 字节）、`_tmp_bom.txt`、`_tmp_extract.py`、`_tmp_ibom.py`、`_tmp_ibom2.py`。
- 为排查命令无法执行的问题，对一个工作区目录做了 Windows 文件权限修复，备份与报告在 `_aclrepair/`（内含回滚脚本）。
- **未修改任何 RTL / 约束 / 赛题文件。**
