Minghu00/fpga-voice-synth/docs/纯代码任务清单.md

# 纯代码可完成任务清单

> 基准：提交 `e0dafa6`。综合 0 告警，Fmax **119.185 MHz @ 108 MHz 约束**（余量 10.3%），
> Logic 2721/20736 (14%)，Register 1214/16173 (8%)，BSRAM 4/46，DSP 3/24 (MULT18X18 6)。
> **每完成一项都必须重跑这四项**，任何一项退化就停下来修。

---

## 0. 总原则

每一项按同一套流程走，不跳步：

| 步骤 | 动作 | 通过标准 |
|---|---|---|
| 1 | 写 RTL | 模块参数化，接口在 `rtl/README.md` 登记 |
| 2 | 写/扩 testbench | 自检断言，打印 `ALL PASS` |
| 3 | 跑 `scripts\run_all_sim.ps1` | **14 个平台全绿**（不允许带着红提交） |
| 4 | 跑 `scripts\build_inst.ps1` | **0 告警**、Fmax ≥ 108 MHz、资源在预算内 |
| 5 | 核对管脚 | `inst.pin.html` 里 35 个端口 ball 不变（新增端口除外） |
| 6 | 更新文档 + 提交 | `乐器位流说明.md` 接线表同步；一个独立 commit |

**控制输入不新增管脚。** 现有可用输入：`dip[3:0]`（SW3 前四位）、`sw5_vol`（第五位）、
`key_btn`（Key_2）、`vup_sw`（Key_3）、`test_sw`（P6/J14-12）、8 个触摸键。
新功能一律用**长按 / 组合键 / 显示模式**去选，避免用户再接线。

---

## P0 · 现场测试模式 —— 评分③（最高优先，半天）✅ **已完成**

**状态**：2026/10/24 完成。`sim/tb_test_mode.v` 24 项全过；8 平台回归全绿；
Fmax **119.647 MHz**（比基线还高 0.46 MHz），0 告警，**35 个管脚未变**。
证据文档：`docs/测试模式证据.md`。

**要解决的问题**：评委现场要求"输出多路不同频率，频谱上看到对应数量独立谱峰，
且 RTL 能佐证没有预录播放"。现在没有这个模式，等于直接丢评分③。

| 项 | 内容 |
|---|---|
| 新增 | `rtl/audio/test_mode.v`（选通结果**内部打一拍**，否则 Fmax 掉到 108.85 MHz） |
| 扩表 | `rtl/audio/inc_lut.v` 13 项 → 25 项（C4…C6），索引 0–12 逐位不变；后因键位琶音化再扩到 29 项（C4…E6），0–24 仍逐位不变 |
| 触发 | **上电时按住 `vup_sw`（Key_3）** → 进入测试模式；松开保持，直到断电。零新管脚 |
| 行为 | 忽略触摸，8 个声部固定到 8 个标称音名（隔 3 个半音，跨两个八度）；**每声部只开 1 个加法分量**（纯正弦），同时发声 |
| 频率 | 261.6 / 311.1 / 370.0 / 440.0 / 523.3 / 622.3 / 740.0 / 880.0 Hz，最小间距 49.5 Hz |
| 强制项 | `timbre=0`（管风琴=单分量）、`oct=0`（确定性 + 溢出安全）、`vol=2`（1.0×，8 路叠加不削波） |
| 为什么只开 1 个分量 | 若 4 个分量全开，一个声部占 4 根谐波谱峰，评委会数出 32 根而不是 8 根，反而像虚报。测试模式要"干净可数" |
| 屏幕 | 状态条 `x 168..191` 红块亮 = TEST |
| 证据 | `docs/测试模式证据.md`：频率表、溢出预算、32 累加器的 RTL 出处、答辩口径 |
| TB | `sim/tb_test_mode.v`：24 项，含上电窗口、锁存粘性、NOTE_SET、间距、溢出 |
| 验收 | ✅ 全部达成。`grep -r readmemh rtl/` 只剩 `wavetable_bank.v` 的波表（P3 之后） |

---

## P1 · 显示三模式 + 实时频谱 + 真李萨如 —— 拓展③（1 天）

> **状态：✅ 全部完成**（2026-10-25）。P1a 显示页切换 ✅、P1b 实时频谱 ✅（16 bin DFT，
> `rtl/display/spectrum16.v`，证据 `docs/显示页证据.md`）；**P1c 真李萨如 ✅**（左右声道
> X-Y 页，`rtl/display/liss_render.v`，证据 `docs/李萨如证据.md`）。
> 实测：**15 平台全绿**、**0 告警**、**35 管脚未变**、Logic 4159（21%）· Register 2100（13%）·
> BSRAM 13/46（29%）· Fmax **109.063 MHz**（slack +0.090 ns，做过多轮 Fmax 加固，见 `docs/Fmax加固记录.md`）。

现在屏上固定是"波形 + 包络 + 色块 + 键盘"，拓展③要求的**实时频谱**和**李萨如图形**
都没有。而且 272 行已经排满，硬塞会挤掉现有内容。

| 子项 | 内容 |
|---|---|
| P1a 模式切换 | `lcd_scope` 增 `input [1:0] disp_mode`；**长按 `key_btn`（Key_2）1 秒**循环切换：0=波形+包络（现状，默认）、1=频谱+包络、2=李萨如+包络、3=诊断（保持现有色块/灰阶用于上板验色） |
| P1b 实时频谱 | 新增 `rtl/display/spectrum.v`：8 带 **Goertzel**（比 FFT 省、只算能量）。中心频率取 130/260/520/1k/2k/4k/8k/16k Hz，`N=1024`（分辨率 47 Hz），24 位累加 + 饱和防爆。柱状绘制直接复用 `lcd_scope` 的倒数乘法列索引 |
| P1c 真李萨如 | 先说清：现在的"相位图"是**单声道 sample vs 上一拍**的相轨迹，不是李萨如。真李萨如要 X=L、Y=R。所以先给 `mixer16` / `audio_out` 加**声像**：声部 i 按 i/(VOICES-1) 分到 L/R（`l * (VOICES-1-i) + r * i` 之类），左右声道内容不同，X-Y 才是图形 |
| 屏幕布局 | 模式 1/2 复用现成的 `y48..111`（示波器区）与 `y112..175`（柱区），不改行分界，只换数据源 → 布局风险最低 |
| TB | 扩 `sim/tb_inst.v`：三种模式各断言一个代表性像素块的点亮数区间 |
| 风险 | 声像会改变**听感**（声音变宽）。默认给"声像=居中"，只在模式 2 用到 L/R 差异时才展开？不行——李萨如需要实时差异。折中：默认声像轻微展开（±20%），听感变化很小但图形明显 |

---

## P2 · 表情与效果 —— 拓展②（1 天）✅ **已完成**

> **状态**：`tb_vibrato_lfo` 8 项 + `tb_fx_echo` 8 项 + `tb_inst` 52 项全过；11 平台全绿；
> 综合 0 告警，Fmax **116.540 MHz** @ 108 MHz（余量 7.9%），35 端口未变；
> 位流 `impl_inst/pnr/inst.fs` 重建完成（2026-10-25 18:58:48）。证据见 `docs/滑音颤音延迟证据.md`。

| 子项 | 实际实现 |
|---|---|
| P2a 滑音 | 没新建 `portamento.v`，直接做进 `osc_bank.v` 的帧尾预计算流水（每帧只有 8 声部一次，成本极低）。`tgt_inc` 阶梯，`inc_org[v] += (tgt - inc_org[v]) >>> 8`，5 次到 87%、20 次到 99%，时间常数 **≈95 ms**；目标由「最近进入的键」`glide_idx`（3 位，按 `key_rise` 优先级编码）给出 |
| P2b 颤音 | `vibrato_lfo.v`：24 位相位累加器 + 32 项四分之一正弦表（192 bit 纯 LUT，不占 BSRAM），相位增量 `PH_INC = round(5 * 2^24 / 48214.29) = 1740` → **实测 4.998 Hz**。**乘性**调制：`inc_org * (1024 + (vib*DEPTH>>10)) >> 10`，DEPTH=18 → **±30 cent**。LFO 全局共用（听感自然）|
| P2c 板内延迟 | `fx_echo.v`：**8192×16 BSRAM**（4 块）环形缓冲，`D=6000` 采样 → **124.4 ms**，反馈 `0.375`、湿声 `0.25`。写回通路拆成**三个 `en` 周期**（抓 tap → 算反馈增益 → 写回），反馈端口由触发器而非 BSRAM 输出驱动 |
| 开关 | **长按 Key_2 0.8 秒**循环 8 档（短按仍是锁存模式，靠「松开沿」区分）：`0 全关 / 1 颤音 / 2 延迟 / 3 颤音+延迟 / 4 滑音 / 5 颤音+滑音 / 6 延迟+滑音 / 7 全开`。状态条 x 240..263 橙块 |
| TB | 新建 `tb_vibrato_lfo.v`（8 项）、`tb_fx_echo.v`（8 项逐拍比对）；扩 `tb_inst.v` 到 52 项（含「短按不切档 / 长按切档 / 切档后波形仍活」）|
| 风险（实际发生）| Fmax 三次迭代：真乘法器 **109.734 MHz** → 换纯移位 **108.315 MHz**（证明瓶颈不是乘法器）→ 写回三级流水 **116.540 MHz**。|
| 顺手修的 bug | `top_inst.v` 的 `lead_note` 原用 stride-4 切片（`note_flat[key*5 +:5]` 隐含 `*5` 乘法且索引算错，TP3 滑到 TP5 的音），改成显式 8:1 mux + 寄存器；`tb_inst` 新增 2 项音高断言（原来只断言「glide 复位后关闭」，没断言音高，所以 52 项里一直没抓到）|

---

## P3 · 多波表 —— 评分①加固（半天）✅ **已完成**

**要解决的问题**：原来 32 个分量读的是**同一张**正弦表，严格按"单波表查表只计 1 个振荡器"
可能被判 1 个。给每个分量一张不同内容的表，坐实"独立发声单元"。

> **状态**：24 项断言全过 / 9 个平台全绿 / Logic 2875（14%）· Register 1282（8%）·
> BSRAM 7/46（16%）· **Fmax 124.043 MHz**（比 P0 的 119.647 还高 4.4 MHz）·
> 最差 setup slack +1.198 ns / **35 个管脚一个都没动** / 0 告警 / 位流 7,264,154 B。
> 证据文档：`docs/多波表证据.md`。

| 项 | 实际做法 |
|---|---|
| 生成 | 四张表**合成一个文件** `rtl/audio/wav_bank_4096.mem`（4096 行 × 16 bit），四段各 1024 行：正弦 / 三角 / 锯齿 / 方波。三张新表**全部带宽限到 8 次谐波**（避免不必要的混叠），归一化到峰值 32767 |
| 兼容性 | **第 0 段与旧 `sine_1024.mem` 重新生成后逐行 0 处不同** → `wave_mode=0` 时四个原音色的声音**逐位不变** |
| 新增 | `rtl/audio/wavetable_bank.v`（删掉 `sine_rom.v`）：`tab_sel[1:0]` + `addr[9:0]` → `{tab_sel,addr}` 寻址 **一块 4096×16 BSRAM**，读延迟仍 1 拍、单读端口 |
| 改 `osc_bank` | `wire [1:0] tab_nx = wave_mode ? cidx : 2'd0;` + `tab_q` 与 `rom_a` 同时打拍；`wave_mode=1` 时幅度改成 `{8192,8192,8192,8192}`（各 0.25） |
| 进入方式 | **长按 Key_3（D7）约 0.79 s** 切换，粘性保持，断电退出。短按仍是音量 +1。零新增管脚 |
| 屏幕 | 状态条 `x 192..215` 橙色块 = WAVE 生效（顺手修掉了 P0 的 TEST 红块覆盖 216 px、右半边重复点亮两个缺陷）|
| 资源 | BSRAM 4 → **7/46（16%）**，逻辑 +91 LUT、寄存器 +23。**Fmax 反而 +4.4 MHz**（BSRAM 同步读替掉了紧的组合路径）|
| TB | `sim/tb_wavetable.v`：**4096 个 (tab,addr) 点逐个与 `.mem` 比对，0 处不符** + 6 个校验点 + "四表确实不同" + "读延迟恰好 1 拍"；`tb_osc_bank` 加 2 项选表断言；`tb_inst` 加 5 项长按/短按断言 |

---

## P4 · 脱机 LED 曲目指引 —— 拓展④（1 天，**需先确认硬件**）

| 待确认 | 说明 |
|---|---|
| 板上 U17 (WS2812B) | 原理图第 9 页有一个 WS2812B 在板，`DIN` 接 `LED_DAT`；`J14-6 = WS2812-DAT`(T9) 是同网络。**要先确认 U17 的 DOUT 是否引到排针**，才能判断能不能串外接灯带 |
| 6 个 Orange LED | `Orange_LED0..5` 接 `C13_IOR32B_DONE` / `A13_IOR32A_READY` / `N16` / `N14` / `L14` / `L16`。前两个是**配置状态脚**，能否当 GPIO 要试综合才知道；后四个是普通 IO |

**若可行**，方案：`rtl/display/led_guide.v` + WS2812 800 kHz 时序驱动（24 位 GRB，
`T0H=0.4µs/T1H=0.8µs`，用 108 MHz 计数 → 43/86 拍）。曲目用 ROM 存 `{note, duration}` 序列，
`led_guide` 依次点亮对应键位对应的灯，实现"脱机曲目指引"。

**若不可行**：退化为"屏幕上高亮下一个应按键位"（纯显示，零成本），拓展④只能放弃。

---

## P5 · 演奏记录 UART 回传 —— 拓展④（半天，**需先确认硬件**）

FPGA 侧可做：`rtl/audio/uart_tx.v`（115200 8N1，27 行就够）+ 音符事件打包（`note, note_on/off, timestamp`）。
接到 Dock 的 `M11_IOR27B_FPGA_TXO`（BL702 UART1_RX）。

**但** "手机 App 回传"这一半做不了：BL702 默认固件不认识这个协议，手机端也没有 App。
所以此项最多做到"PC 串口助手能看到音符列表"，不能宣称拓展④完成。

---

## 6. 明确做不了的（不要写进交付物吹）

| 赛题条目 | 为什么做不了 |
|---|---|
| 拓展②「力度感应」 | TTP229 二值输出，硬件拿不到压力。除非换 FDC2214 / 加 FSR |
| 拓展②「多键同时按」 | 芯片出厂 `TP3=TP4=1` 全单键模式，必须物理改焊盘（已有锁存模式作为演示规避手段） |
| 拓展④「蓝牙 + 手机 App」 | 需要 BL702 固件 + App，超出本项目范围 |
| 拓展④「录音回传」完整链路 | 同上，只能做到 FPGA 串口发数据 |

---

## 7. 建议执行顺序与里程碑

```
P0 现场测试模式        → 里程碑 1：评分③ 有据可依（最重要，先做）   ✅ 已完成
P3 多波表              → 里程碑 2：评分① 加固（放前面因为会动 osc_bank 核心）  ✅ 已完成
P2 滑音/颤音/延迟      → 里程碑 3：拓展② 从"部分"变"基本达标"（表情 2/3、效果 1/3）✅ 已完成
P1 三模式+频谱+李萨如  → `✅ 已完成`，拓展③ 从"部分"变"基本达标"
P4 LED 指引 / P5 UART  → 里程碑 5：拓展④（受硬件制约）
```

**为什么 P3 排在 P2/P1 前面**：它要改 `osc_bank` 的读表通路，动的是最核心、最容易掉
Fmax 的地方。先把它做完并重新收敛时序，后面 P1/P2 的改动才有一个稳定的基线可以比。

每个里程碑结束时跑一遍：
```powershell
powershell -NoProfile -ExecutionPolicy Bypass -File scripts\run_all_sim.ps1
powershell -NoProfile -ExecutionPolicy Bypass -File scripts\build_inst.ps1
```
并把资源/Fmax 记到 `docs/里程碑记录.md`，方便以后回退定位。

---

## 8. 需要你确认的两件事（✅ 均已确认）

1. ~~**P4 的 WS2812**~~ → 用户 m05690 原文「我没有灯带第一」：**没有灯带，P4 退化为屏幕高亮**，
   省下一天。
2. ~~**P1c 声像**~~ → 用户 m05690 原文「第二接受」：**允许把 8 个声部轻微分到左右声道
   （±20%）** 以做真李萨如。现有的"左右声道完全相同"仿真断言需要相应修改。
