Minghu00/fpga-voice-synth/Tang_Primer_20K_Dock_3714_Schematics.pdf

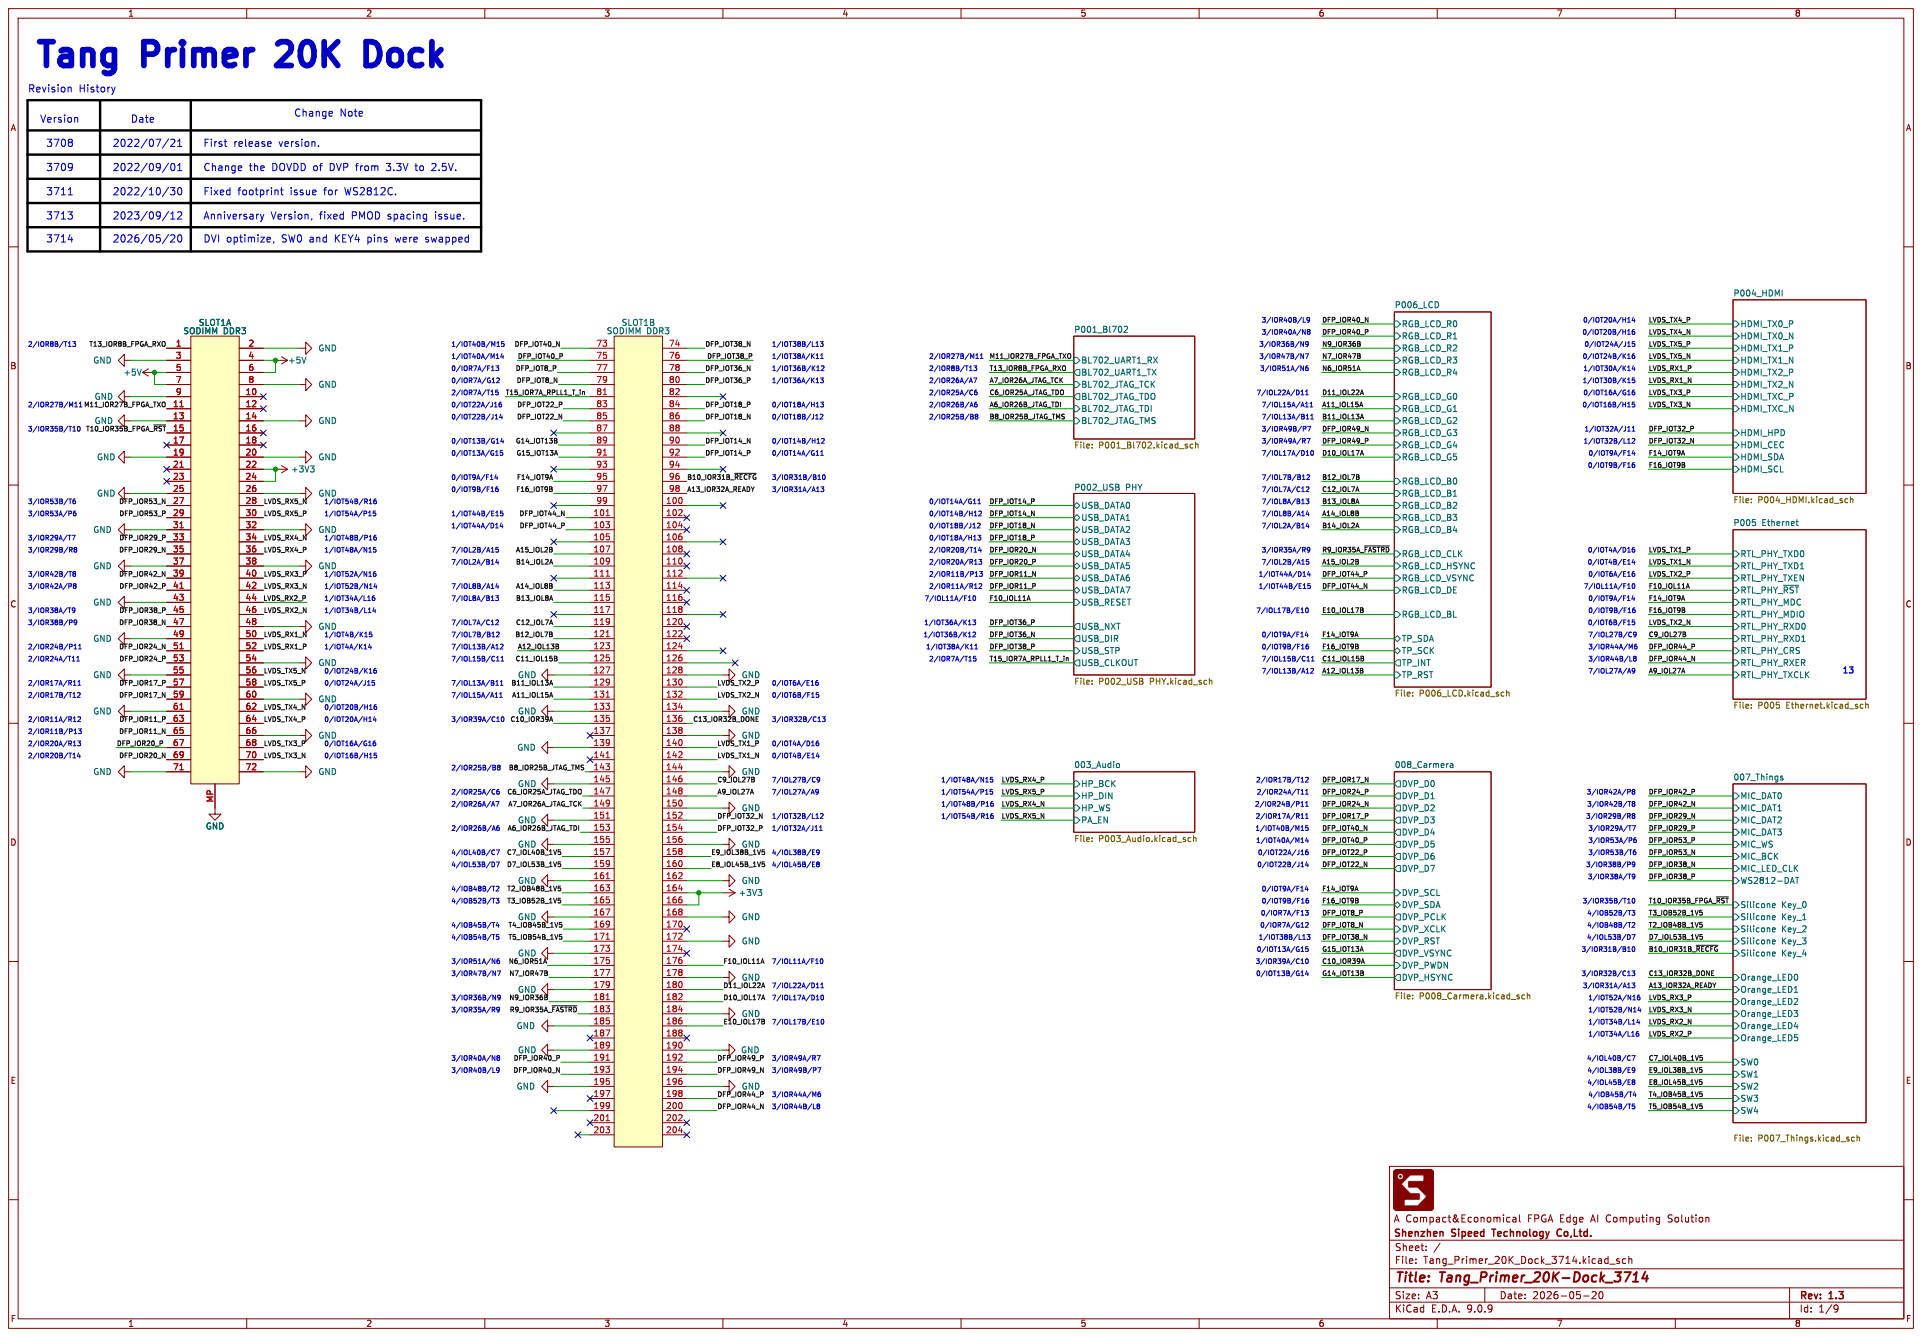
[picture p11: page 1]

Change Note
SODIMM DDR3 GND GND GND

GND GND

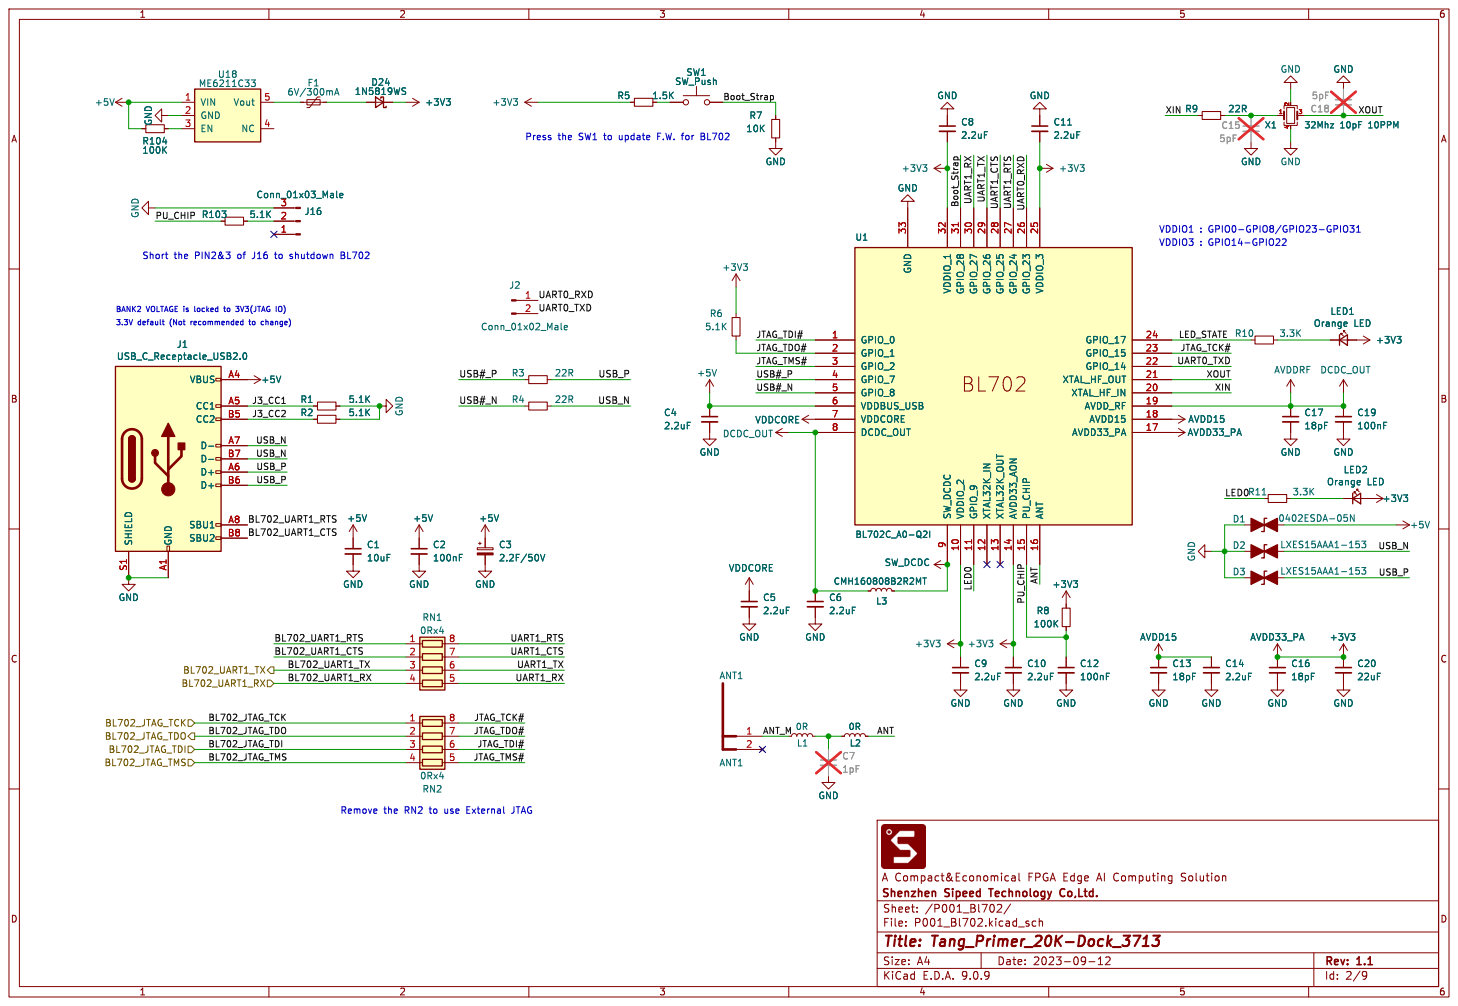
[picture p12: page 2]

VDDIO3 : GPIO14-GPIO22 Short the PIN2&3 of J16 to shutdown BL702

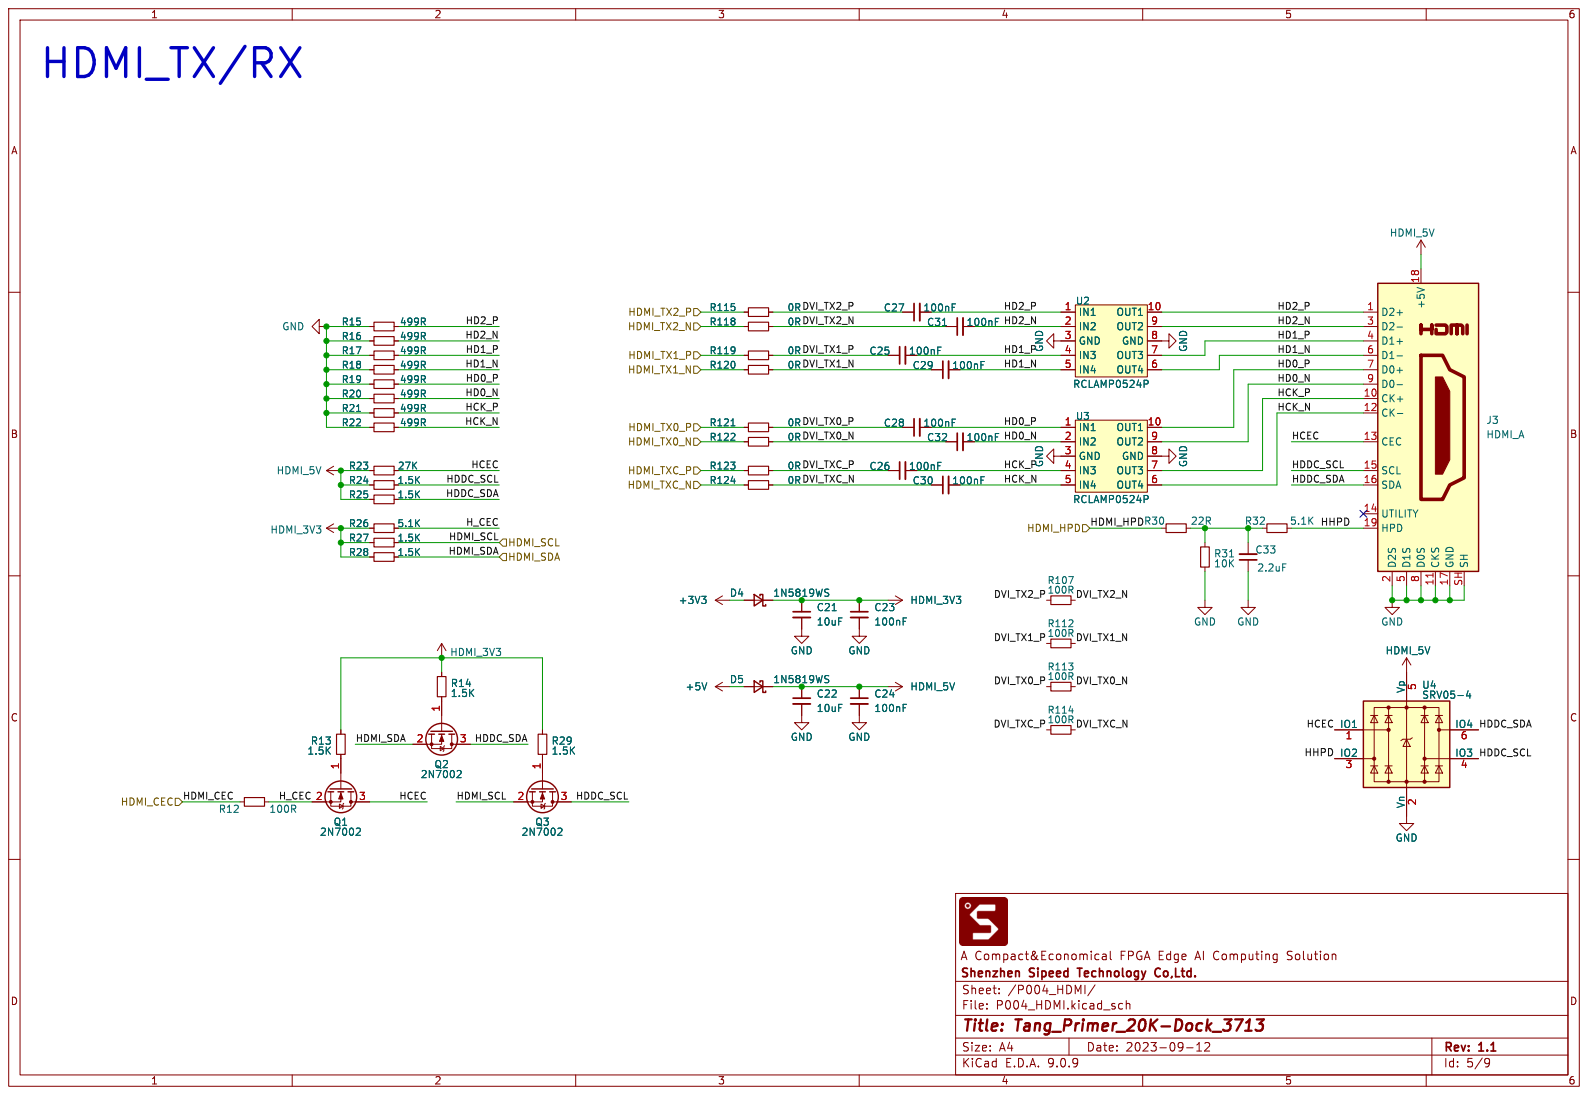
[picture p13: page 3]

8 CKS 11 GND 17 SH SH

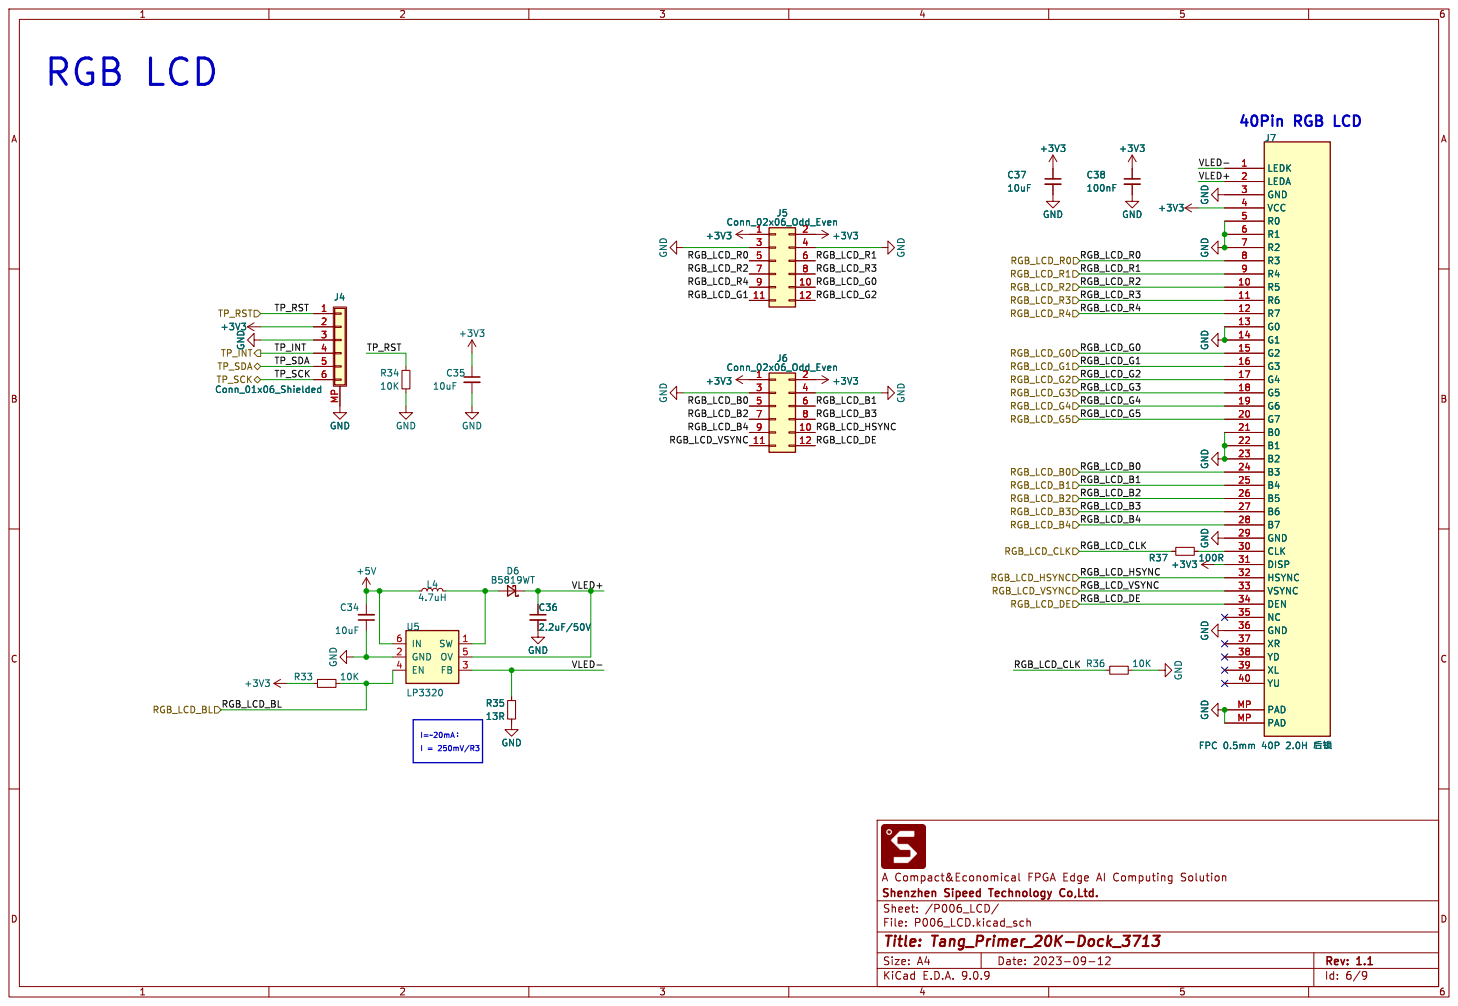
[picture p14: page 4]

þÿI=~20mAÿ RGB LCD

FPC 0.5mm 40P 2.0H þÿT• GND GND GND

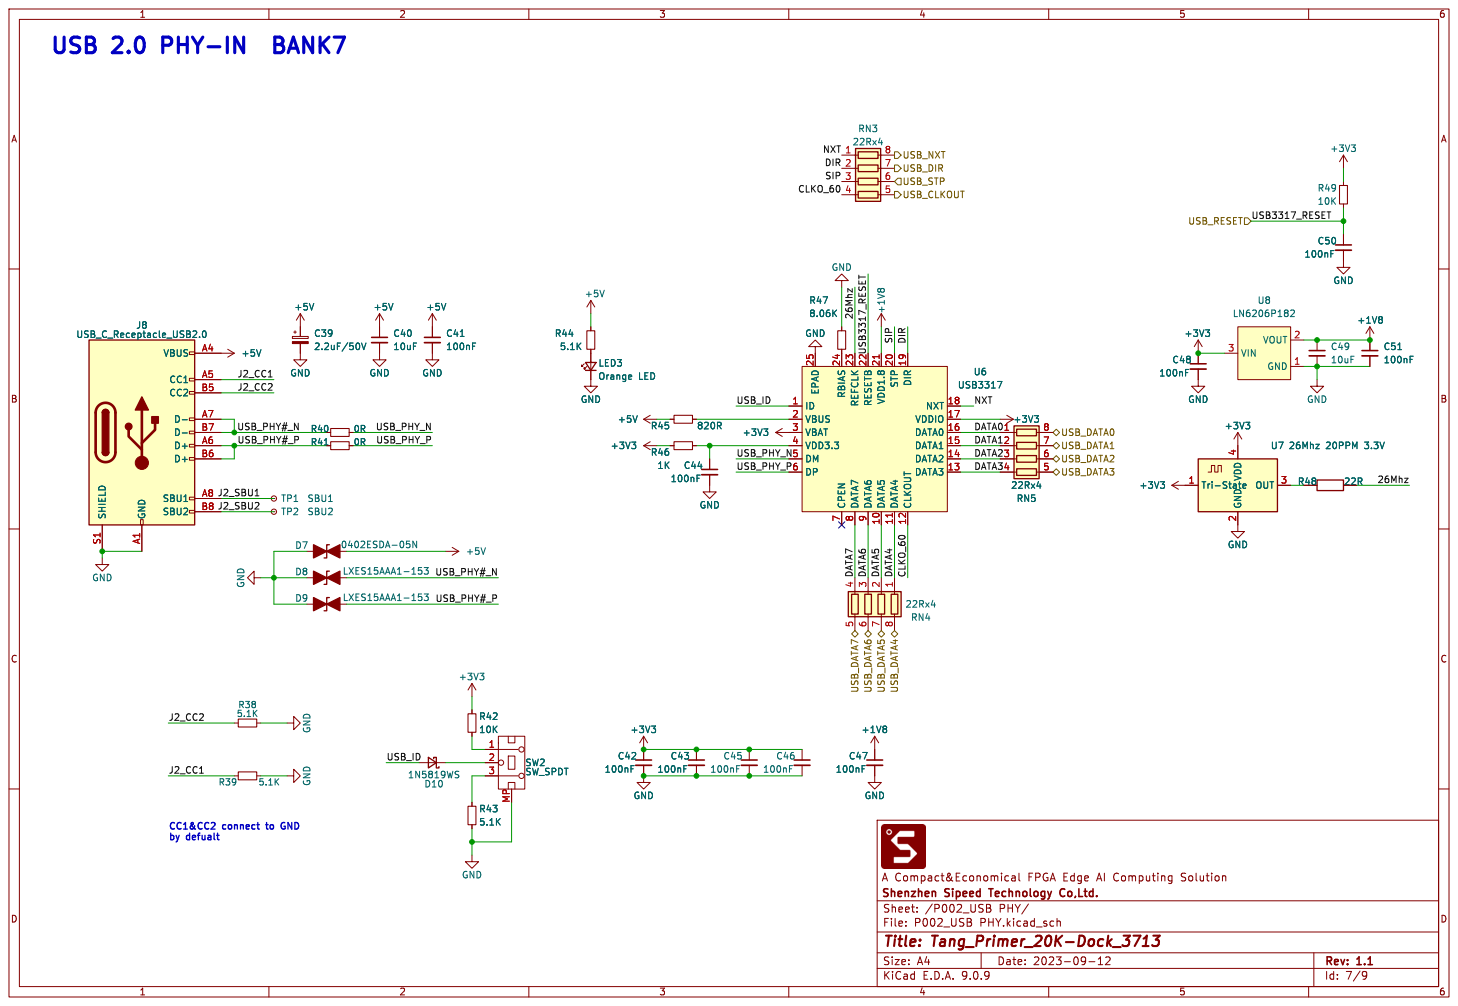
[picture p15: page 5]

9 VDD1.8 21 DATA5 10 STP 20 DATA4 11 DIR 19 CLKOUT 12 NXT 18 VDDIO 17 DATA0 16 DATA1 15 DATA2 14 DATA3 13 U6 USB3317 D7 0402ESDA-05N

9 VDD1.8 21 DATA5 10 STP 20 DATA4 11 DIR 19 CLKOUT 12 NXT 18 VDDIO 17 DATA0 16 DATA1 15 DATA2 14 DATA3 13 R41 0R

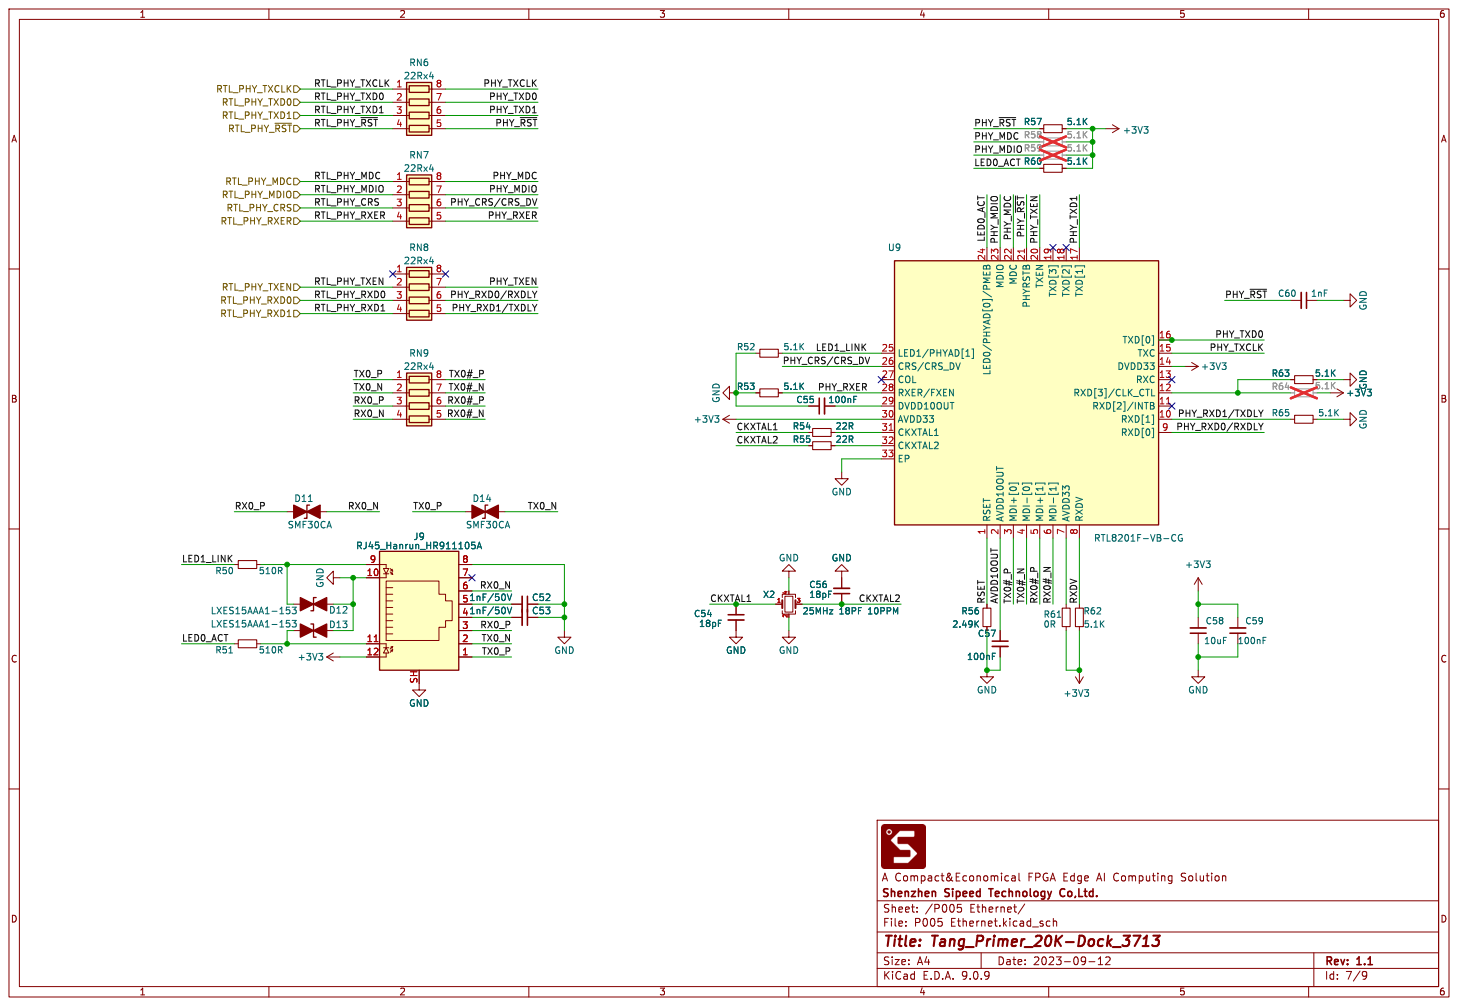
[picture p16: page 6]

8 EP 33 CKXTAL2 32 CKXTAL1 31 RXD[0] 9 AVDD33 30 RXD[1] 10 DVDD10OUT 29 RXD[2]/INTB 11 RXER/FXEN 28 RXD[3]/CLK_CTL 12 COL 27 RXC 13 CRS/CRS_DV 26 DVDD33 14

2 MDI+[0] 3 MDI-[0] 4 MDI+[1] 5 MDI-[1] 6 AVDD33

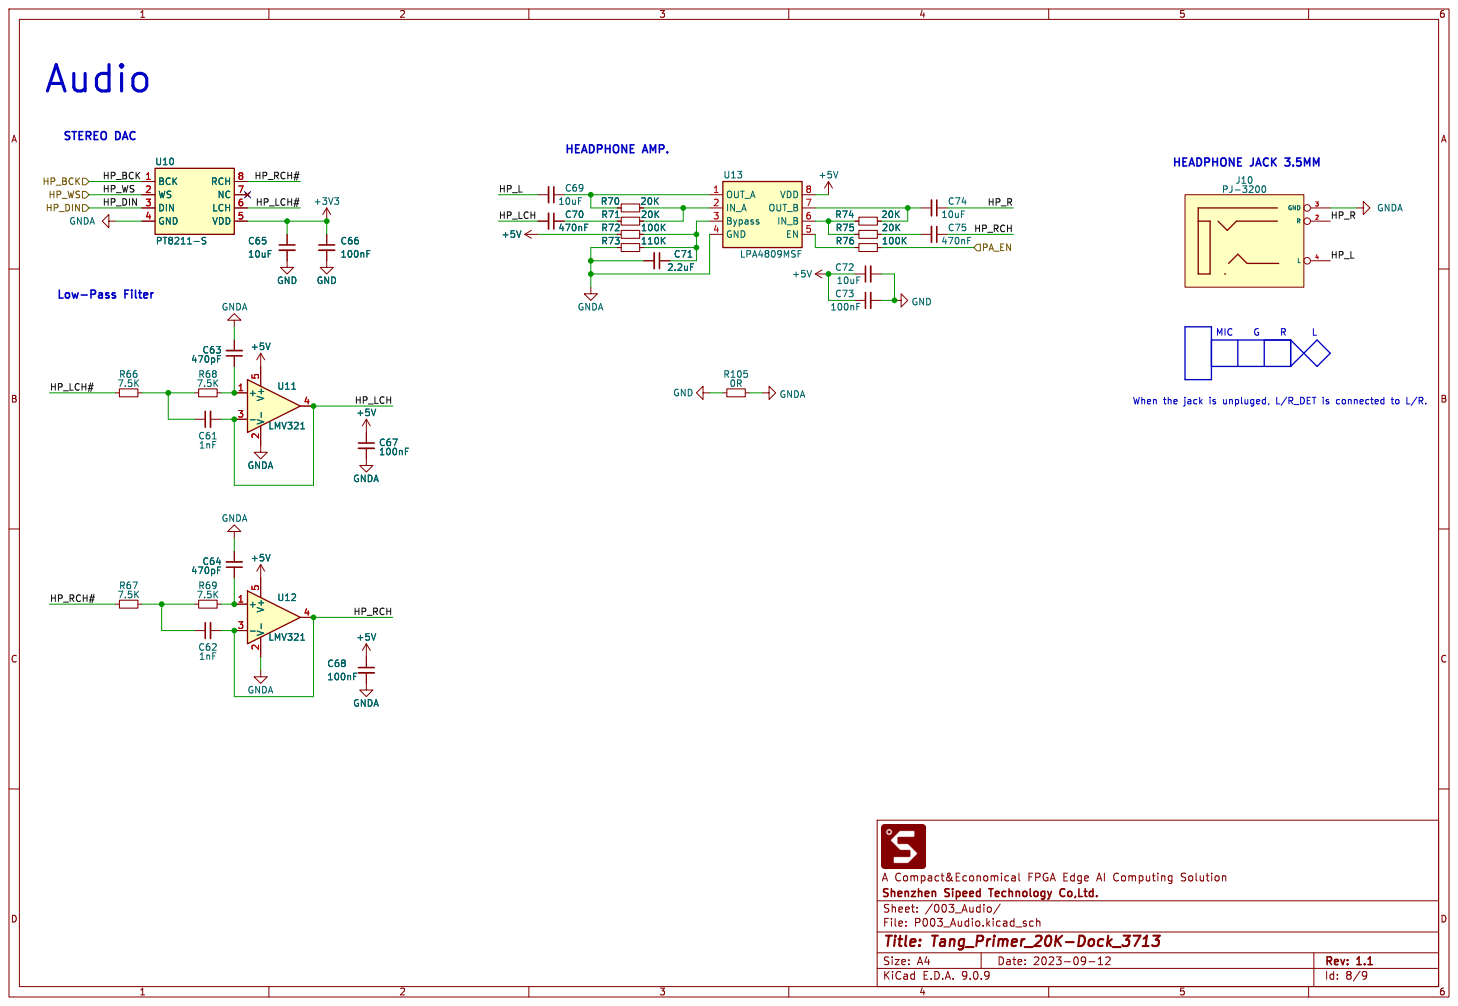
[picture p17: page 7]

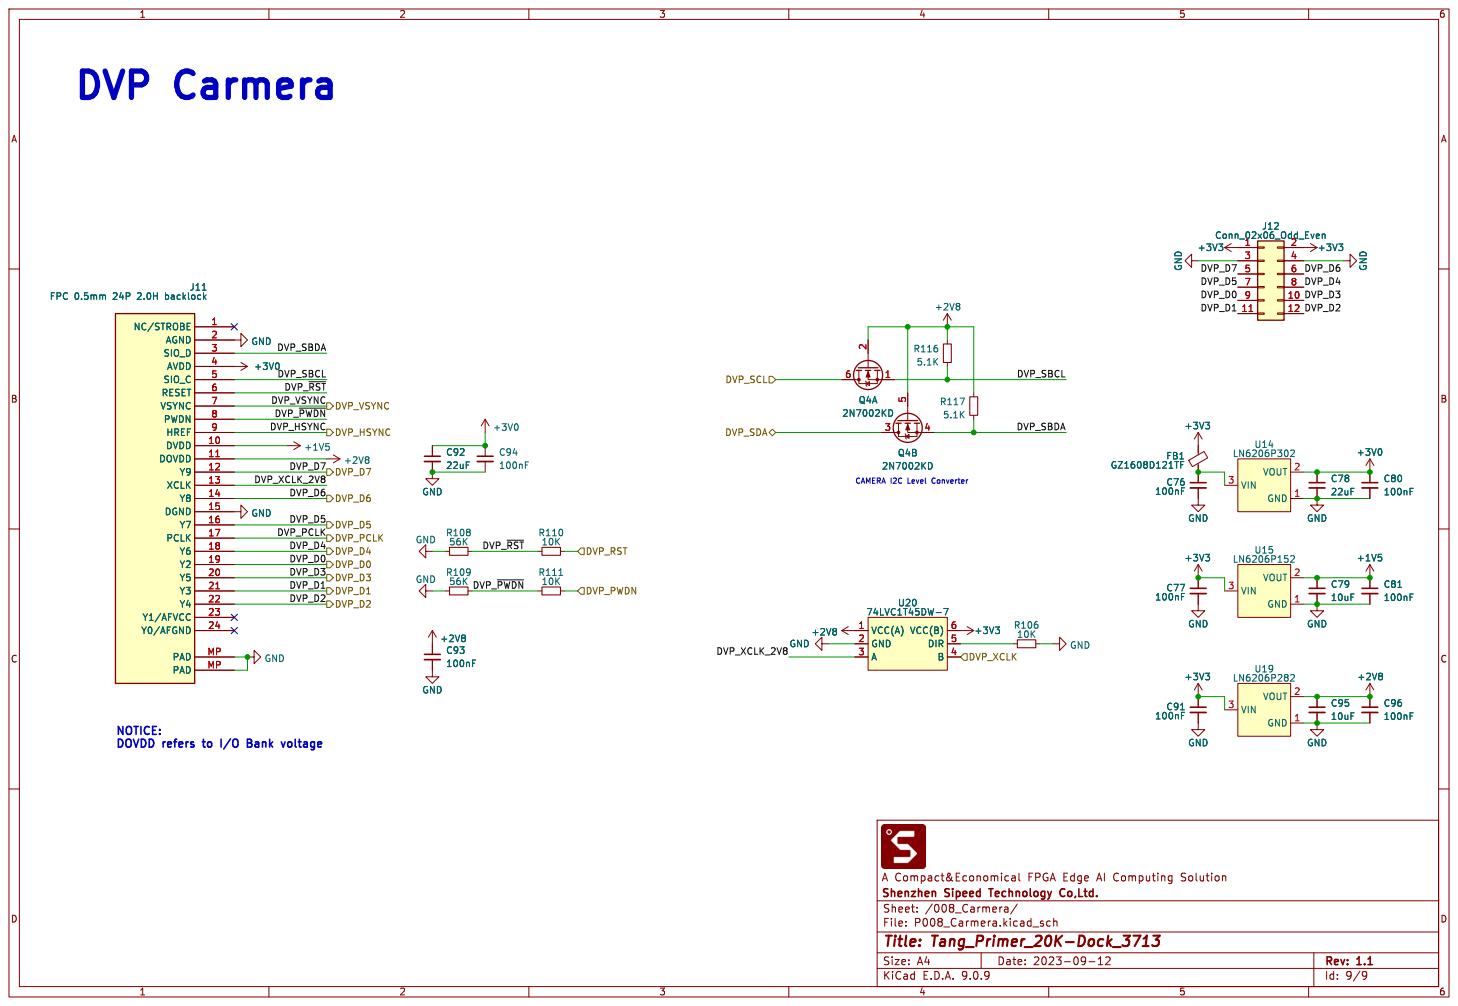
[picture p18: page 8]

DVP_D0 NOTICE: DOVDD refers to I/O Bank voltage

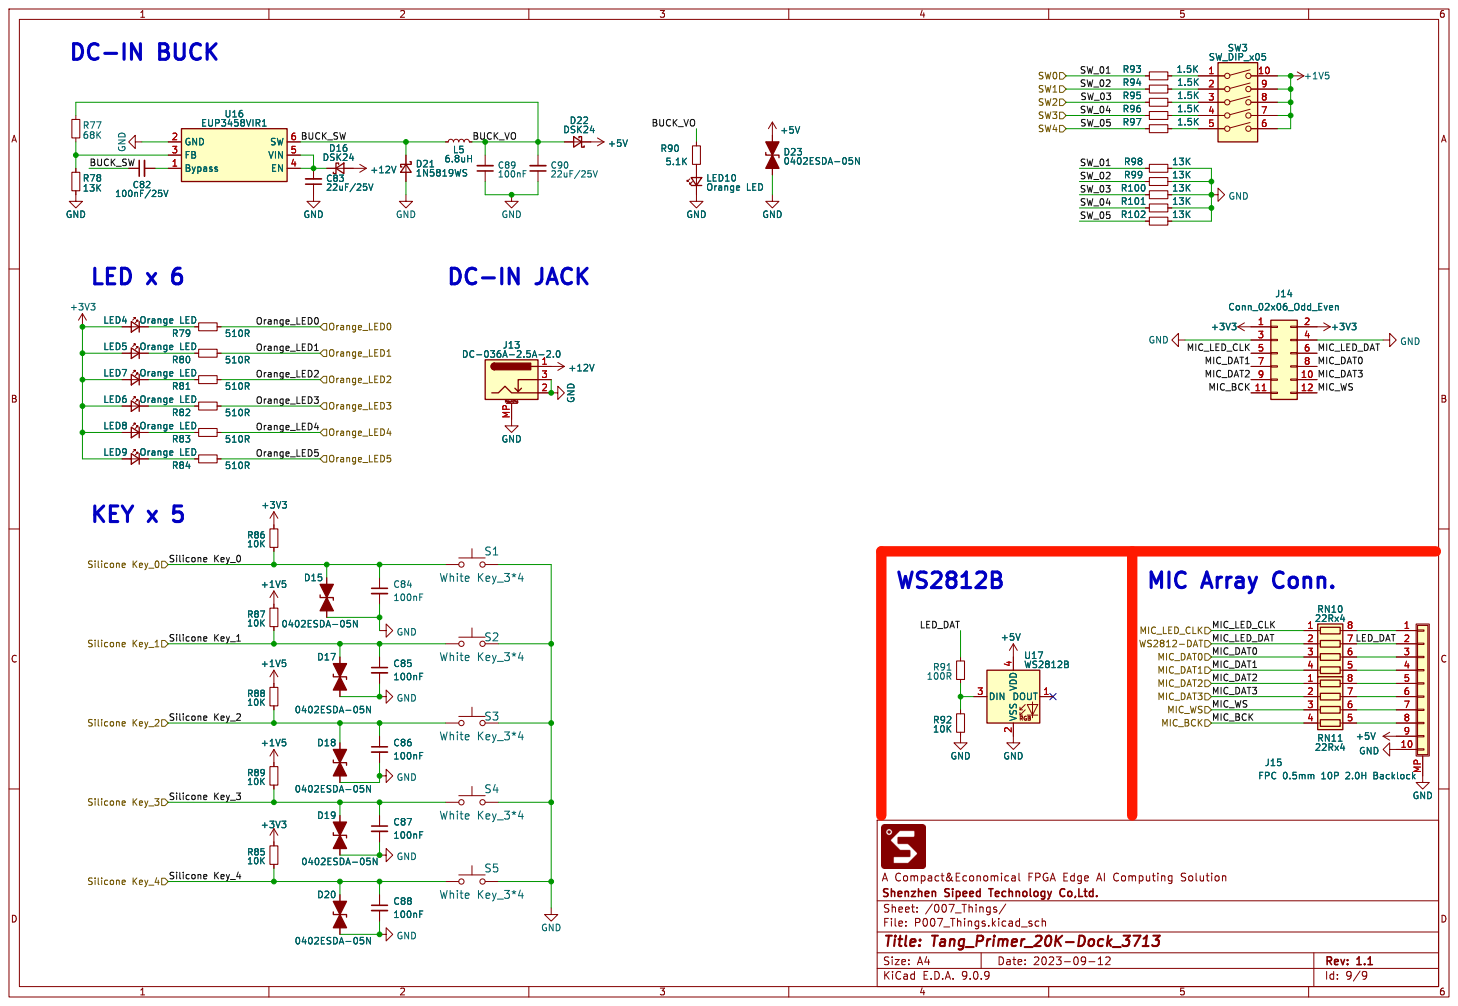
[picture p19: page 9]
