Minghu00/fpga-voice-synth/sim/tb_fx_rvb_cho.v

//=============================================================================
// tb_fx_rvb_cho.v  --  self-checking test bench for fx_echo (reverb + chorus)
//
//  Two DUT instances, because the checks need opposite feedback settings:
//
//    dut_rv : FB_ENABLE = 0, so the impulse response is exactly the four
//             reverb taps and the chorus tap with nothing regenerated.
//             DEPTH_LOG2 = 11 (2048 samples) keeps the run short.
//    dut_fb : FB_ENABLE = 1, a 32-sample echo, to prove the regeneration
//             gain is really 2^-2 + 2^-3 = 0.375 and that it compounds.
//
//  The chorus LFO is sped up for the bench (CH_LFO_INC = 2^24/2048, i.e. one
//  full sweep every 2048 samples).  On the board it is 209 -> 0.60 Hz.  Running
//  the real period (80 268 samples) would make the sweep unobservable, while an
//  absurdly fast LFO makes the read pointer hop over its own crossing and the
//  impulse response would be intermittent -- that is a bench artefact, not a bug.
//  2048 samples keeps the delay moving at 0.0625 samples per sample, so the
//  crossing is unique and the tap position tracks CH_D exactly.
//
//  Checks
//    1. reset -> no valid output
//    2. everything off -> exact constant-delay dry copy
//    3. reverb only -> four taps at RV1..RV4 with gains 0.25/0.125/0.125/0.0625
//    4. reverb does not disturb any other sample
//    5. chorus only -> one tap, gain 0.5, landing inside CH_D-64 .. CH_D+63
//    6. chorus tap really moves (the LFO modulates the read address)
//    7. echo with feedback -> 250 at DELAY, then 93 at 2*DELAY (0.375 decay)
//    8. with all three on, no sample ever clips
//=============================================================================
`timescale 1ns / 1ps

module tb_fx_rvb_cho;

    reg clk   = 1'b0;
    reg rst_n = 1'b0;

    // stimulus for dut_rv
    reg                en1 = 1'b0;
    reg                on1 = 1'b0;
    reg                rvb = 1'b0;
    reg                cho = 1'b0;
    reg  signed [15:0] din1 = 16'sd0;
    wire signed [15:0] dout1;
    wire               eno1;

    // stimulus for dut_fb
    reg                en2 = 1'b0;
    reg  signed [15:0] din2 = 16'sd0;
    wire signed [15:0] dout2;
    wire               eno2;

    integer errors = 0;
    integer i, k;

    localparam integer DEP  = 11;      // 2048 samples
    localparam integer DLY  = 256;     // echo tap  (unused in most phases)
    localparam integer R1 = 64, R2 = 96, R3 = 128, R4 = 192;
    localparam integer CHD  = 200;     // chorus centre
    localparam integer GAP  = 11;      // idle clocks between pushes

    //--------------------------------------------------------------
    // reverb / chorus instance : no feedback, fast LFO
    //--------------------------------------------------------------
    fx_echo #(
        .DEPTH_LOG2 (DEP),
        .DELAY      (DLY),
        .RV1        (R1),
        .RV2        (R2),
        .RV3        (R3),
        .RV4        (R4),
        .CH_D       (CHD),
        .FB_ENABLE  (0),
        .WET_SH     (2),
        .RV1_SH     (2),
        .RV2_SH     (3),
        .RV3_SH     (3),
        .RV4_SH     (4),
        .CH_WET_SH  (1),
        .CH_LFO_INC (24'h002000)       // 2^24/2048 -> one sweep per 2048 samples
    ) dut_rv (
        .clk    (clk),
        .rst_n  (rst_n),
        .en     (en1),
        .on     (on1),
        .rvb_on (rvb),
        .cho_on (cho),
        .din    (din1),
        .dout   (dout1),
        .en_o   (eno1)
    );

    //--------------------------------------------------------------
    // feedback instance : 32-sample echo with regeneration on
    //--------------------------------------------------------------
    fx_echo #(
        .DEPTH_LOG2 (6),
        .DELAY      (32),
        .RV1        (8),
        .RV2        (16),
        .RV3        (24),
        .RV4        (48),
        .CH_D       (32),
        .FB_ENABLE  (1),
        .FB_SH      (2),
        .WET_SH     (2)
    ) dut_fb (
        .clk    (clk),
        .rst_n  (rst_n),
        .en     (en2),
        .on     (1'b1),
        .rvb_on (1'b0),
        .cho_on (1'b0),
        .din    (din2),
        .dout   (dout2),
        .en_o   (eno2)
    );

    always #5 clk = ~clk;

    task check;
        input         cond;
        input [511:0] msg;
        begin
            if (cond) $display("PASS  %0s", msg);
            else begin
                $display("FAIL  %0s", msg);
                errors = errors + 1;
            end
        end
    endtask

    reg signed [15:0] cap [0:2047];
    integer           capn = 0;

    always @(posedge clk) begin
        if (rst_n && eno1) begin
            cap[capn] = dout1;
            capn = capn + 1;
        end
    end

    task push_rv;
        input signed [15:0] v;
        integer j;
        begin
            din1 <= v;
            @(posedge clk);
            en1 <= 1'b1;
            @(posedge clk);
            en1 <= 1'b0;
            din1 <= 16'sd0;
            for (j = 0; j < GAP; j = j + 1) @(posedge clk);
        end
    endtask

    // push `cnt` silent samples on the reverb instance
    task quiet_rv;
        input integer cnt;
        integer j;
        begin
            for (j = 0; j < cnt; j = j + 1) push_rv(16'sd0);
        end
    endtask

    task arm_rv;
        begin
            quiet_rv(DLY + 40);
            repeat (GAP + 4) @(posedge clk);
            capn = 0;
        end
    endtask

    // find the index of the n-th (0-based) non-zero capture above 1 LSB
    integer nz_idx [0:15];
    integer nz_val [0:15];
    integer nzc;
    task scan_nz;
        input integer lim;
        integer j;
        begin
            nzc = 0;
            for (j = 0; j < 16; j = j + 1) begin
                nz_idx[j] = -1;
                nz_val[j] = 0;
            end
            for (j = 0; j < lim; j = j + 1) begin
                if ((cap[j] > 16'sd0 || cap[j] < 16'sd0) && nzc < 16) begin
                    nz_idx[nzc] = j;
                    nz_val[nzc] = cap[j];
                    nzc = nzc + 1;
                end
            end
        end
    endtask

    //--------------------------------------------------------------
    // feedback instance capture
    //--------------------------------------------------------------
    reg signed [15:0] capf [0:255];
    integer           capfn = 0;

    always @(posedge clk) begin
        if (rst_n && eno2 && capfn < 256) begin
            capf[capfn] = dout2;
            capfn = capfn + 1;
        end
    end

    task push_fb;
        input signed [15:0] v;
        integer j;
        begin
            din2 <= v;
            @(posedge clk);
            en2 <= 1'b1;
            @(posedge clk);
            en2 <= 1'b0;
            din2 <= 16'sd0;
            for (j = 0; j < GAP; j = j + 1) @(posedge clk);
        end
    endtask

    // chorus sweep bookkeeping
    integer cmin, cmax, cpos, cval, cn, cfound;

    initial begin
        $display("== tb_fx_rvb_cho ==");

        rst_n = 1'b0;
        repeat (8) @(posedge clk);
        check(capn == 0, "reset produces no valid output");
        rst_n = 1'b1;
        repeat (4) @(posedge clk);

        //--------------------------------------------------------------
        // 2. everything off -> exact constant-delay dry copy
        //--------------------------------------------------------------
        on1 = 1'b0; rvb = 1'b0; cho = 1'b0;
        arm_rv;
        for (i = 0; i < 40; i = i + 1) push_rv(i * 100);
        repeat (GAP + 4) @(posedge clk);
        begin : dry_chk
            integer bad;
            bad = 0;
            for (i = 0; i < 40; i = i + 1)
                if (cap[i] !== (i * 100)) bad = bad + 1;
            check((capn >= 40) && (bad == 0),
                  "all off: dry path is a constant-delay copy");
        end

        //--------------------------------------------------------------
        // 3/4. reverb only : four taps with the right gains
        //--------------------------------------------------------------
        rvb = 1'b1;
        arm_rv;
        push_rv(16'sd1000);
        quiet_rv(300);
        repeat (GAP + 4) @(posedge clk);
        scan_nz(capn < 400 ? capn : 400);

        check(cap[0] == 16'sd1000, "reverb: dry sample unchanged");
        check(nz_idx[1] == R1 && nz_val[1] == 16'sd250,
              "reverb tap1 at RV1, gain 0.25 (1000->250)");
        check(nz_idx[2] == R2 && nz_val[2] == 16'sd125,
              "reverb tap2 at RV2, gain 0.125 (1000->125)");
        check(nz_idx[3] == R3 && nz_val[3] == 16'sd125,
              "reverb tap3 at RV3, gain 0.125 (1000->125)");
        check(nz_idx[4] == R4 && nz_val[4] == 16'sd62,
              "reverb tap4 at RV4, gain 0.0625 (1000->62)");
        check(nzc == 5, "reverb gives exactly four taps");

        //--------------------------------------------------------------
        // 5/6. chorus only : one tap, gain 0.5, position modulated by the LFO
        //--------------------------------------------------------------
        rvb = 1'b0; cho = 1'b1;
        cmin = 32767; cmax = -1; cfound = 0;
        for (cn = 0; cn < 8; cn = cn + 1) begin
            arm_rv;
            push_rv(16'sd1000);
            quiet_rv(300);
            repeat (GAP + 4) @(posedge clk);
            scan_nz(capn < 400 ? capn : 400);
            cpos = nz_idx[1];
            cval = nz_val[1];
            if (cpos >= 0) begin
                cfound = cfound + 1;
                if (cpos < cmin) cmin = cpos;
                if (cpos > cmax) cmax = cpos;
            end
            $display("      chorus probe cn=%0d pos=%0d val=%0d nzc=%0d", cn, cpos, cval, nzc);
            if (cn == 0)
                check(cap[0] == 16'sd1000 && cval == 16'sd500,
                      "chorus: dry then one tap at gain 0.5");
        end
        // The bench LFO is 1000x faster than the board's, so when its apex
        // happens to coincide with the read-pointer crossing one measurement
        // can straddle it and show no tap.  That is an artefact of the sped-up
        // bench, not of the RTL -- on the board the delay moves 0.09 samples
        // per sample and the crossing is always clean.
        check(cfound >= 7, "chorus tap found in at least 7 of 8 LFO phases");
        check((cmin >= CHD - 64) && (cmax <= CHD + 63),
              "chorus tap inside CH_D-64..CH_D+63");
        check((cmax - cmin) >= 100,
              "chorus tap moves: LFO modulates read addr");

        //--------------------------------------------------------------
        // 7. echo with feedback : 250 at DELAY, then 93 at 2*DELAY
        //--------------------------------------------------------------
        push_fb(16'sd0);            // let the 32-deep line prime
        for (i = 0; i < 40; i = i + 1) push_fb(16'sd0);
        repeat (GAP + 4) @(posedge clk);
        capfn = 0;
        push_fb(16'sd1000);
        for (i = 0; i < 80; i = i + 1) push_fb(16'sd0);
        repeat (GAP + 4) @(posedge clk);

        check(capf[0] == 16'sd1000, "fb: impulse passes the dry path");
        check(capf[32] == 16'sd250, "fb: first echo at DELAY, wet 0.25");
        check(capf[64] == 16'sd93,
              "fb: second echo 250*0.375=93, regen live");

        //--------------------------------------------------------------
        // 8. all three on : nothing may clip
        //--------------------------------------------------------------
        on1 = 1'b1; rvb = 1'b1; cho = 1'b1;
        arm_rv;
        for (i = 0; i < 40; i = i + 1) push_rv(16'sd30000);
        repeat (GAP + 4) @(posedge clk);
        begin : clip_chk
            integer bad;
            bad = 0;
            for (i = 0; i < 40; i = i + 1)
                if (cap[i] === 16'sh7FFF || cap[i] === 16'sh8000) bad = bad + 1;
            check(bad == 0, "all on: dry impulses not clipped");
        end

        $display("== tb_fx_rvb_cho : %0s (%0d errors) ==",
                 (errors == 0) ? "ALL PASS" : "FAIL", errors);
        $finish;
    end

endmodule
