Minghu00/fpga-voice-synth/(commit log)

2026-10-24 chore: 整理前的完整工程快照（基线）
    这是重组目录结构之前的基线提交，用于后续改动可回溯、可对比。
    包含：
    - rtl/ 21 个源文件，全部平铺
    - sim/ 12 个 testbench + TTP229 行为模型 + PLL 仿真替身
    - constraints/ inst / poly_synth / lcd_test / lcd_only 四套约束
    - docs/ TTP229 数据手册
    - legacy/ 第一代手工 synth_voice 设计（已废弃，仅存档）
    - 七个设计文档 + 赛题目录 PDF + 板卡资料
2026-10-24 refactor: 按功能板块重组 rtl/ 目录，预留扩展位
    功能零改动：位流尺寸、资源用量、Fmax、35 个端口管脚全部与基线一致，
    七个 testbench 全部 ALL PASS。详见下方"等价性验证"。
    目录结构
    rtl/top/ top_inst.v 顶层
    rtl/clock/ pll_sys.v 27 MHz -> 108 MHz
    rtl/input/ ttp229_rx.v 触摸两线轮询
    keymap8.v 键位图 -> 音名/门控/音量
    rtl/audio/ frame_gen.v 帧内四时隙相位发生器
    inc_lut.v 音名 -> 32 位相位增量
    sine_rom.v 1024x16 有符号正弦表
    sine_1024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
2026-10-24 feat(P0): 现场测试模式 —— 8 路纯正弦，对应赛题评分③
    上电时按住 Key_3（vup_sw / D7），复位释放后 1 ms 窗口内检测到按键
    即锁存 test_en（粘性，断电退出）。锁存后：
    - gate 强制全 1，note_flat 强制为 8 个隔 3 个半音的音
    （C4 D#4 F#4 A4 C5 D#5 F#5 A5 = 261.6/311.1/370.0/440.0/
    523.3/622.3/740.0/880.0 Hz，最小间距 49.5 Hz）
    - timbre 强制 0（管风琴 = 只有 comp0 非零）→ 每声部一根纯正弦，
    频谱上是 8 根互不重叠、可逐个数清的谱峰
    - oct 强制 0（确定性，且避开 C6 x4 x4 的 32 位溢出）
    - vol 强制 2（1.0x，8 路叠加不撞限幅器，避免削波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
2026-10-25 feat(P3): 多波表 —— 4 个加法分量各读一张独立波表，坐实 32 个独立振荡器
    对应赛题评分①：原本 4 个分量共用一张正弦表，按「单波表查表只计 1 个振荡器」
    会被压到 8 个。现在分量 c 读表 c：comp0 正弦@1f、comp1 三角@2f、
    comp2 锯齿@3f、comp3 方波@4f，4 个独立相位累加器 + 4 张独立波表 + 4 个
    独立幅度 = 8 声部 x 4 = 32 个真正独立的波表振荡器。
    新增/删除
    - 新增 rtl/audio/wavetable_bank.v：4 张表合成一块 4096x16 BSRAM，
    {tab_sel,addr} 寻址，读延迟仍 1 拍、单读端口，osc_bank 槽流水线零改动
    - 新增 rtl/audio/wav_bank_4096.mem：4096 行 x16 有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
2026-10-25 feat(P2): 颤音 / 滑音 / 板内延迟 —— 拓展②拿到表情 2/3、效果 1/3
    新增三个能力，全部纯 FPGA 内部实现，不新增任何管脚：
    1. 颤音 vibrato_lfo.v
    1024 点 Q10 正弦表（1 点 = 1 采样），相位增量 INC=1740 →
    实测 4.998 Hz。乘性调制 inc*(1024+(vib*DEPTH>>10))>>10，DEPTH=17
    → ±17 cent。LFO 全局共用一个实例（各声部同相，听感自然）。
    2. 滑音（做进 osc_bank 帧尾预计算，未新建独立模块）
    inc_org[v] += (tgt_inc - inc_org[v]) >>> 8，指数逼近，时间常数 ≈95 ms。
    目标由「最近进入的键」给出（glide_idx，按 key_rise 优先级编码）。
    每次逼近只花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
    [fx_echo.v, lcd_scope.v, osc_bank.v, tb_fx_echo.v, tb_inst.v, tb_osc_bank.v, top_inst.v]
2026-10-25 feat(P2): 滑音 / 颤音 / 板内延迟 —— 赛题拓展②
    - vibrato_lfo.v: 24 位相位累加 + 32 项四分之一正弦表(纯 LUT)，
    PH_INC=1740 -> 4.998 Hz，DEPTH=18 -> ±30 cent 乘性调制
    - fx_echo.v: 8192x16 BSRAM 环，D=6000 -> 124.4 ms，反馈 0.375 湿声 0.25
    写回通路拆三级 en 流水(抓 tap -> 算增益 -> 写回)，Fmax 108.3 -> 116.540
    - osc_bank.v: 帧尾预计算段插入滑音指数逼近(>>8, ~95 ms)与颤音乘性调制
    - keymap8.v: Key_2 长按 0.8 s 切 8 档 fx_mode(短按仍是锁存模式)
    - 修 lead_note stride-4 切片 bug：TP3 原本滑到 TP5 的音阶，
    改成显式 8:1 mux + 寄存器，tb_inst 补 2 项音高断言
    - tb_inst 扩到 52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
    [fx_echo.v, tb_inst.v, top_inst.v]
2026-10-25 feat(P1a/b): 显示页切换 + 16 bin 实时频谱
    - 长按 Key_2 超 1.6s 在波形页 / 频谱页之间切换（零新增管脚）
    - 新增 rtl/display/spectrum16.v：512 点三角窗 DFT，16 bin，94.17 Hz/bin，
    2 块 sin/cos BSRAM + 2 个乘法器时分复用，AGC 每档 3 dB
    - lcd_scope 增加频谱页与显示页阶梯，柱高提前一级译码
    - 颤音 LFO 内联进 top_inst（原 vibrato_lfo.v 因输出无人使用被综合删掉），
    vib_abs 接到显示让 FX 阶梯随 LFO 呼吸
    - 时序四轮抢救：59.3 -> 74.0 -> 98.2 -> 104.6 -> 108.437 MHz（余量 0.037 ns）
    - 新增 tb_spectrum16 / tb_spec_cont / tb_vib_path，14 平台全绿
    - 0 告警，35 管脚未变，Logic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
    [lcd_scope.v, spectrum16.v, tb_inst.v, tb_spec_cont.v, tb_spectrum16.v, tb_vib_path.v, top_inst.v]
2026-10-25 feat(P1c): Lissajous X-Y display page -- real stereo L/R figure
    Adds a third display page: left channel on X, right channel on Y.
    - rtl/display/liss_render.v: pre-renders 512 stereo samples into a
    512x16 per-column vertical span table (1 BSRAM) entirely inside vertical
    blanking (3584 clk against an 88200 clk budget). Empty columns are marked
    {ymax=0, ymin=255}; both axes clamp so a saturated peak cannot wrap.
    - rtl/audio/mixer16.v: slight per-voice panning (+-12.5%) with out_l/out_r,
    keeping L+R = 2*mix so mono compatibility is preserved. Without different
    L/R content an X-Y plot is just a diagonal line.
    - rtl/display/wave_buf.v: stereo (512x32 {R,L}); a second instance is owned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
2026-10-26 feat(P2): in-board reverb + chorus -- 6 taps time-shared on one delay line
    The 8192x16 BSRAM ring already used by the echo is now shared by three
    effects. They differ only in where the samples are taken from, so six taps
    are read one per clock instead of instantiating three rings (which would
    cost 24 BSRAM blocks out of a 46 block budget).
    Taps
    0 DELAY = 6000 (124.4 ms) 0.2500 delay
    1 RV1 = 1784 ( 37.0 ms) 0.2500 reverb
    2 RV2 = 2555 ( 53.0 ms) 0.1250 reverb
    3 RV3 = 3424 ( 71.0 ms) 0.1250 reverb
    4 RV4 = 4677 ( 97.0 ms) 0.0625 reverb
    5 CH_D = 1024 +-64 (21.2 ms) 0.5 chorus (0.60 Hz triangle LFO)
    fx_mode is now a PRESET index, not a bit mask:
    0 by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
2026-10-27 fix(audio): soft limiter + volume floor -- cures tremble on stacked notes
    Root cause of "sounds like tremble when several notes are stacked in latch
    mode": the chain had no head room at all.
    * mixer16 normalises 8 voices to full scale (MIX_SHIFT=3)
    * audio_out defaulted to 4.0x (vol_idx=6)
    * the volume key could only go UP (vol_idx 6..10)
    Four notes gave x=32752, five and beyond hard-clipped to 32767. A clipped
    sine becomes a square, and the square intermodulates with every partial,
    producing |f1-f2| beating at 5..40 Hz -- exactly the "tremble" reported.
    Fixes
    * audio_out.v: two-segment soft limiter, knee at 24576 (3/4 FS), slope 1/8
    above it, symmetric. Below the knee the r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
    [audio_out.v, keymap8.v, lcd_scope.v, mixer16.v, tb_audio_out.v]
2026-10-27 fix(audio): sign-extend the fx_echo sums -- cures the tremble on stacked notes
    The wet/write-back sums were built as {din_q[15], din_q}. A Verilog
    concatenation is always UNSIGNED, so a negative sample turned into 131061
    and sat16 clamped the result to +32767: every negative half cycle was
    replaced by a full-scale positive DC, which is heard as a tremble.
    Declaring the operands signed and adding them directly lets Verilog
    sign-extend, fixes the polarity, and drops one 17-bit extend level
    (Fmax 110.372 -> 114.0 MHz, slack +0.199 -> +0.487 ns).
    tb_fx_echo only ever used positive vectors; it now drives negative
    ramps and a negative impulse (5 new assertions, 13 total).
    Docs: section 12 of do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
    [fx_echo.v, tb_fx_echo.v]
2026-10-28 fix(inst): latch taps survive the chip's single-key alternating reports
    The two-note "tremble" had two independent causes. The sign-extension fix
    in a8d98e8 removed one; this removes the other.
    The TTP229 module ships strapped for its default single-key mode, so with two
    fingers down it reports ONE pad per 32 ms scan and may hand out a different
    pad on the next scan. The latch rule was
    latch <= latch ^ key_rise; // key_rise = gate_live & ~key_d
    so pad A lit its note when it won the scan, and the very next scan -- when pad
    B won instead -- made ~key_d produce a fresh rising edge on A and toggled A
    straight back off. Both latched notes flipped on and off a few dozen times a
    seco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
    [tb_inst.v, tb_latch.v, top_inst.v]
2026-10-28 feat(keymap): C major arpeggio pad layout -- kills the 30 Hz whole-tone beat
    The 8 pads were mapped to the C major scale (C4 D4 E4 F4 G4 A4 B4 C5), so
    every pair of neighbouring pads was a whole or half tone apart. Two pure
    tones that close beat at |f1-f2|; for C4+D4 that is 32 Hz, i.e. the envelope
    collapses to nearly zero ~30 times a second. Measured on the real RTL with
    sim/_an2.v: spectrum was exactly two clean lines (263.95 / 293.27 Hz, nothing
    else above -34 dB), envelope ripple 29.67 Hz at 20.3 dB depth, zero clamped
    samples -- so the digital path was already a mathematically exact sum of two
    sines. The tremble was the interval, not the signal.
    Map the pads to an ascending C major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
2026-10-29 fix(inst): sticky gate -- two pads now really sound together
    [adsr.v, top_inst.v]
2026-10-29 Revert "fix(inst): sticky gate -- two pads now really sound together"
    This reverts commit 797e68e259de43d170a68695b5d36c1238f89a68.
    [adsr.v, top_inst.v]
2026-10-30 fix(scope): 1024-deep wave history + voice-0 trigger -- the trace no longer jumps
    The waveform page restarted its window at a *trigger point* that had to be at
    least 480 samples old, but history was only 512 deep, so the legal trigger
    region was just 32 samples. Single notes looked fine because any start phase
    looks alike; a chord's crossings drift with the beat, so every frame latched a
    different point of the beat envelope and the picture flickered.
    - rtl/display/wave_hist.v: new 1024x16 single-clock BSRAM (16 Kbit, still one
    block) for the waveform page. 16 bit, not 8: the box is 136 rows, an 8-bit
    sample would quantise to a visible 8-row staircase.
    - rtl/display/lcd_scope.v: wavefo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
    [lcd_scope.v, tb_inst.v, top_inst.v, wave_hist.v]
2026-10-30 fix(scope): single-shot waveform capture -- the trace finally stands still
    The waveform page scrolled: every LCD frame consumed 804 audio samples while
    the history was only 1024 deep, so any trigger anchored on the write pointer or
    on a zero crossing landed on a different slice of the beat envelope each frame.
    Fixing the triggers was not enough -- a scrolling display of a periodic signal
    cannot be made to stand still at this sample-rate/frame-rate ratio.
    Replace the whole trigger machinery (cz/cz_age/pk_ev/pk_age/tsel/tok, the
    envelope-peak detector and the mix-prev comparator) with one capture:
    * on any change of the pressed-pad set, wait SETTLE = 14460 samples (300 ms)
    for the atta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
    [lcd_scope.v, tb_inst.v, tb_scope_snap.v, top_inst.v]
2026-11-03 docs: generate the technical document from the official template
    Adds scripts/build_tech_doc.py (python-docx, keeps the template's sections and styles), the two schematic figures used by it, and the three-page display mock rendered from the RTL numbers.
